STHY0425/LeRobot-Anything-U-Arm-main/src/simulation/mani_skill/agents/robots/humanoid/mujoco_humanoid.png

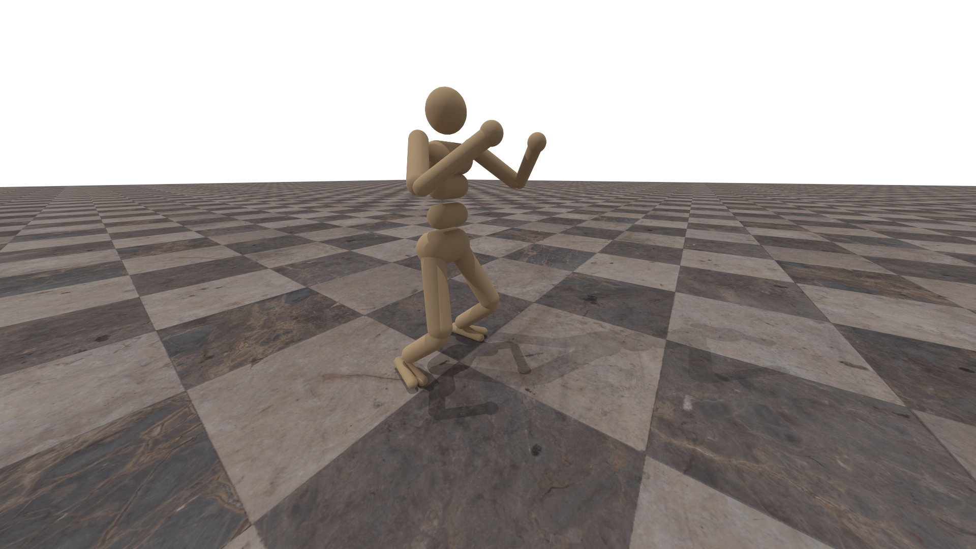
src/simulation/mani_skill/agents/robots/humanoid/mujoco_humanoid.png
