STHY0425/LeRobot-Anything-U-Arm-main/src/simulation/mani_skill/assets/robots/fetch/fetch_description/meshes/base_link_uv.png

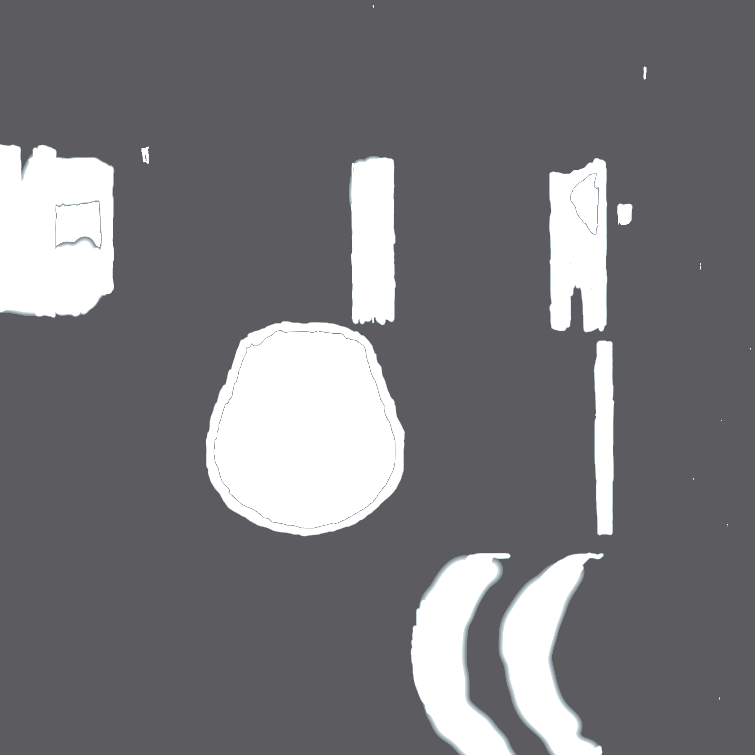
src/simulation/mani_skill/assets/robots/fetch/fetch_description/meshes/base_link_uv.png
