STHY0425/LeRobot-Anything-U-Arm-main/src/simulation/mani_skill/envs/tasks/humanoid/assets/cardboard_box/01.png

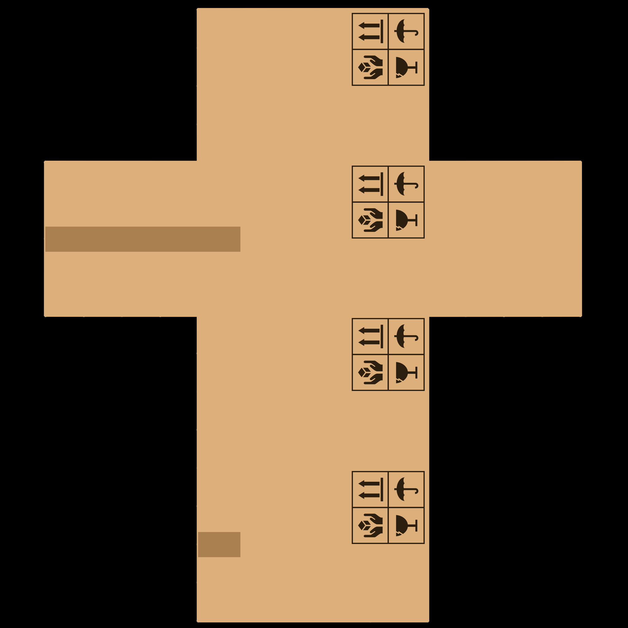
src/simulation/mani_skill/envs/tasks/humanoid/assets/cardboard_box/01.png
