STHY0425/LeRobot-Anything-U-Arm-main/src/simulation/mani_skill/assets/robots/trifinger/robot_properties_fingers/meshes/BL-M_Table_ASM_big.stl

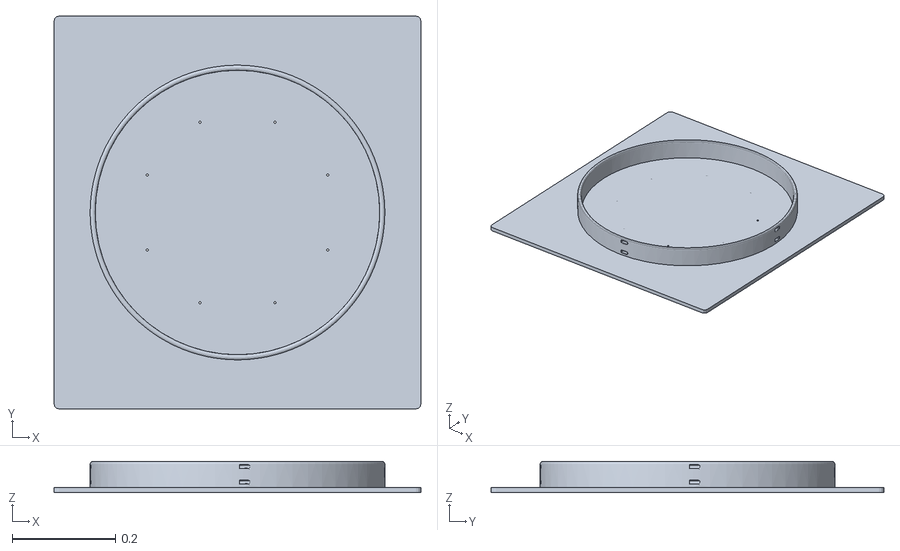
[picture p15: CAD file, 2026-03-09]
src/simulation/mani_skill/assets/robots/trifinger/robot_properties_fingers/meshes/BL-M_Table_ASM_big.stl
0.71 x 0.76 x 0.06
