STHY0425/LeRobot-Anything-U-Arm-main/src/simulation/mani_skill/assets/robots/trifinger/robot_properties_fingers/meshes/BL-M_Table_ASM_small.stl

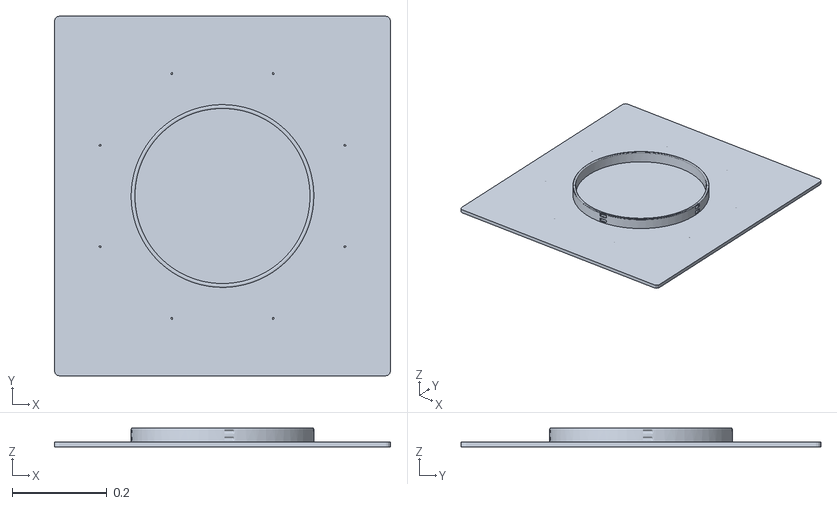
[picture p16: CAD file, 2026-03-09]
src/simulation/mani_skill/assets/robots/trifinger/robot_properties_fingers/meshes/BL-M_Table_ASM_small.stl
0.71 x 0.76 x 0.04
