STHY0425/LeRobot-Anything-U-Arm-main/mechanical/Feetech_servo/Config1_STL/config1 - sitter-1.STL

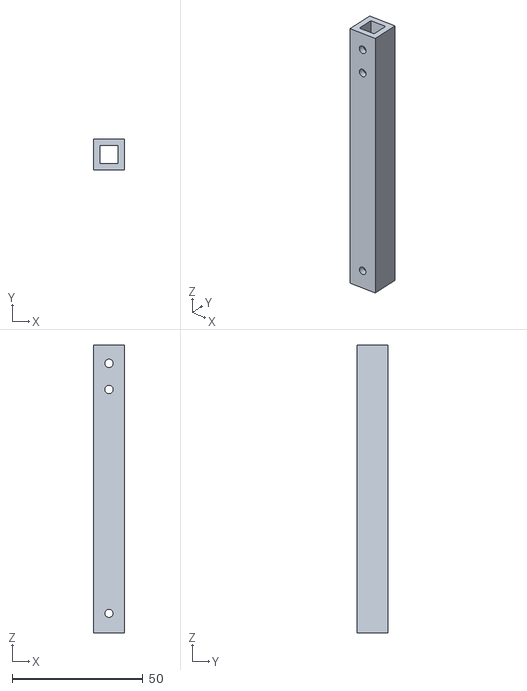
[picture p17: CAD file, 2026-03-09]
mechanical/Feetech_servo/Config1_STL/config1 - sitter-1.STL
12.0 x 12.0 x 110.0
