STHY0425/LeRobot-Anything-U-Arm-main/mechanical/Feetech_servo/Config2_STL/config2 - link1-1.STL

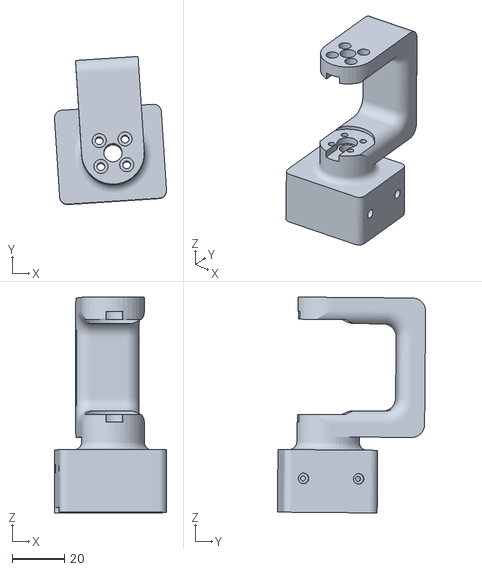
[picture p18: CAD file, 2026-03-09]
mechanical/Feetech_servo/Config2_STL/config2 - link1-1.STL
42.9 x 56.7 x 82.7
