STHY0425/LeRobot-Anything-U-Arm-main/mechanical/Feetech_servo/Config3_STL/config3 - trigger_short-1.STL

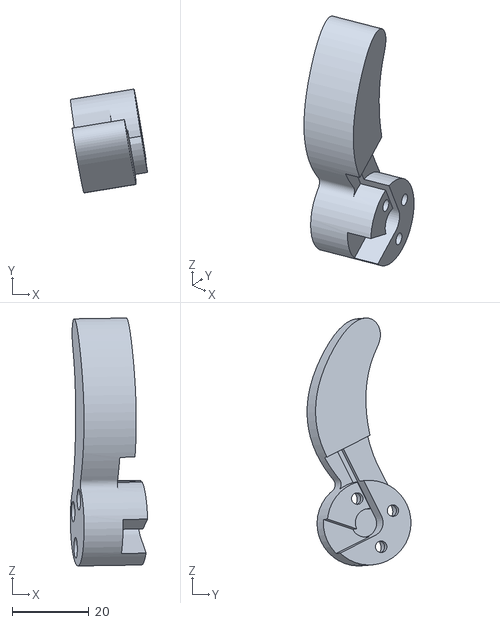
[picture p19: CAD file, 2026-03-09]
mechanical/Feetech_servo/Config3_STL/config3 - trigger_short-1.STL
20.1 x 27.0 x 64.4
