STHY0425/LeRobot-Anything-U-Arm-main/mechanical/Zhonglin_servo/Config1_STL/Config1 - trigger_handle-1.STL

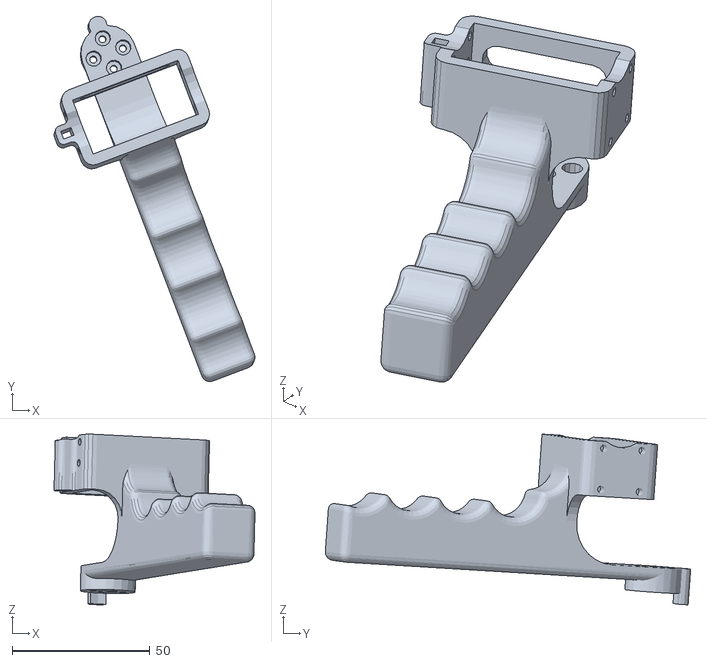
[picture p20: CAD file, 2026-03-09]
mechanical/Zhonglin_servo/Config1_STL/Config1 - trigger_handle-1.STL
73.0 x 132.8 x 62.0
