STHY0425/LeRobot-Anything-U-Arm-main/mechanical/Zhonglin_servo/Config2_STL/Config2 - link_1-2.STL

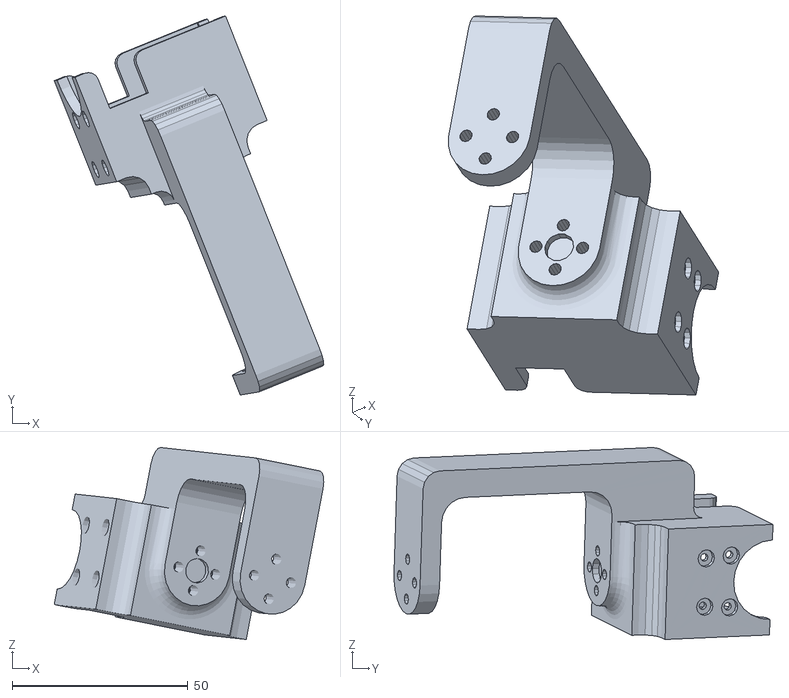
[picture p21: CAD file, 2026-03-09]
mechanical/Zhonglin_servo/Config2_STL/Config2 - link_1-2.STL
76.7 x 107.8 x 54.6
