STHY0425/LeRobot-Anything-U-Arm-main/mechanical/Zhonglin_servo/Config3_STL/Config3 - link_1-1.STL

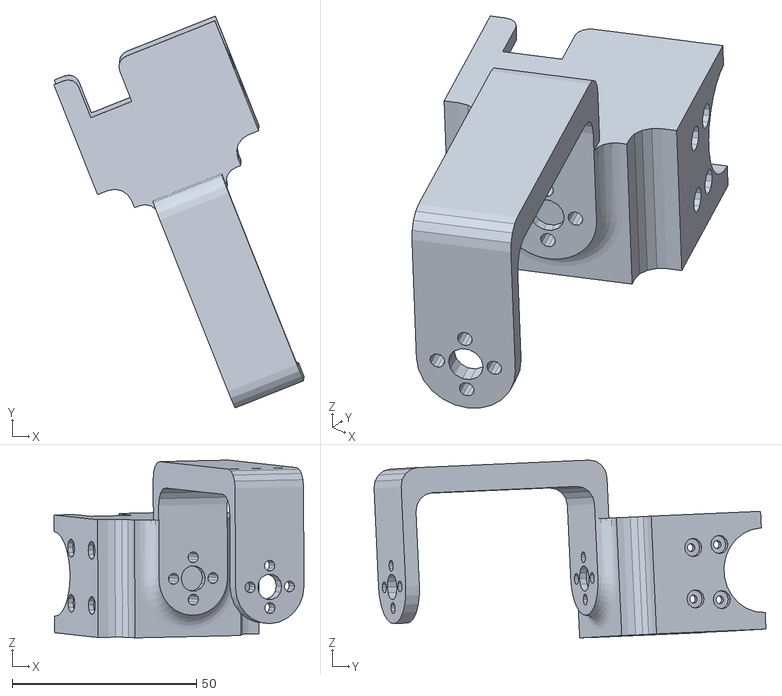
[picture p22: CAD file, 2026-03-09]
mechanical/Zhonglin_servo/Config3_STL/Config3 - link_1-1.STL
67.9 x 106.4 x 48.3
