STHY0425/LeRobot-Anything-U-Arm-main/src/simulation/mani_skill/assets/robots/ability_hand/meshes/collision/thumb-F2_C.obj

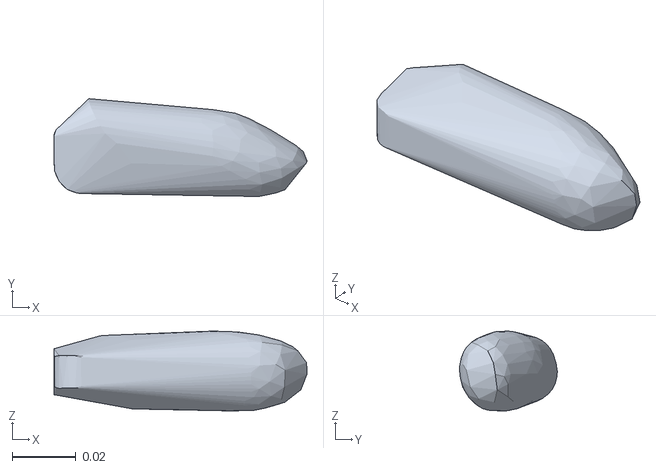
[picture p23: CAD file, 2026-03-09]
src/simulation/mani_skill/assets/robots/ability_hand/meshes/collision/thumb-F2_C.obj
0.0793 x 0.0306 x 0.025
