STHY0425/LeRobot-Anything-U-Arm-main/src/simulation/mani_skill/assets/robots/ability_hand/meshes/visual/FB_palm_ref_MIR.obj

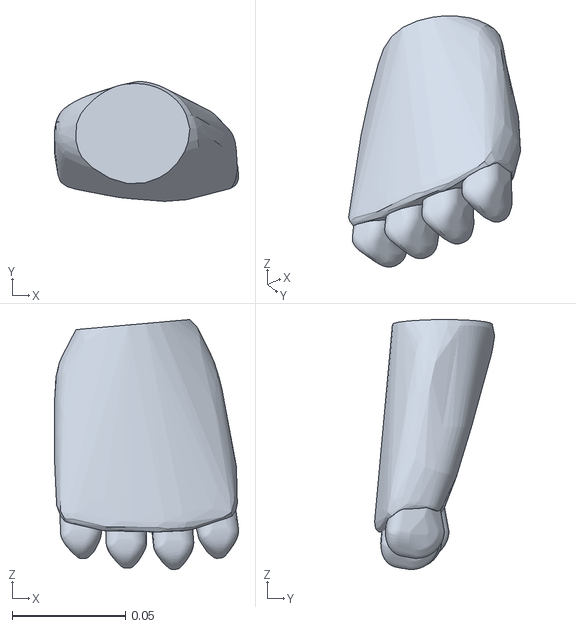
[picture p24: CAD file, 2026-03-09]
src/simulation/mani_skill/assets/robots/ability_hand/meshes/visual/FB_palm_ref_MIR.obj
0.0816 x 0.053 x 0.111
