STHY0425/LeRobot-Anything-U-Arm-main/src/simulation/mani_skill/assets/robots/allegro/meshes/collision/link_tip.obj

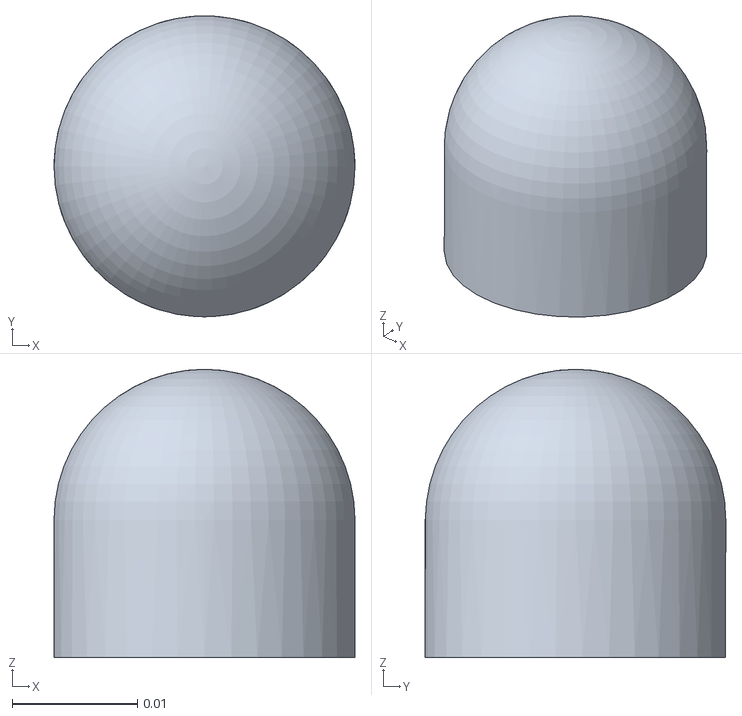
[picture p25: CAD file, 2026-03-09]
src/simulation/mani_skill/assets/robots/allegro/meshes/collision/link_tip.obj
0.024 x 0.024 x 0.023
