STHY0425/LeRobot-Anything-U-Arm-main/src/simulation/mani_skill/assets/robots/allegro/variation/meshes/visual/tactile.obj

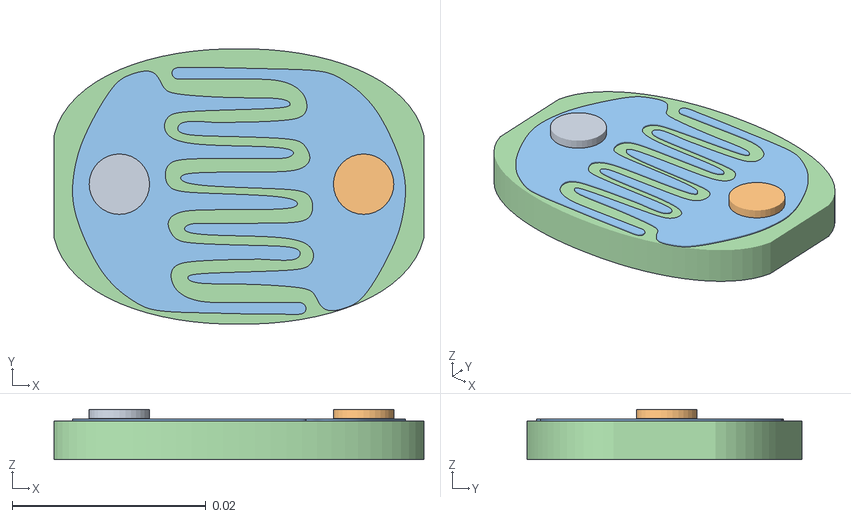
[picture p28: CAD file, 2026-03-09]
src/simulation/mani_skill/assets/robots/allegro/variation/meshes/visual/tactile.obj
0.0382 x 0.0284 x 0.00519
LIGHT_CATCHER_2
photocell
