STHY0425/LeRobot-Anything-U-Arm-main/src/simulation/mani_skill/assets/robots/ARX-X5/meshes/link3.STL

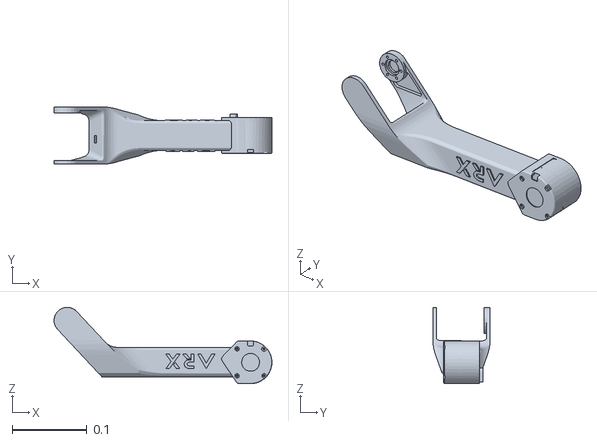
[picture p29: CAD file, 2026-03-09]
src/simulation/mani_skill/assets/robots/ARX-X5/meshes/link3.STL
0.291 x 0.0765 x 0.102
