STHY0425/LeRobot-Anything-U-Arm-main/src/simulation/mani_skill/assets/robots/dclaw/meshes/collision/finger_tip.obj

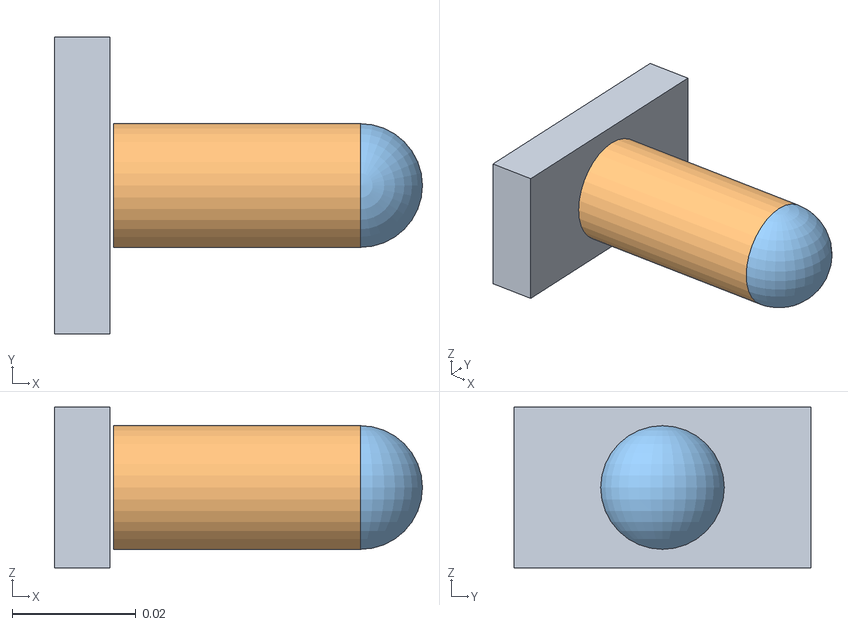
[picture p30: CAD file, 2026-03-09]
src/simulation/mani_skill/assets/robots/dclaw/meshes/collision/finger_tip.obj
0.0595 x 0.048 x 0.026
