STHY0425/LeRobot-Anything-U-Arm-main/src/simulation/mani_skill/assets/robots/dclaw/meshes/visual/link_1.obj

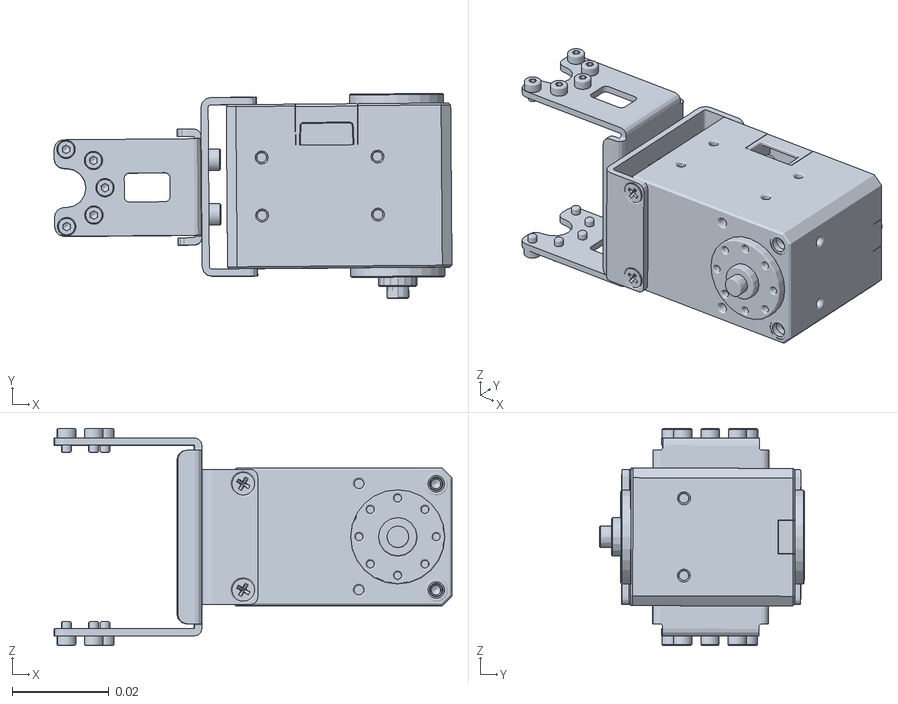
[picture p31: CAD file, 2026-03-09]
src/simulation/mani_skill/assets/robots/dclaw/meshes/visual/link_1.obj
0.0824 x 0.0425 x 0.045
