STHY0425/LeRobot-Anything-U-Arm-main/src/simulation/mani_skill/assets/robots/fetch/fetch_description/meshes/l_gripper_finger_link.STL

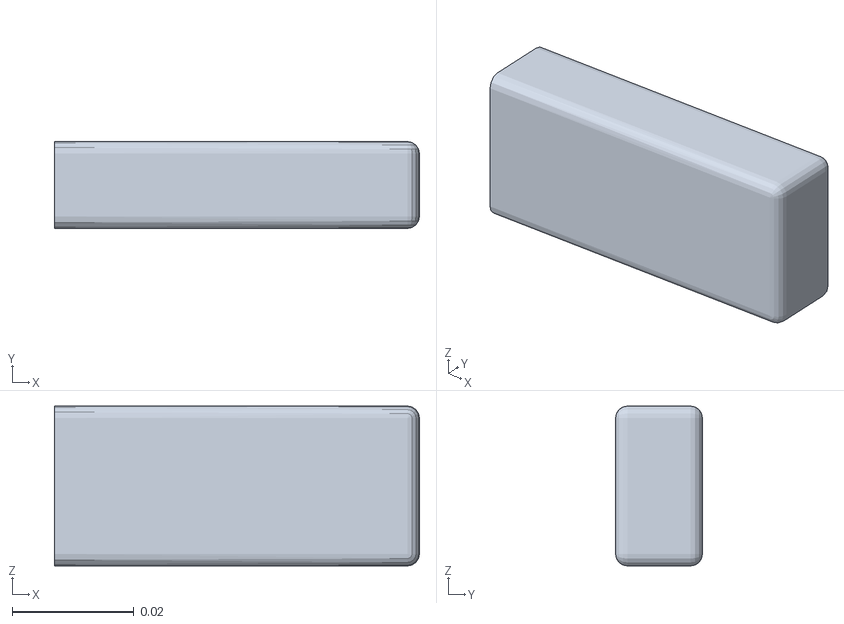
[picture p32: CAD file, 2026-03-09]
src/simulation/mani_skill/assets/robots/fetch/fetch_description/meshes/l_gripper_finger_link.STL
0.06 x 0.0143 x 0.0263
