STHY0425/LeRobot-Anything-U-Arm-main/src/simulation/mani_skill/assets/robots/fetch_xlerobot/meshes/Fixed_Jaw_part1.ply.convex.stl

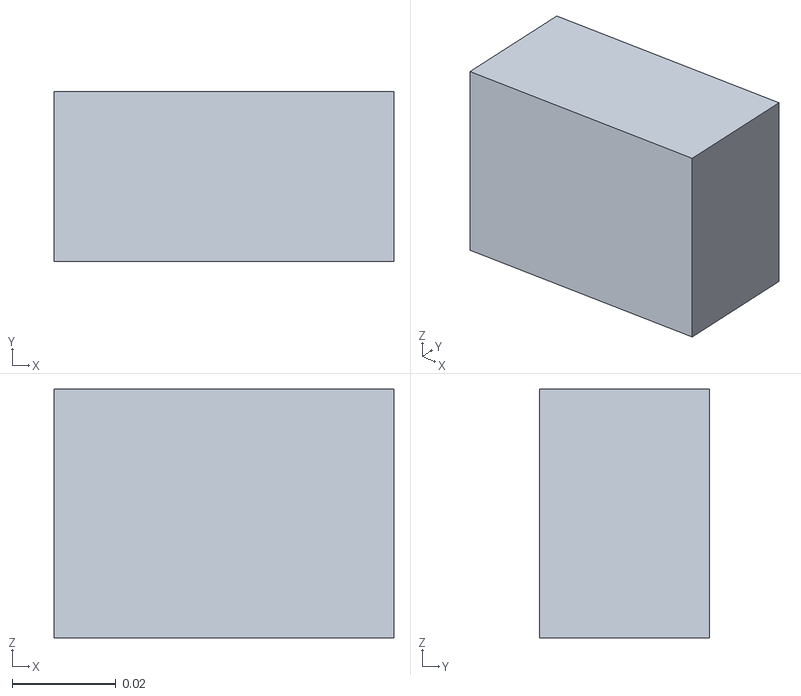
[picture p33: CAD file, 2026-03-09]
src/simulation/mani_skill/assets/robots/fetch_xlerobot/meshes/Fixed_Jaw_part1.ply.convex.stl
0.0656 x 0.0328 x 0.048
