STHY0425/LeRobot-Anything-U-Arm-main/src/simulation/mani_skill/assets/robots/g1_humanoid/meshes/right_two_link.STL

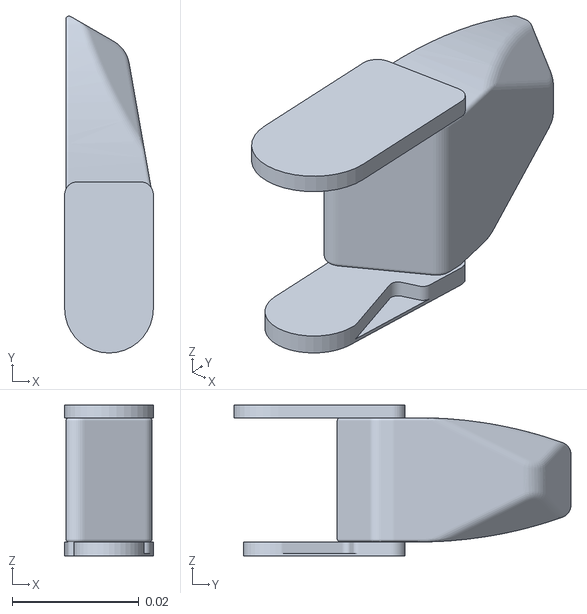
[picture p34: CAD file, 2026-03-09]
src/simulation/mani_skill/assets/robots/g1_humanoid/meshes/right_two_link.STL
0.014 x 0.0532 x 0.0238
