STHY0425/LeRobot-Anything-U-Arm-main/src/simulation/mani_skill/assets/robots/koch/meshes/link_2.stl

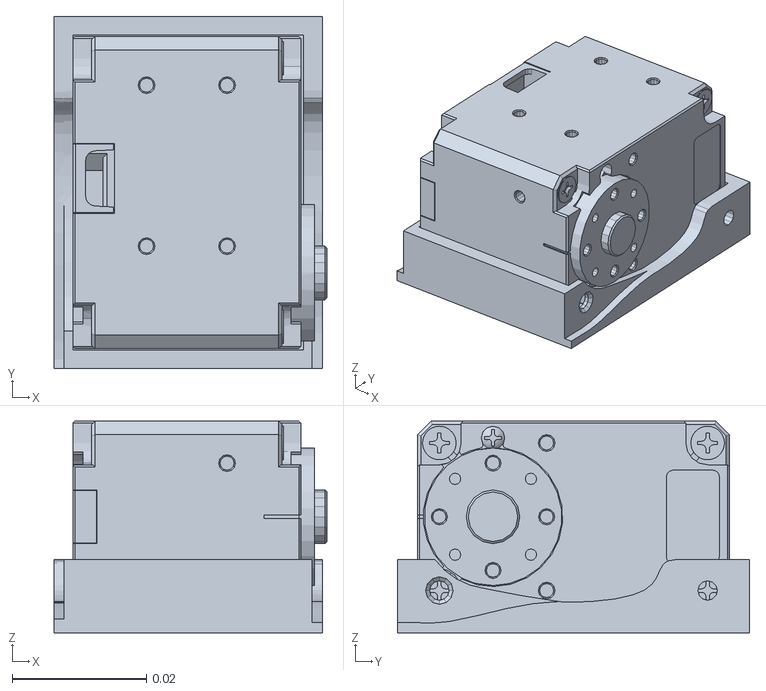
[picture p35: CAD file, 2026-03-09]
src/simulation/mani_skill/assets/robots/koch/meshes/link_2.stl
0.0407 x 0.0525 x 0.0316
