STHY0425/LeRobot-Anything-U-Arm-main/src/simulation/mani_skill/assets/robots/panda/franka_description/meshes/collision/link6.stl.convex.stl

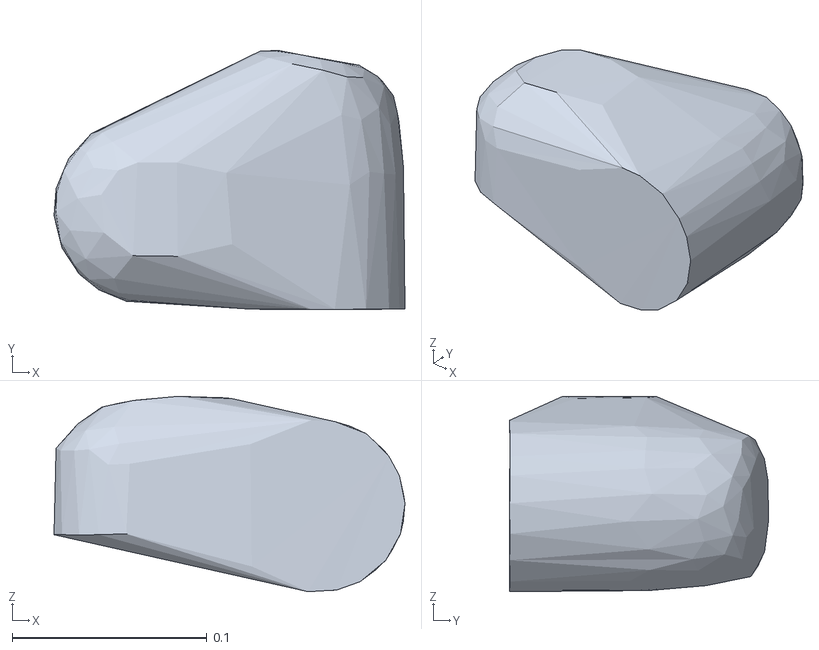
[picture p36: CAD file, 2026-03-09]
src/simulation/mani_skill/assets/robots/panda/franka_description/meshes/collision/link6.stl.convex.stl
0.18 x 0.133 x 0.1
