STHY0425/LeRobot-Anything-U-Arm-main/src/simulation/mani_skill/assets/robots/panda/sciurus17_description/meshes/collision/Body.stl

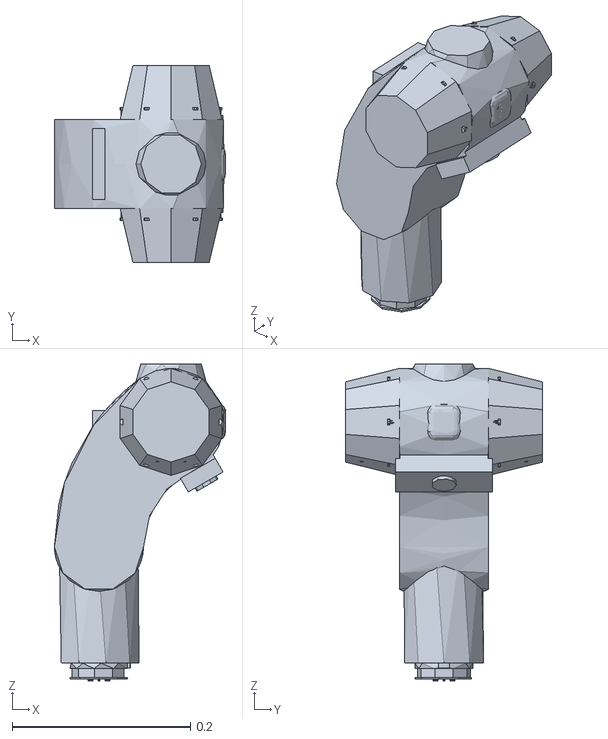
[picture p38: CAD file, 2026-03-09]
src/simulation/mani_skill/assets/robots/panda/sciurus17_description/meshes/collision/Body.stl
0.192 x 0.221 x 0.356
