STHY0425/LeRobot-Anything-U-Arm-main/src/simulation/mani_skill/assets/robots/piper/meshes/link1.STL

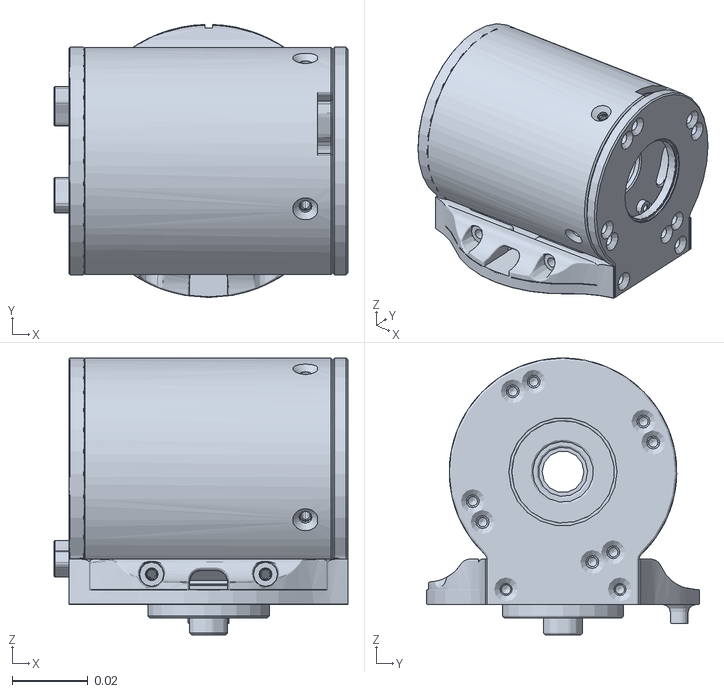
[picture p40: CAD file, 2026-03-09]
src/simulation/mani_skill/assets/robots/piper/meshes/link1.STL
0.0775 x 0.072 x 0.073
