STHY0425/LeRobot-Anything-U-Arm-main/src/simulation/mani_skill/assets/robots/rm65b/meshes/RM65/Link6_6fb.STL

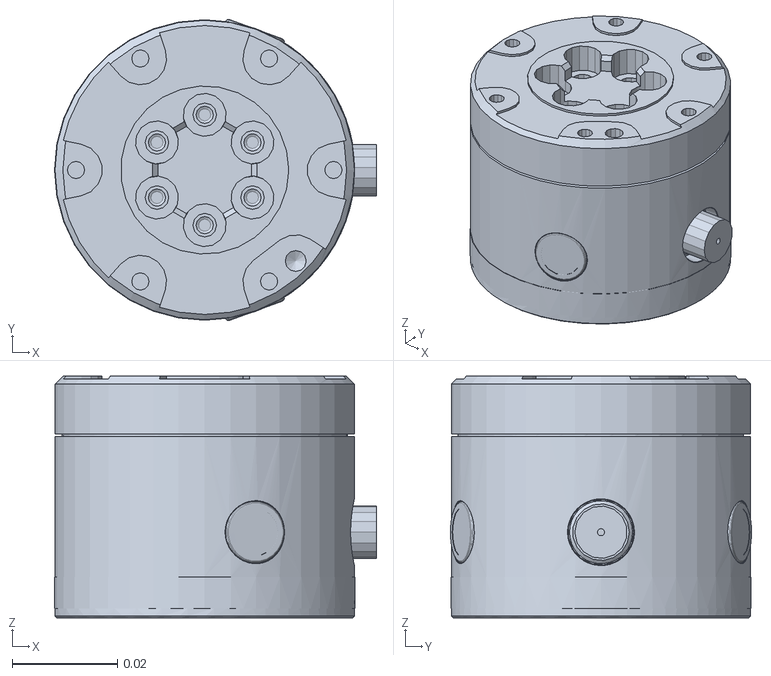
[picture p41: CAD file, 2026-03-09]
src/simulation/mani_skill/assets/robots/rm65b/meshes/RM65/Link6_6fb.STL
0.0613 x 0.0574 x 0.046
