STHY0425/LeRobot-Anything-U-Arm-main/src/simulation/mani_skill/assets/robots/so100/meshes/Base.stl

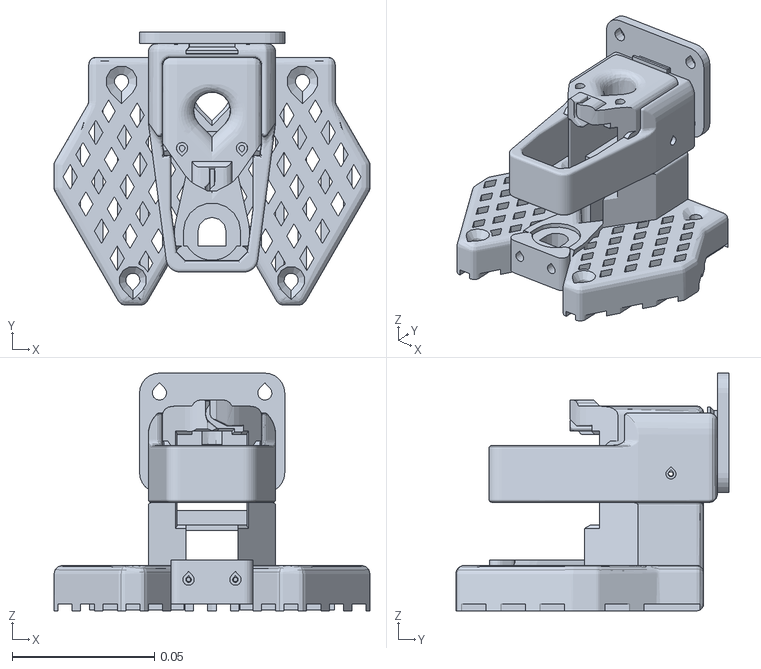
[picture p42: CAD file, 2026-03-09]
src/simulation/mani_skill/assets/robots/so100/meshes/Base.stl
0.111 x 0.0959 x 0.0835
