STHY0425/LeRobot-Anything-U-Arm-main/src/simulation/mani_skill/assets/robots/trifinger/objects/meshes/ball.obj

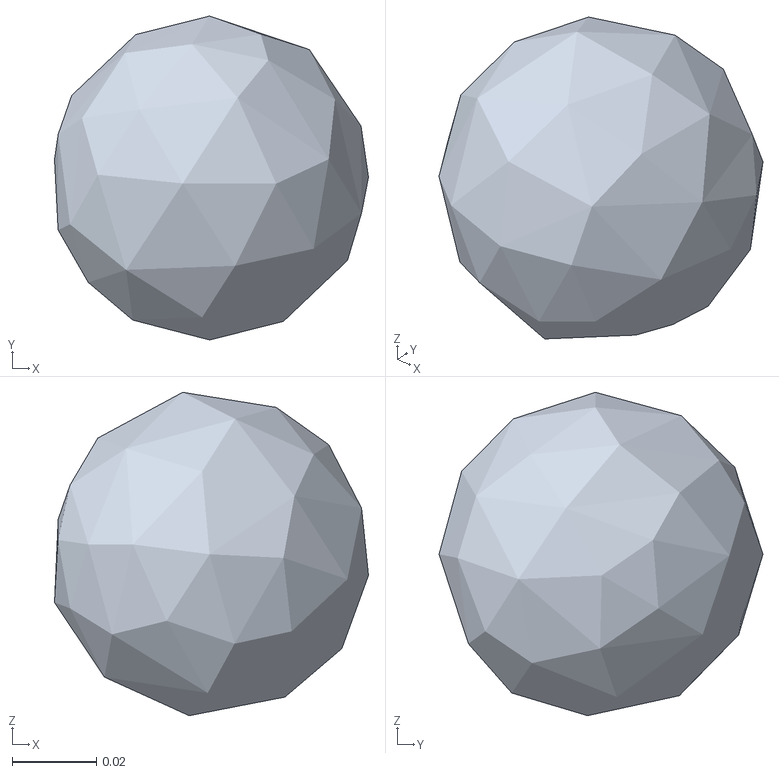
[picture p43: CAD file, 2026-03-09]
src/simulation/mani_skill/assets/robots/trifinger/objects/meshes/ball.obj
0.0745 x 0.0768 x 0.0767
