STHY0425/LeRobot-Anything-U-Arm-main/src/simulation/mani_skill/assets/robots/trifinger/robot_properties_fingers/meshes/edu/base_side_right.stl

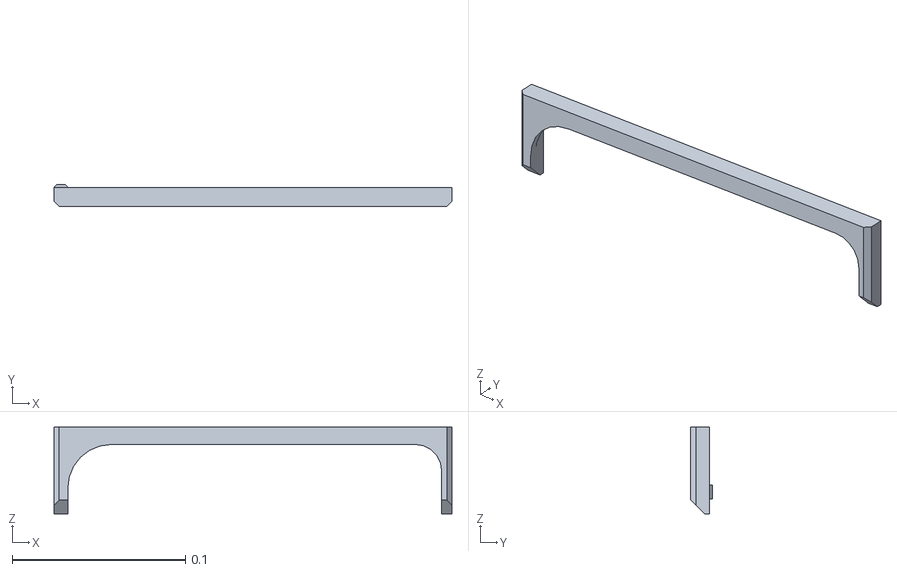
[picture p44: CAD file, 2026-03-09]
src/simulation/mani_skill/assets/robots/trifinger/robot_properties_fingers/meshes/edu/base_side_right.stl
0.229 x 0.0125 x 0.05
