STHY0425/LeRobot-Anything-U-Arm-main/src/simulation/mani_skill/assets/robots/trifinger/robot_properties_fingers/meshes/pro/motor_sim.stl

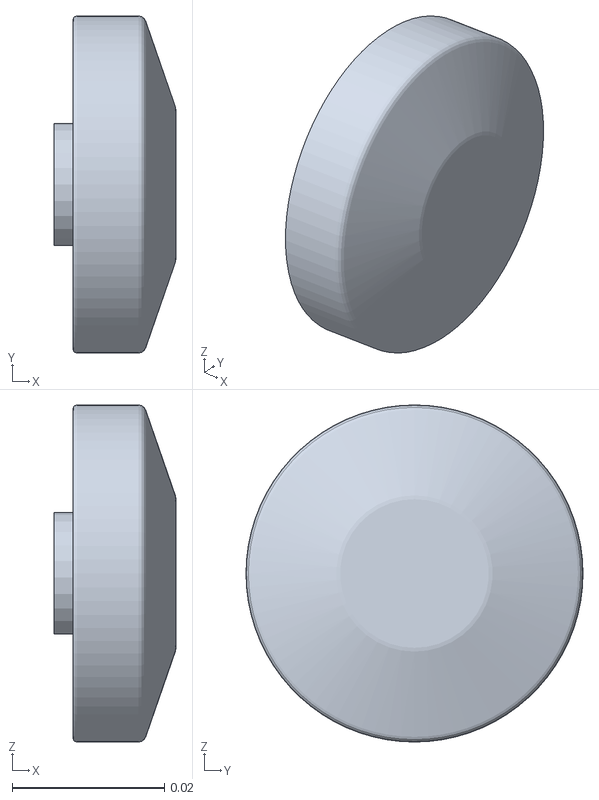
[picture p46: CAD file, 2026-03-09]
src/simulation/mani_skill/assets/robots/trifinger/robot_properties_fingers/meshes/pro/motor_sim.stl
0.016 x 0.0442 x 0.0442
