STHY0425/LeRobot-Anything-U-Arm-main/src/simulation/mani_skill/assets/robots/trifinger/robot_properties_fingers/meshes/Tip_link_Modular_SIM.stl

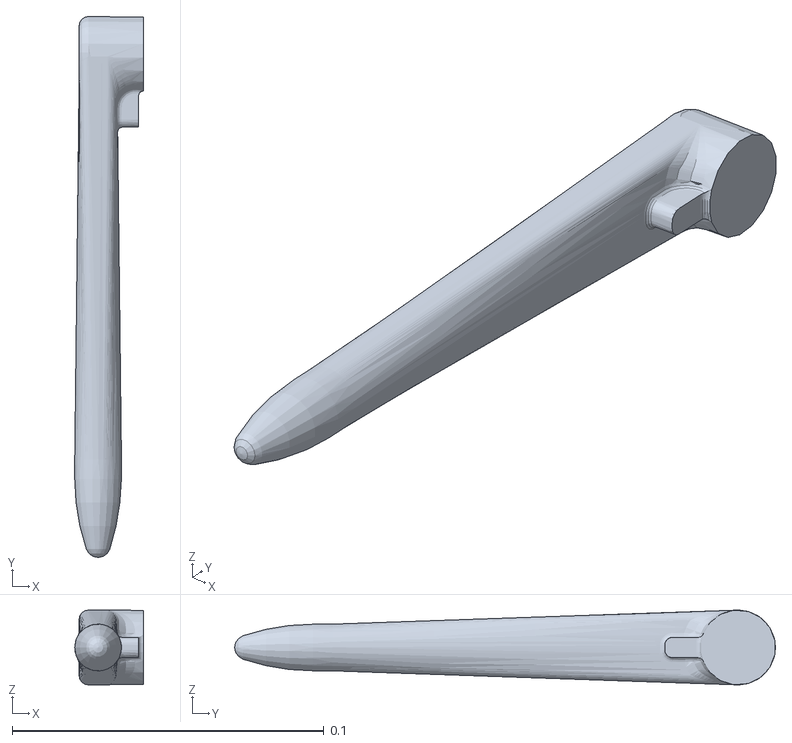
[picture p47: CAD file, 2026-03-09]
src/simulation/mani_skill/assets/robots/trifinger/robot_properties_fingers/meshes/Tip_link_Modular_SIM.stl
0.022 x 0.174 x 0.024
