STHY0425/LeRobot-Anything-U-Arm-main/src/simulation/mani_skill/assets/robots/xarm7/meshes/collision/link2.obj

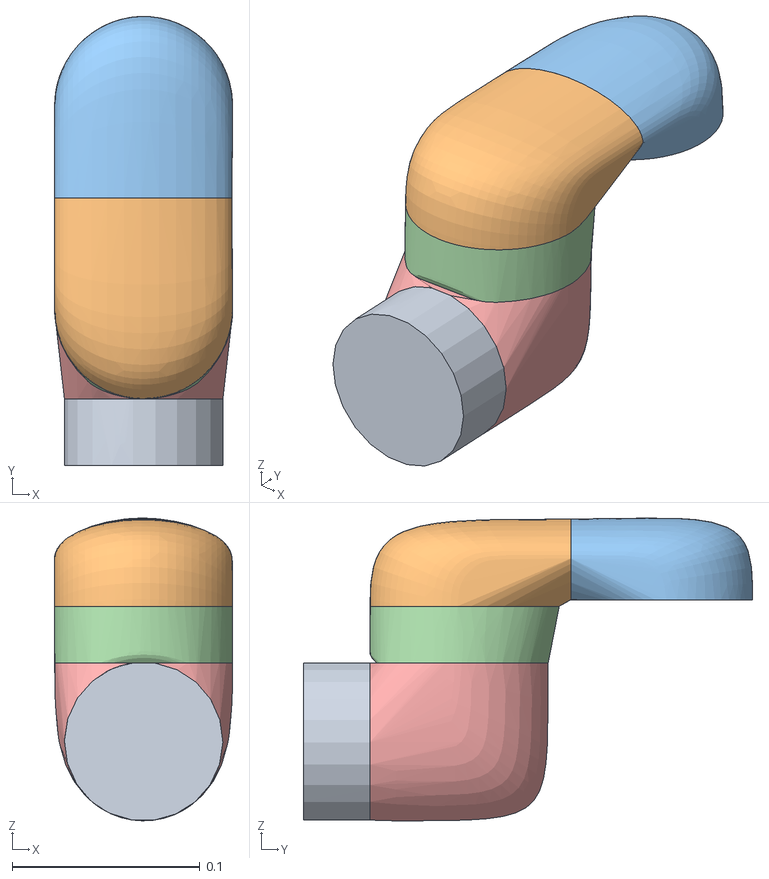
[picture p48: CAD file, 2026-03-09]
src/simulation/mani_skill/assets/robots/xarm7/meshes/collision/link2.obj
0.095 x 0.239 x 0.161
geometry_0
geometry_1
geometry_2
geometry_3
geometry_4
