STHY0425/LeRobot-Anything-U-Arm-main/src/simulation/mani_skill/envs/tasks/fmb/assets/purple_u.ply

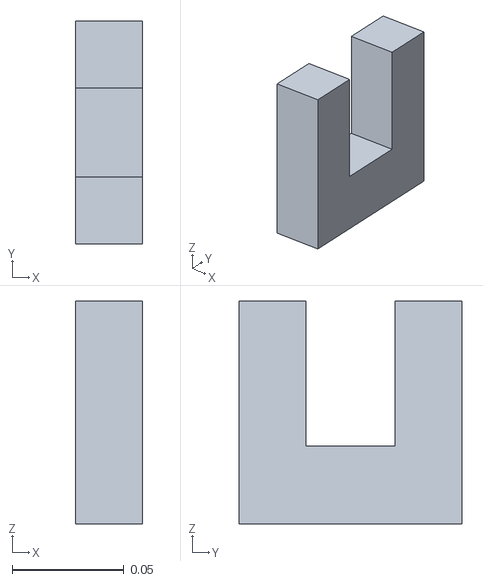
[picture p49: CAD file, 2026-03-09]
src/simulation/mani_skill/envs/tasks/fmb/assets/purple_u.ply
0.03 x 0.1 x 0.1
