STHY0425/LeRobot-Anything-U-Arm-main/src/simulation/mani_skill/envs/tasks/humanoid/assets/apple_1.ply

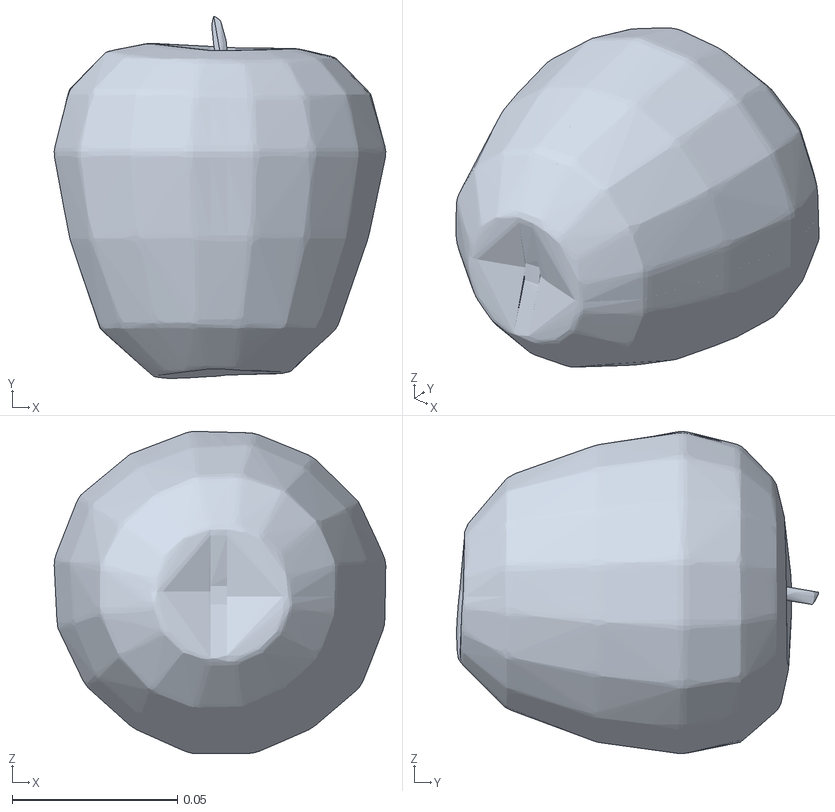
[picture p50: CAD file, 2026-03-09]
src/simulation/mani_skill/envs/tasks/humanoid/assets/apple_1.ply
0.1 x 0.11 x 0.0975
