STHY0425/LeRobot-Anything-U-Arm-main/src/simulation/mani_skill/envs/tasks/humanoid/assets/cardboard_box/textured.obj

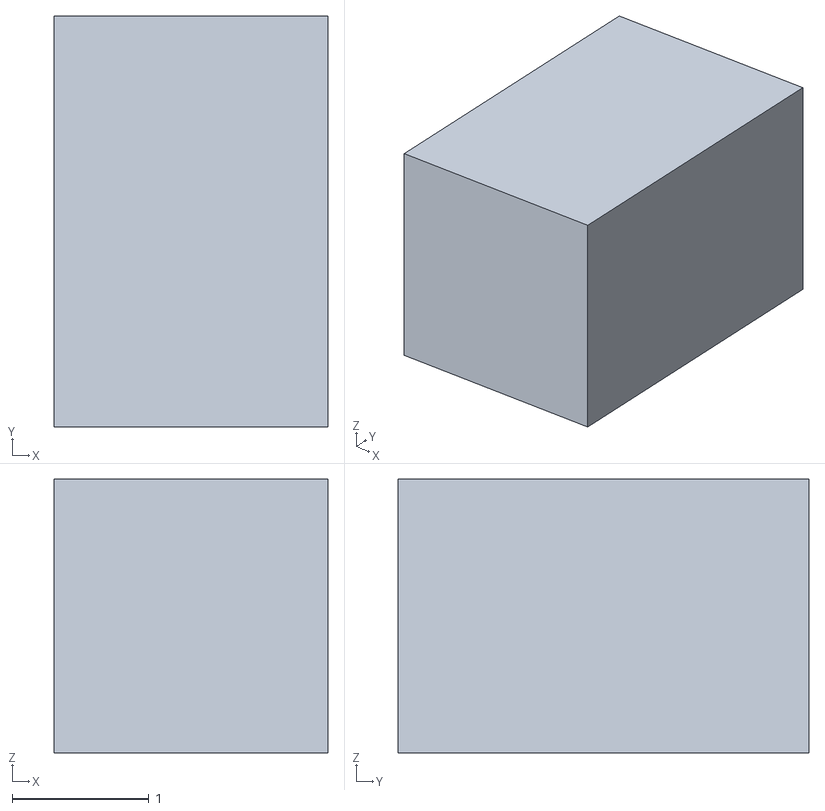
[picture p51: CAD file, 2026-03-09]
src/simulation/mani_skill/envs/tasks/humanoid/assets/cardboard_box/textured.obj
2.00 x 3.00 x 2.00
