STHY0425/LeRobot-Anything-U-Arm-main/mechanical/Feetech_servo/Config1_STL/config1 - link2-1.STL

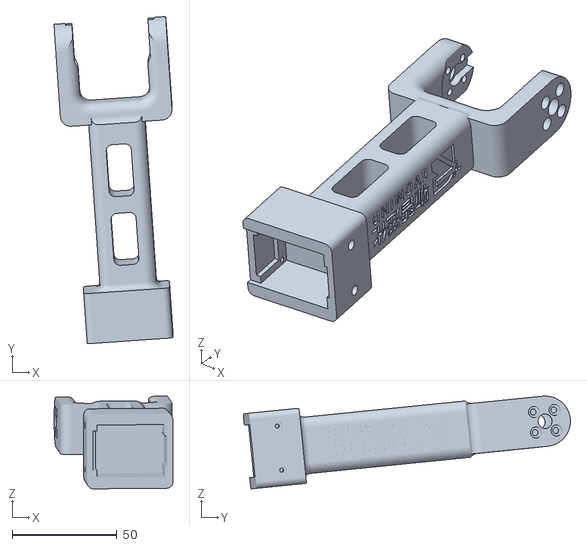
[picture p52: CAD file, 2026-03-09]
mechanical/Feetech_servo/Config1_STL/config1 - link2-1.STL
56.7 x 156.1 x 44.3
