STHY0425/LeRobot-Anything-U-Arm-main/mechanical/Feetech_servo/Config2_STL/config2 - link2-1.STL

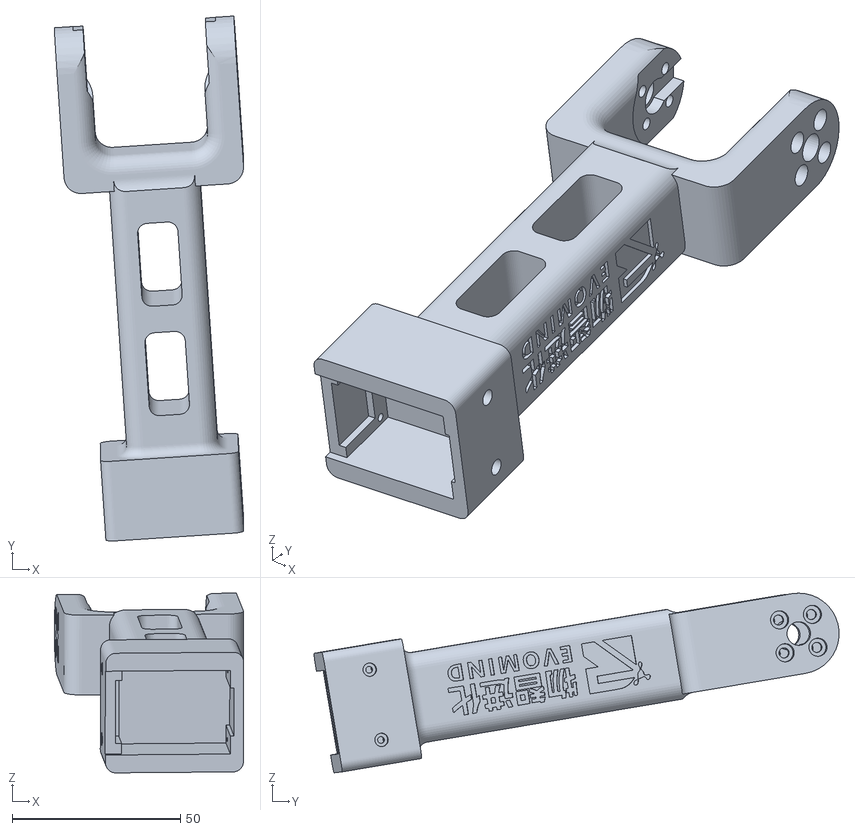
[picture p53: CAD file, 2026-03-09]
mechanical/Feetech_servo/Config2_STL/config2 - link2-1.STL
56.2 x 155.8 x 53.4
