STHY0425/LeRobot-Anything-U-Arm-main/mechanical/Feetech_servo/Config3_STL/config3 - link6-1.STL

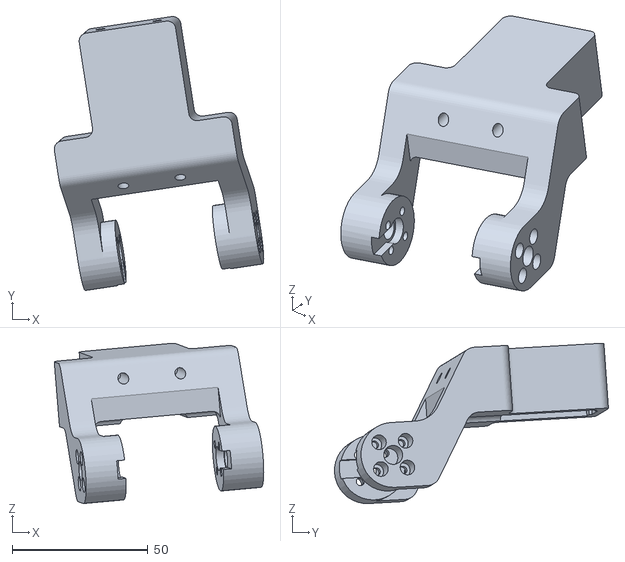
[picture p54: CAD file, 2026-03-09]
mechanical/Feetech_servo/Config3_STL/config3 - link6-1.STL
77.1 x 100.9 x 59.0
