STHY0425/LeRobot-Anything-U-Arm-main/mechanical/Zhonglin_servo/Config1_STL/Config1 - link_1-2.STL

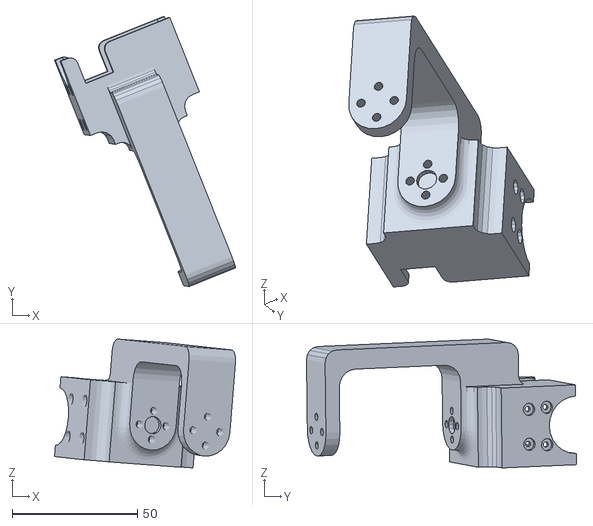
[picture p55: CAD file, 2026-03-09]
mechanical/Zhonglin_servo/Config1_STL/Config1 - link_1-2.STL
72.3 x 107.9 x 51.5
