STHY0425/LeRobot-Anything-U-Arm-main/mechanical/Zhonglin_servo/Config2_STL/Config2 - Base_gen-1.STL

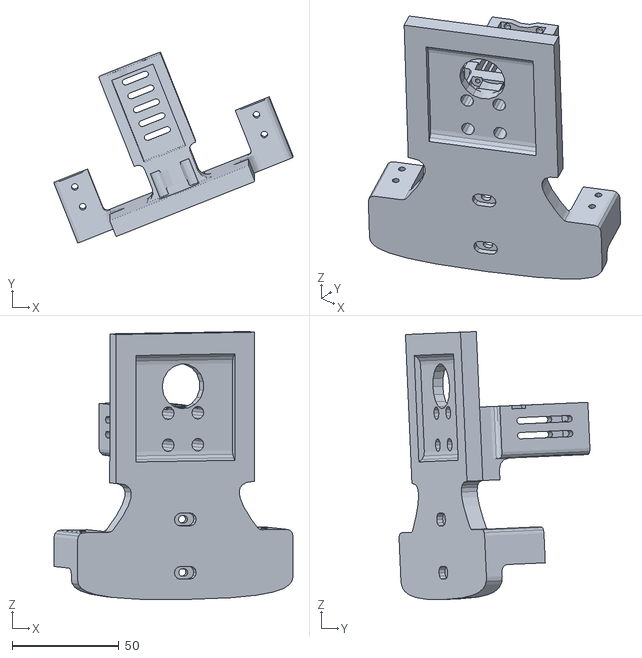
[picture p56: CAD file, 2026-03-09]
mechanical/Zhonglin_servo/Config2_STL/Config2 - Base_gen-1.STL
112.1 x 89.5 x 125.8
