STHY0425/LeRobot-Anything-U-Arm-main/mechanical/Zhonglin_servo/Config3_STL/Config3 - trigger_handle-1.STL

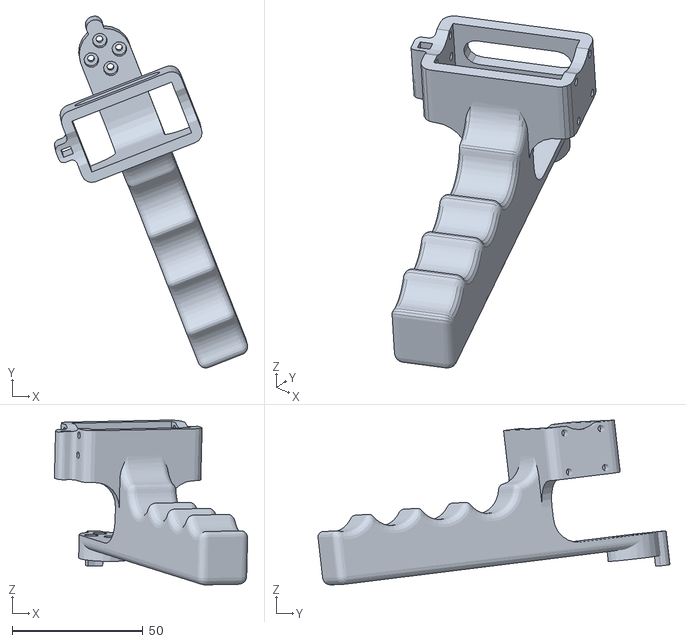
[picture p57: CAD file, 2026-03-09]
mechanical/Zhonglin_servo/Config3_STL/Config3 - trigger_handle-1.STL
73.8 x 134.5 x 63.0
