STHY0425/LeRobot-Anything-U-Arm-main/src/simulation/mani_skill/assets/robots/ability_hand/meshes/collision/FB_palm_ref_MIR.obj

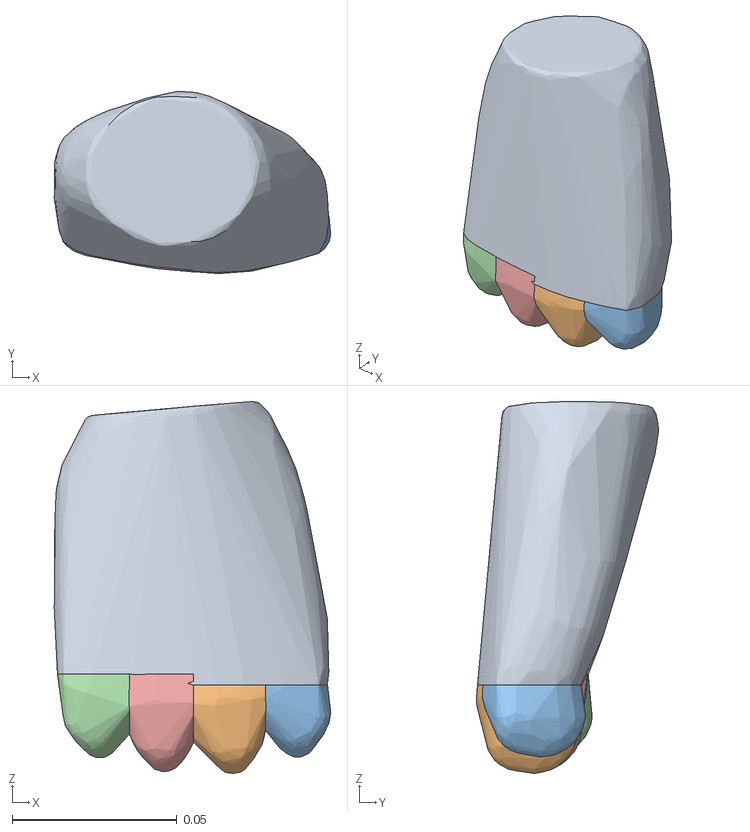
[picture p58: CAD file, 2026-03-09]
src/simulation/mani_skill/assets/robots/ability_hand/meshes/collision/FB_palm_ref_MIR.obj
0.0838 x 0.0552 x 0.113
geometry_0
geometry_1
geometry_2_geometry_2
geometry_3
geometry_4
