STHY0425/LeRobot-Anything-U-Arm-main/src/simulation/mani_skill/assets/robots/ability_hand/meshes/visual/thumb-F1.obj

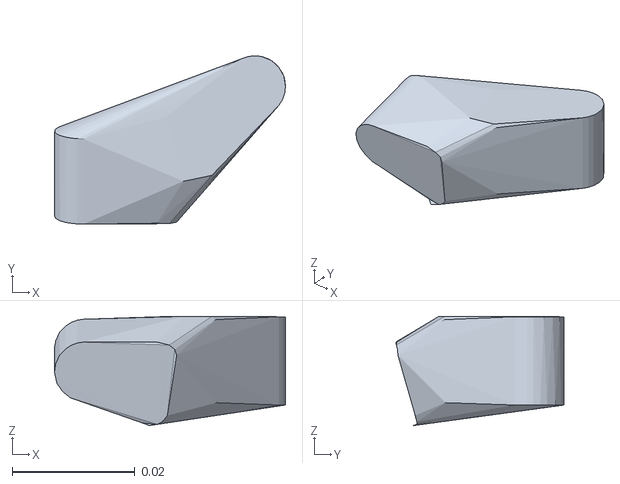
[picture p59: CAD file, 2026-03-09]
src/simulation/mani_skill/assets/robots/ability_hand/meshes/visual/thumb-F1.obj
0.0377 x 0.0275 x 0.0178
