STHY0425/LeRobot-Anything-U-Arm-main/src/simulation/mani_skill/assets/robots/allegro/variation/meshes/visual/longer_finger_tip.obj

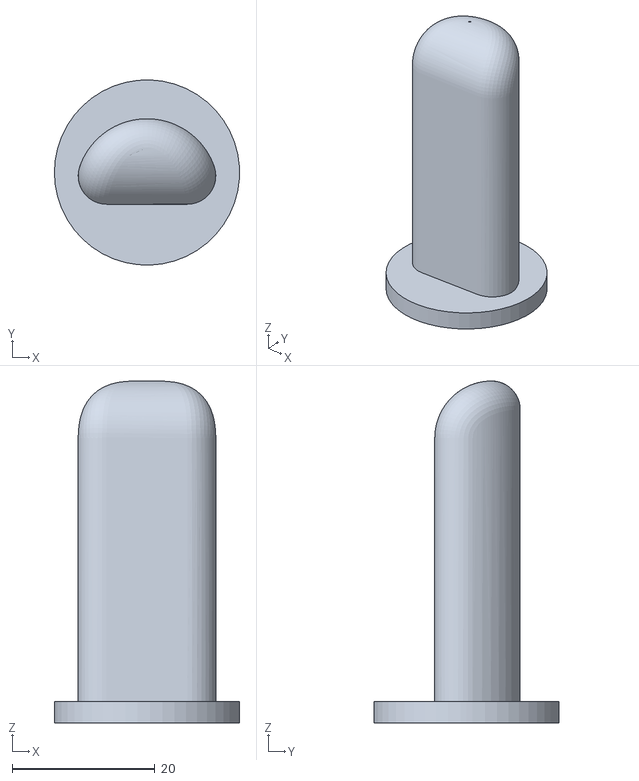
[picture p60: CAD file, 2026-03-09]
src/simulation/mani_skill/assets/robots/allegro/variation/meshes/visual/longer_finger_tip.obj
26.0 x 26.0 x 48.0
