STHY0425/LeRobot-Anything-U-Arm-main/src/simulation/mani_skill/assets/robots/ARX-X5/meshes/link4.STL

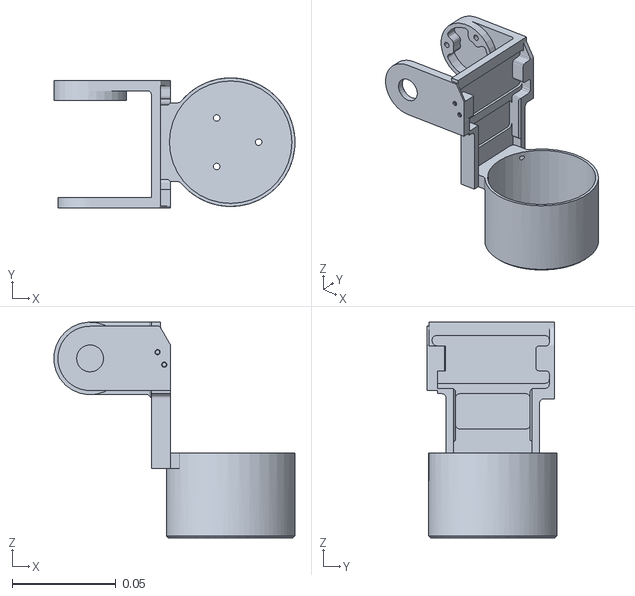
[picture p61: CAD file, 2026-03-09]
src/simulation/mani_skill/assets/robots/ARX-X5/meshes/link4.STL
0.116 x 0.0627 x 0.104
