STHY0425/LeRobot-Anything-U-Arm-main/src/simulation/mani_skill/assets/robots/dclaw/meshes/collision/base_link_cylinder.obj

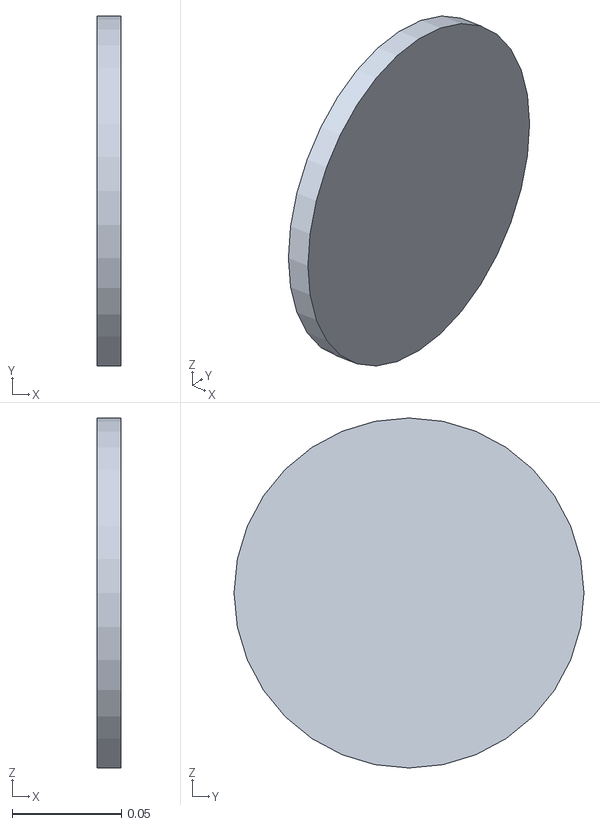
[picture p62: CAD file, 2026-03-09]
src/simulation/mani_skill/assets/robots/dclaw/meshes/collision/base_link_cylinder.obj
0.011 x 0.16 x 0.16
