STHY0425/LeRobot-Anything-U-Arm-main/src/simulation/mani_skill/assets/robots/dclaw/meshes/visual/link_3.obj

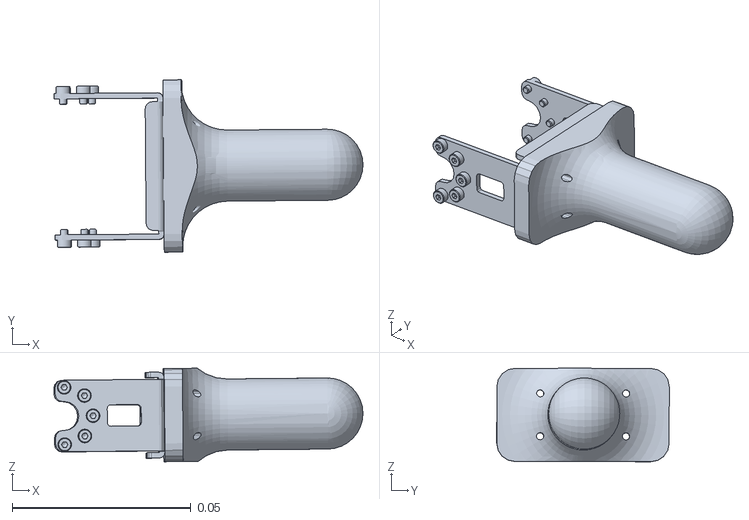
[picture p63: CAD file, 2026-03-09]
src/simulation/mani_skill/assets/robots/dclaw/meshes/visual/link_3.obj
0.0864 x 0.0482 x 0.0262
