STHY0425/LeRobot-Anything-U-Arm-main/src/simulation/mani_skill/assets/robots/fetch/fetch_description/meshes/shoulder_pan_link_collision.STL

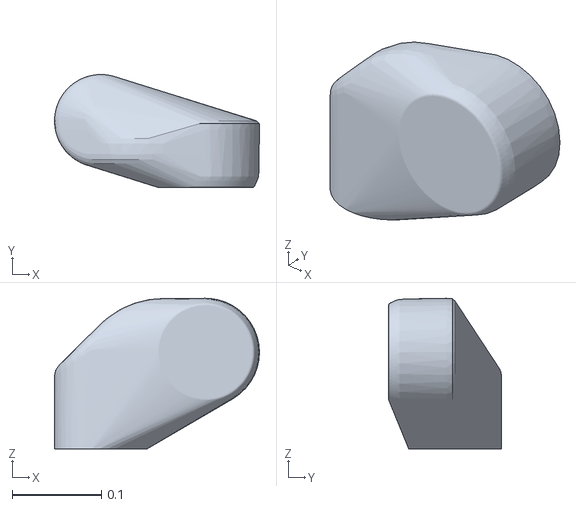
[picture p64: CAD file, 2026-03-09]
src/simulation/mani_skill/assets/robots/fetch/fetch_description/meshes/shoulder_pan_link_collision.STL
0.229 x 0.127 x 0.168
