STHY0425/LeRobot-Anything-U-Arm-main/src/simulation/mani_skill/assets/robots/fetch_xlerobot/meshes/Lower_Arm.stl.convex.stl

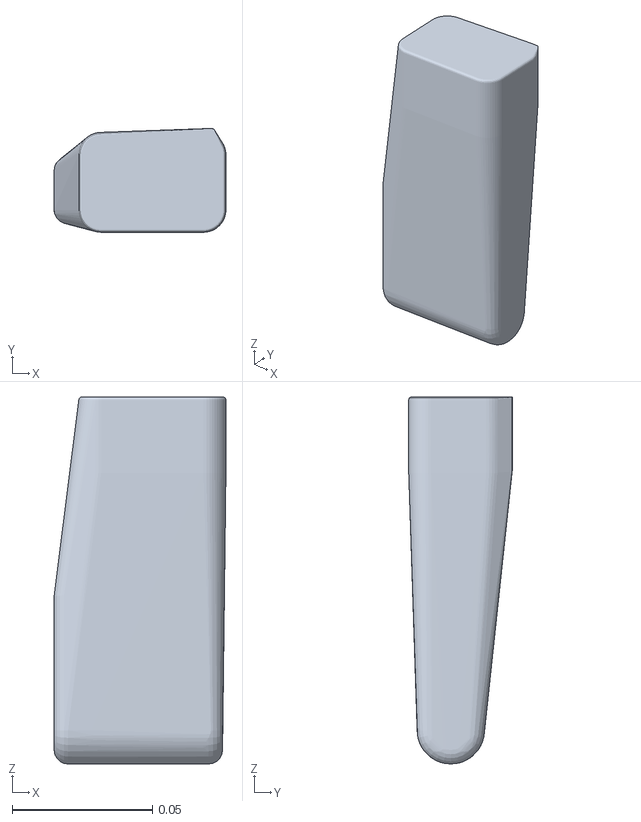
[picture p65: CAD file, 2026-03-09]
src/simulation/mani_skill/assets/robots/fetch_xlerobot/meshes/Lower_Arm.stl.convex.stl
0.0612 x 0.0369 x 0.131
