STHY0425/LeRobot-Anything-U-Arm-main/src/simulation/mani_skill/assets/robots/koch/meshes/link_6.stl

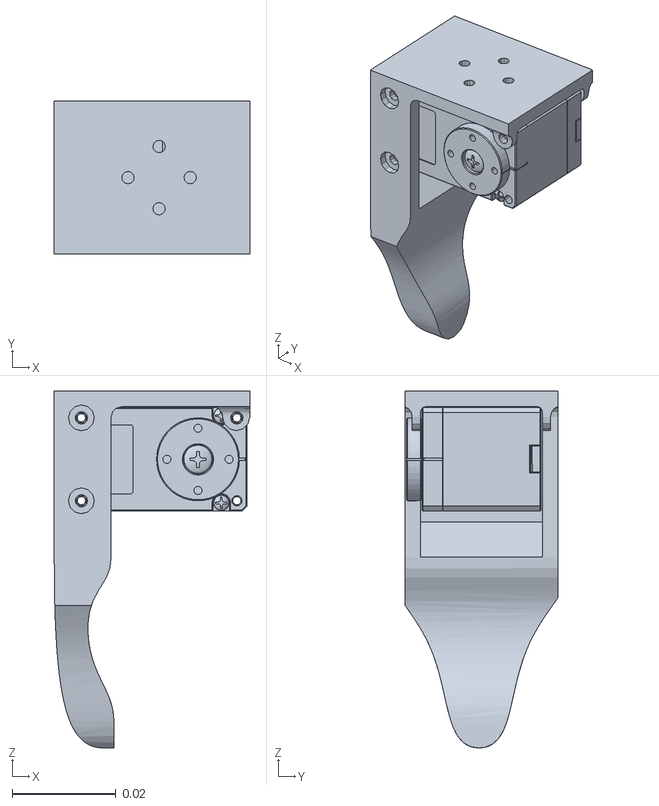
[picture p66: CAD file, 2026-03-09]
src/simulation/mani_skill/assets/robots/koch/meshes/link_6.stl
0.0378 x 0.0295 x 0.0689
