STHY0425/LeRobot-Anything-U-Arm-main/src/simulation/mani_skill/assets/robots/panda/franka_description/meshes/collision/link0.stl.convex.stl

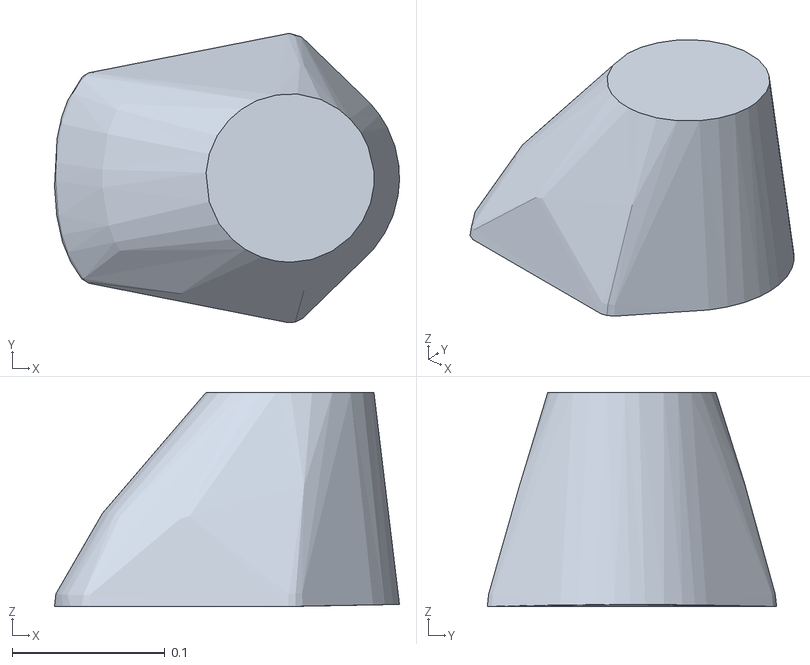
[picture p67: CAD file, 2026-03-09]
src/simulation/mani_skill/assets/robots/panda/franka_description/meshes/collision/link0.stl.convex.stl
0.226 x 0.189 x 0.14
