STHY0425/LeRobot-Anything-U-Arm-main/src/simulation/mani_skill/assets/robots/panda/realsense2_description/meshes/plug.stl

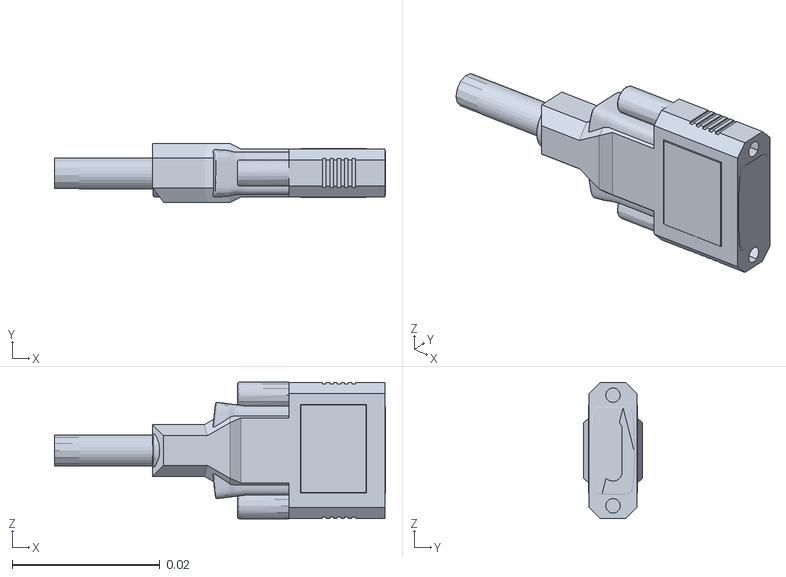
[picture p68: CAD file, 2026-03-09]
src/simulation/mani_skill/assets/robots/panda/realsense2_description/meshes/plug.stl
0.0448 x 0.008 x 0.0185
