STHY0425/LeRobot-Anything-U-Arm-main/src/simulation/mani_skill/assets/robots/panda/sciurus17_description/meshes/collision/Base.stl

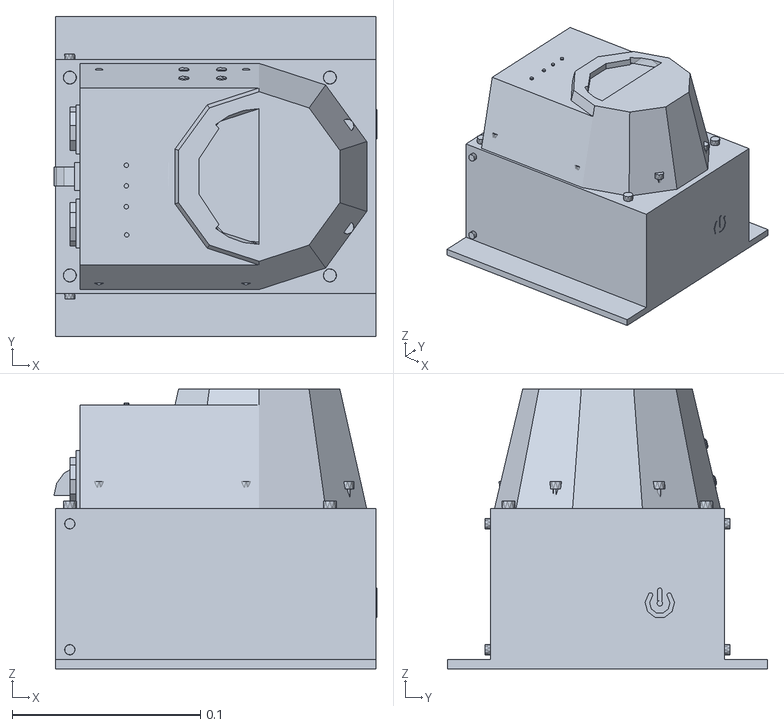
[picture p69: CAD file, 2026-03-09]
src/simulation/mani_skill/assets/robots/panda/sciurus17_description/meshes/collision/Base.stl
0.171 x 0.17 x 0.148
