STHY0425/LeRobot-Anything-U-Arm-main/src/simulation/mani_skill/assets/robots/piper/meshes/link6_1.STL

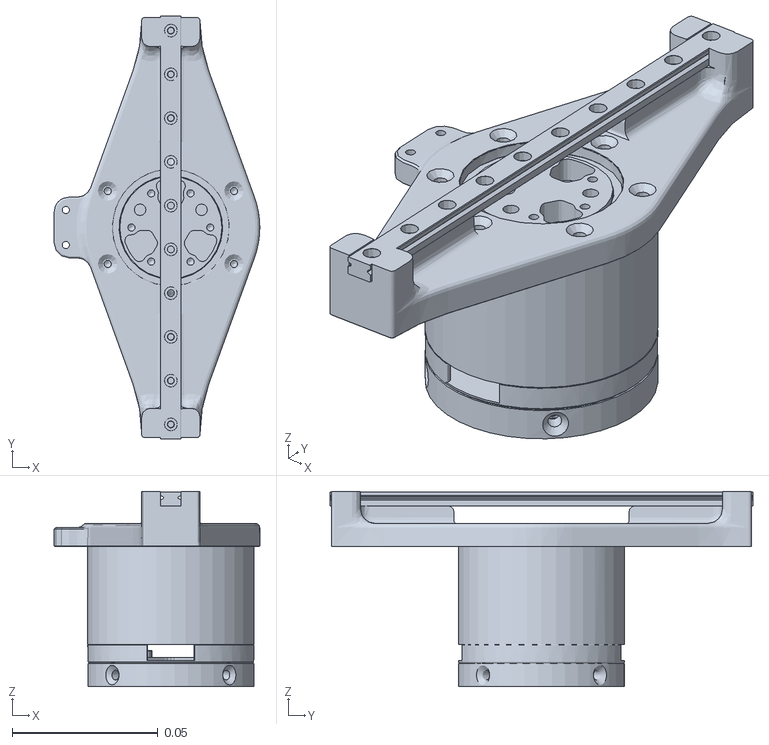
[picture p70: CAD file, 2026-03-09]
src/simulation/mani_skill/assets/robots/piper/meshes/link6_1.STL
0.0705 x 0.145 x 0.067
