STHY0425/LeRobot-Anything-U-Arm-main/src/simulation/mani_skill/assets/robots/rm65b/meshes/RM65/link4.STL

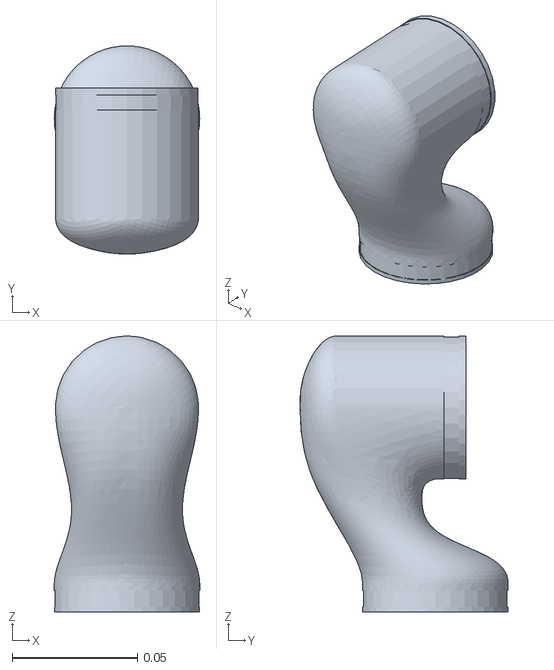
[picture p71: CAD file, 2026-03-09]
src/simulation/mani_skill/assets/robots/rm65b/meshes/RM65/link4.STL
0.058 x 0.083 x 0.11
