STHY0425/LeRobot-Anything-U-Arm-main/src/simulation/mani_skill/assets/robots/so100/meshes/Fixed_Jaw_Motor.stl

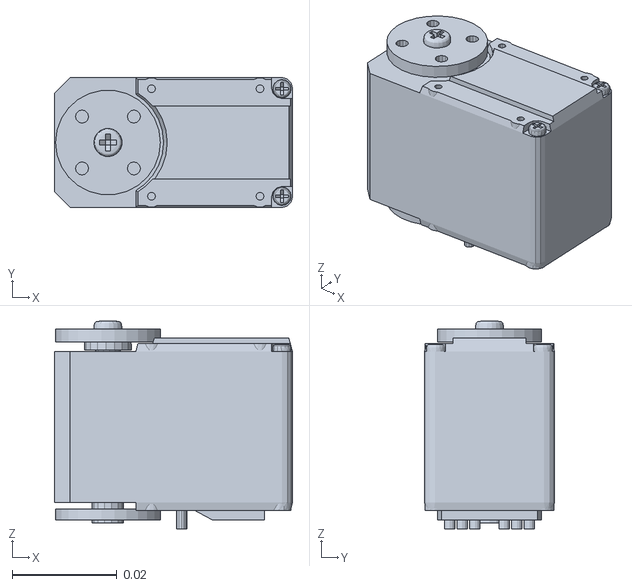
[picture p72: CAD file, 2026-03-09]
src/simulation/mani_skill/assets/robots/so100/meshes/Fixed_Jaw_Motor.stl
0.0454 x 0.0248 x 0.0396
