STHY0425/LeRobot-Anything-U-Arm-main/src/simulation/mani_skill/assets/robots/trifinger/objects/meshes/cube_multicolor.obj

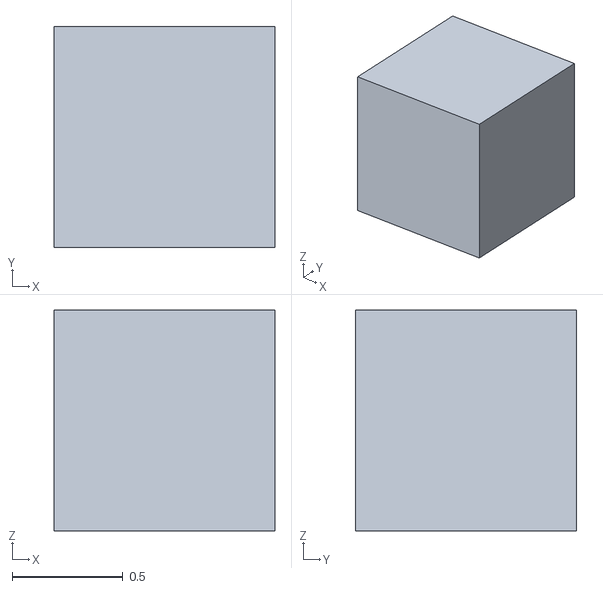
[picture p73: CAD file, 2026-03-09]
src/simulation/mani_skill/assets/robots/trifinger/objects/meshes/cube_multicolor.obj
1.00 x 1.00 x 1.00
