STHY0425/LeRobot-Anything-U-Arm-main/src/simulation/mani_skill/assets/robots/trifinger/robot_properties_fingers/meshes/pro/detailed/SIM__BL-Finger_Tip.stl

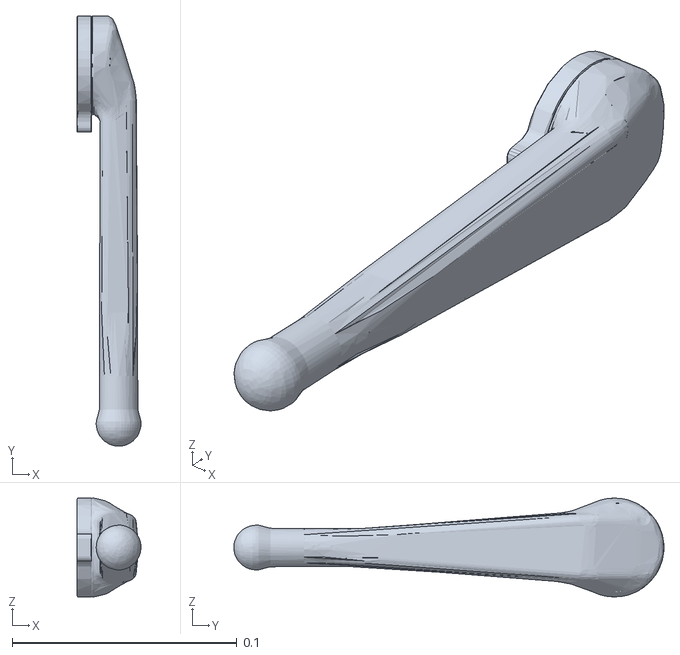
[picture p75: CAD file, 2026-03-09]
src/simulation/mani_skill/assets/robots/trifinger/robot_properties_fingers/meshes/pro/detailed/SIM__BL-Finger_Tip.stl
0.0284 x 0.191 x 0.044
