STHY0425/LeRobot-Anything-U-Arm-main/src/simulation/mani_skill/assets/robots/xarm7/meshes/collision/link7.obj

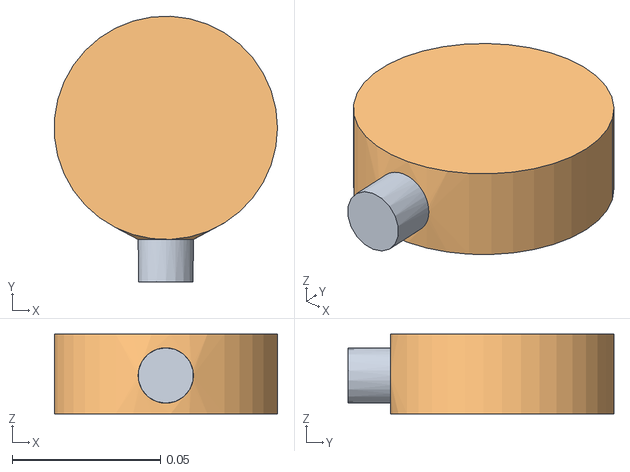
[picture p78: CAD file, 2026-03-09]
src/simulation/mani_skill/assets/robots/xarm7/meshes/collision/link7.obj
0.0753 x 0.0897 x 0.027
geometry_0
geometry_1
