STHY0425/LeRobot-Anything-U-Arm-main/src/simulation/mani_skill/envs/tasks/fmb/assets/green_bridge.ply

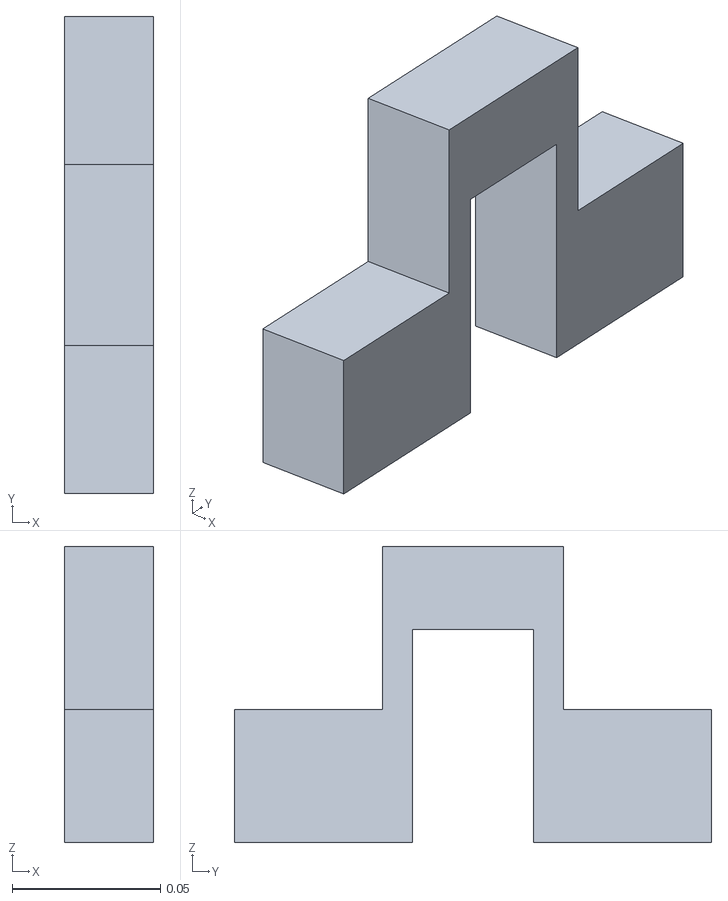
[picture p79: CAD file, 2026-03-09]
src/simulation/mani_skill/envs/tasks/fmb/assets/green_bridge.ply
0.03 x 0.161 x 0.1
