STHY0425/LeRobot-Anything-U-Arm-main/src/simulation/mani_skill/envs/tasks/humanoid/assets/frl_apartment_bowl_07.ply

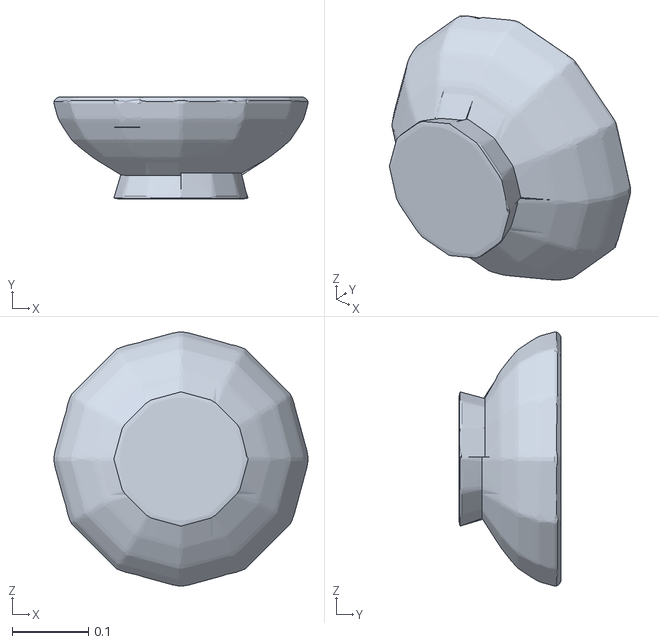
[picture p80: CAD file, 2026-03-09]
src/simulation/mani_skill/envs/tasks/humanoid/assets/frl_apartment_bowl_07.ply
0.332 x 0.134 x 0.332
