STHY0425/LeRobot-Anything-U-Arm-main/mechanical/Feetech_servo/Config1_STL/config1 - link6-1.STL

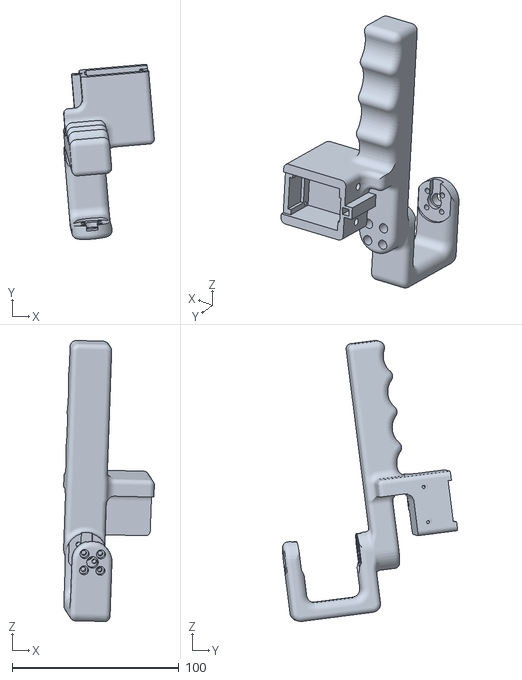
[picture p81: CAD file, 2026-03-09]
mechanical/Feetech_servo/Config1_STL/config1 - link6-1.STL
54.5 x 105.1 x 168.7
