STHY0425/LeRobot-Anything-U-Arm-main/mechanical/Feetech_servo/Config3_STL/config3 - link5-1.STL

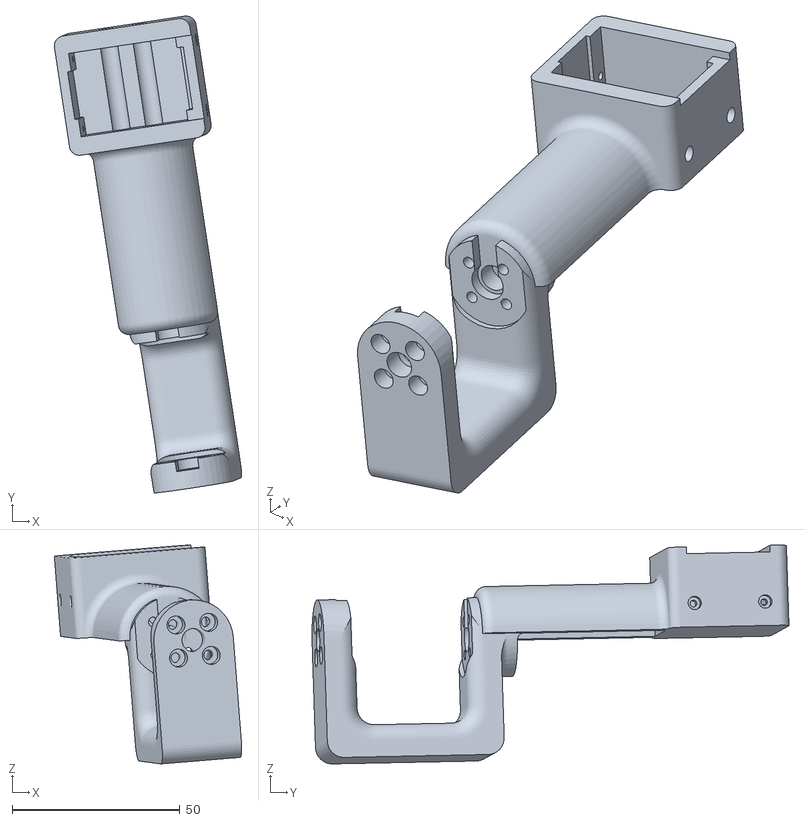
[picture p82: CAD file, 2026-03-09]
mechanical/Feetech_servo/Config3_STL/config3 - link5-1.STL
55.9 x 142.4 x 65.3
