STHY0425/LeRobot-Anything-U-Arm-main/mechanical/Zhonglin_servo/Config1_STL/Config1 - Joint5-1.STL

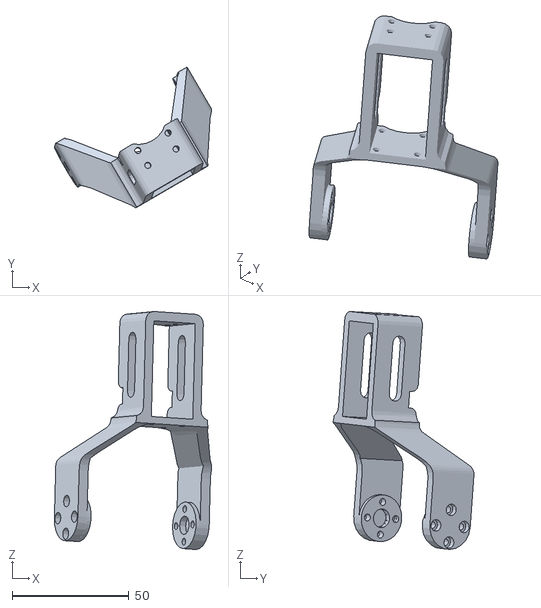
[picture p83: CAD file, 2026-03-09]
mechanical/Zhonglin_servo/Config1_STL/Config1 - Joint5-1.STL
67.2 x 60.3 x 101.7
