STHY0425/LeRobot-Anything-U-Arm-main/mechanical/Zhonglin_servo/Config2_STL/Config2 - Link3_part1-1.STL

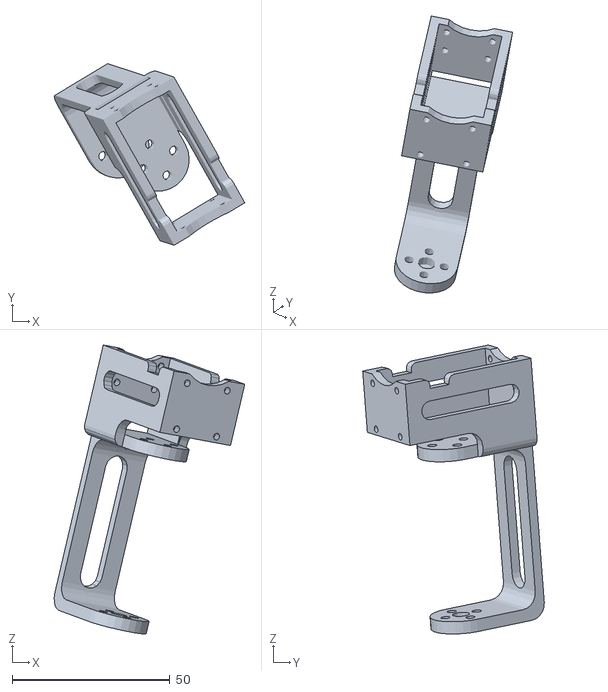
[picture p84: CAD file, 2026-03-09]
mechanical/Zhonglin_servo/Config2_STL/Config2 - Link3_part1-1.STL
60.4 x 57.6 x 91.6
