STHY0425/LeRobot-Anything-U-Arm-main/mechanical/Zhonglin_servo/Config3_STL/Config3 - Arm3-2.STL

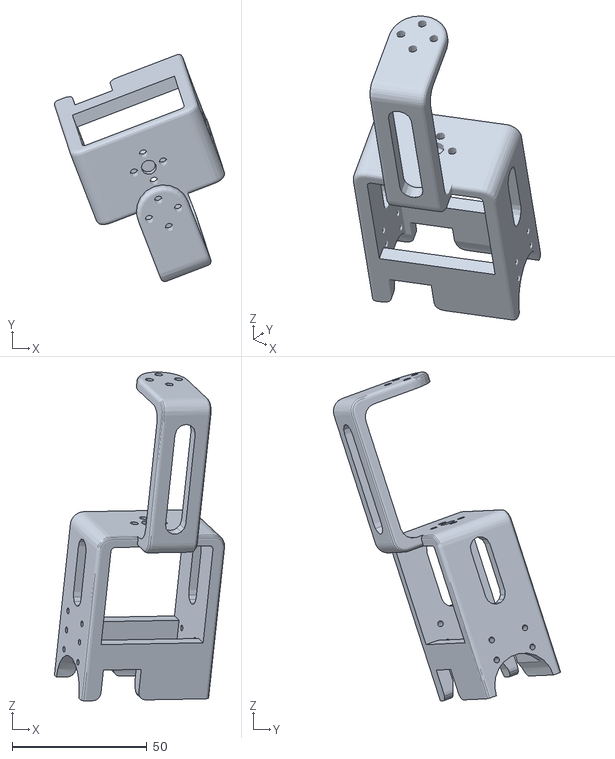
[picture p85: CAD file, 2026-03-09]
mechanical/Zhonglin_servo/Config3_STL/Config3 - Arm3-2.STL
63.1 x 84.3 x 122.0
