STHY0425/LeRobot-Anything-U-Arm-main/src/simulation/mani_skill/assets/robots/ability_hand/meshes/collision/idx-F2_C.obj

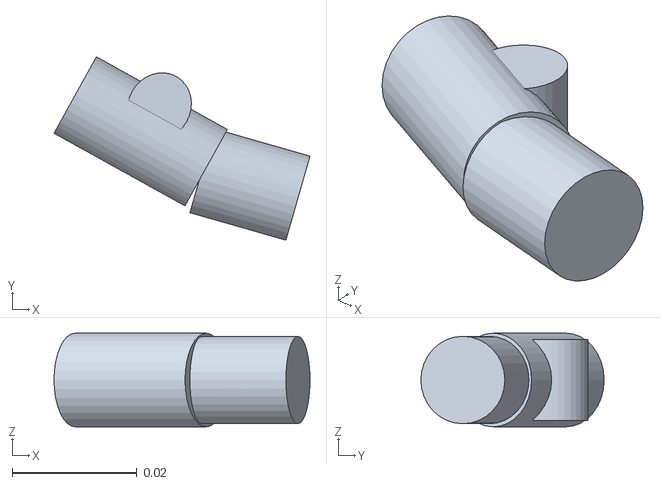
[picture p86: CAD file, 2026-03-09]
src/simulation/mani_skill/assets/robots/ability_hand/meshes/collision/idx-F2_C.obj
0.041 x 0.0294 x 0.015
