STHY0425/LeRobot-Anything-U-Arm-main/src/simulation/mani_skill/assets/robots/allegro/meshes/visual/link_15.0.obj

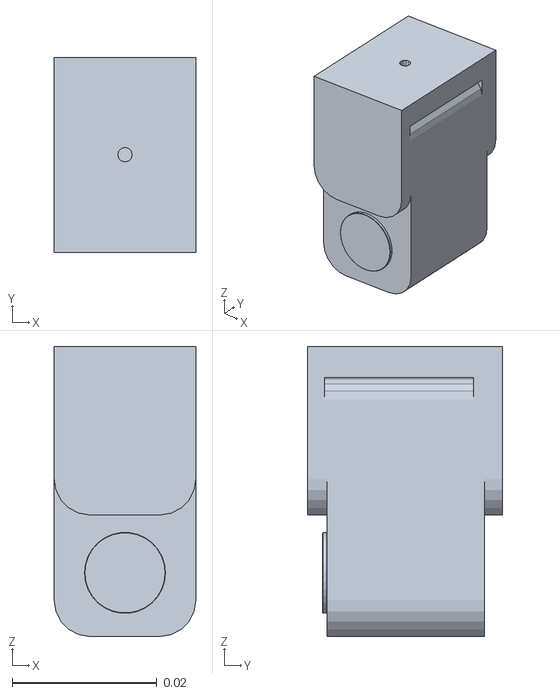
[picture p87: CAD file, 2026-03-09]
src/simulation/mani_skill/assets/robots/allegro/meshes/visual/link_15.0.obj
0.0196 x 0.027 x 0.0401
