STHY0425/LeRobot-Anything-U-Arm-main/src/simulation/mani_skill/assets/robots/ARX-X5/meshes/base_link.STL

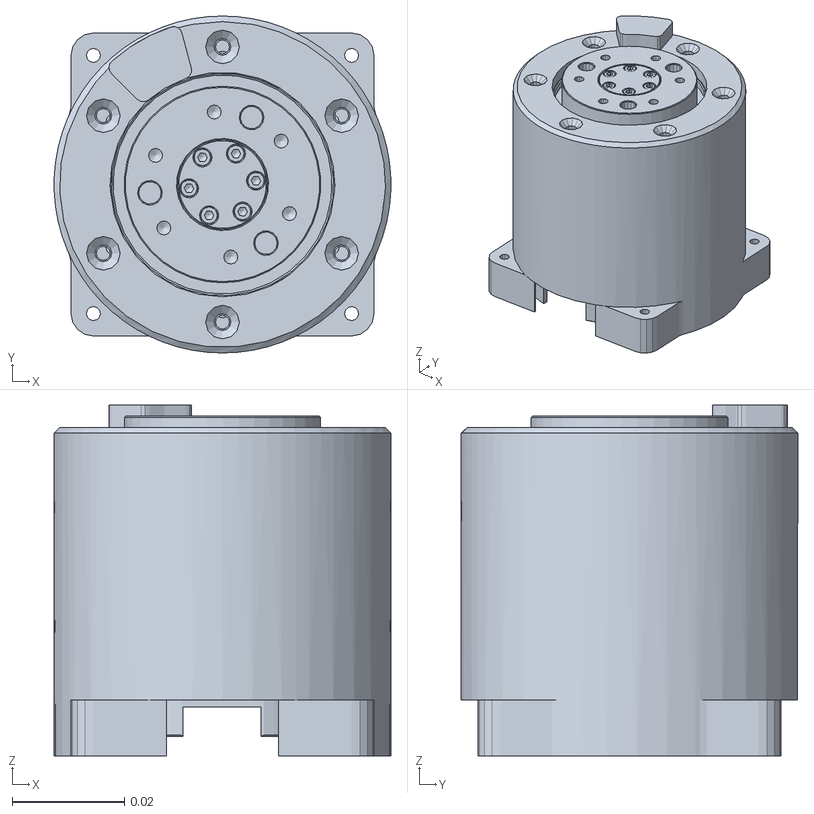
[picture p88: CAD file, 2026-03-09]
src/simulation/mani_skill/assets/robots/ARX-X5/meshes/base_link.STL
0.0599 x 0.06 x 0.0625
