STHY0425/LeRobot-Anything-U-Arm-main/src/simulation/mani_skill/assets/robots/dclaw/meshes/visual/link_2.obj

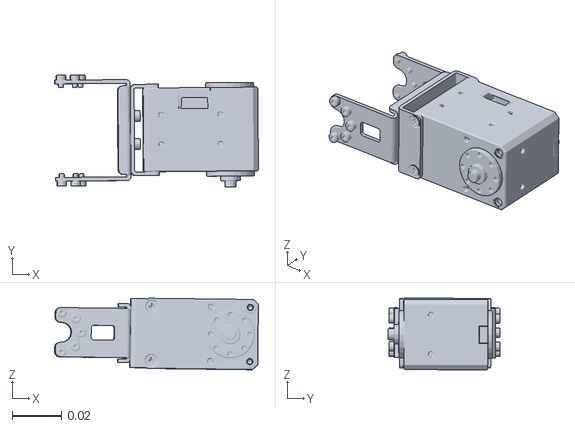
[picture p89: CAD file, 2026-03-09]
src/simulation/mani_skill/assets/robots/dclaw/meshes/visual/link_2.obj
0.0828 x 0.0454 x 0.0291
