STHY0425/LeRobot-Anything-U-Arm-main/src/simulation/mani_skill/assets/robots/fetch/fetch_description/meshes/wrist_flex_link_collision.STL

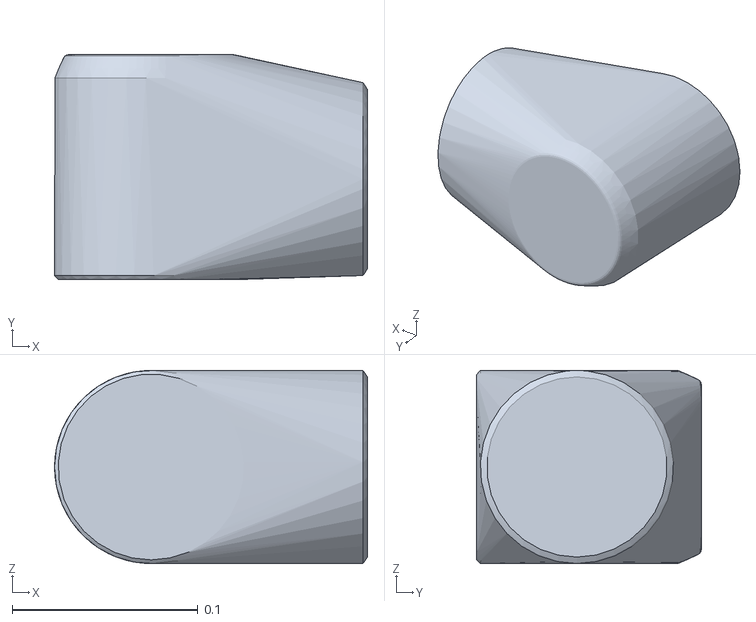
[picture p90: CAD file, 2026-03-09]
src/simulation/mani_skill/assets/robots/fetch/fetch_description/meshes/wrist_flex_link_collision.STL
0.168 x 0.121 x 0.104
