STHY0425/LeRobot-Anything-U-Arm-main/src/simulation/mani_skill/assets/robots/fetch_xlerobot/meshes/Wrist_Pitch_Roll_Motor.stl

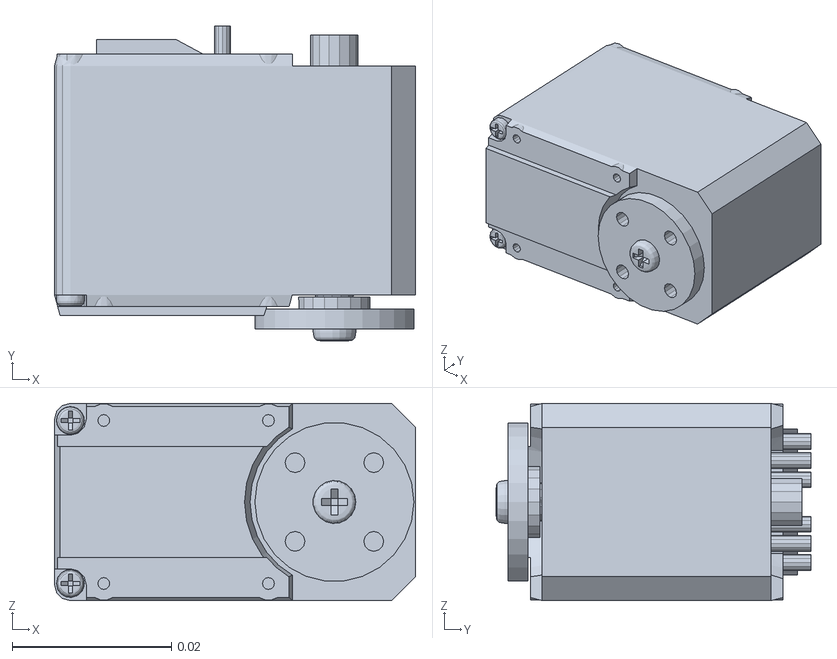
[picture p91: CAD file, 2026-03-09]
src/simulation/mani_skill/assets/robots/fetch_xlerobot/meshes/Wrist_Pitch_Roll_Motor.stl
0.0454 x 0.0396 x 0.0248
