STHY0425/LeRobot-Anything-U-Arm-main/src/simulation/mani_skill/assets/robots/g1_humanoid/meshes/right_ankle_roll_link.STL

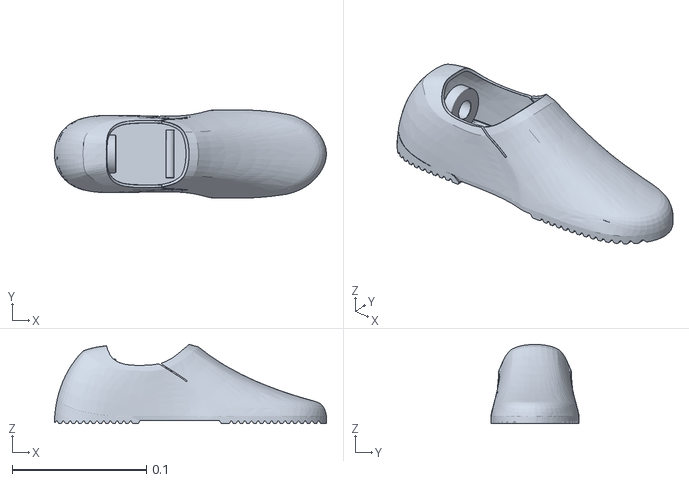
[picture p92: CAD file, 2026-03-09]
src/simulation/mani_skill/assets/robots/g1_humanoid/meshes/right_ankle_roll_link.STL
0.202 x 0.0659 x 0.0589
