STHY0425/LeRobot-Anything-U-Arm-main/src/simulation/mani_skill/assets/robots/koch/meshes/link_1.stl

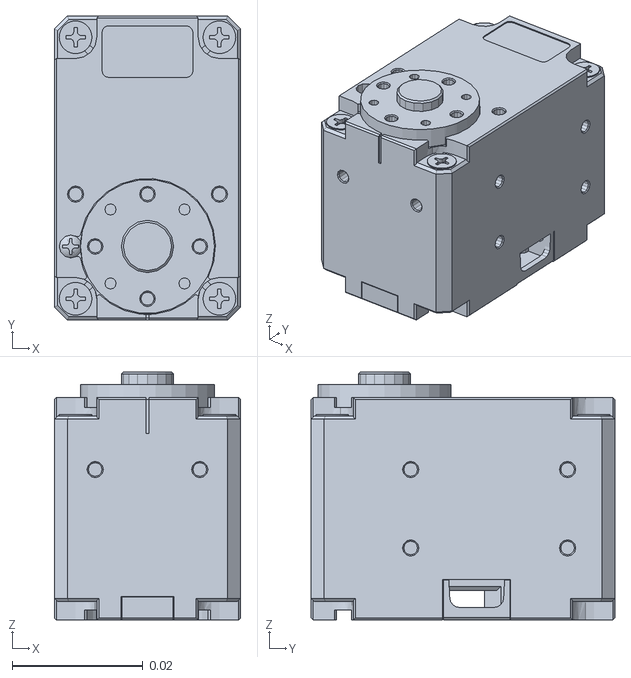
[picture p93: CAD file, 2026-03-09]
src/simulation/mani_skill/assets/robots/koch/meshes/link_1.stl
0.0285 x 0.0465 x 0.0379
