STHY0425/LeRobot-Anything-U-Arm-main/src/simulation/mani_skill/assets/robots/panda/franka_description/meshes/collision/link4.stl

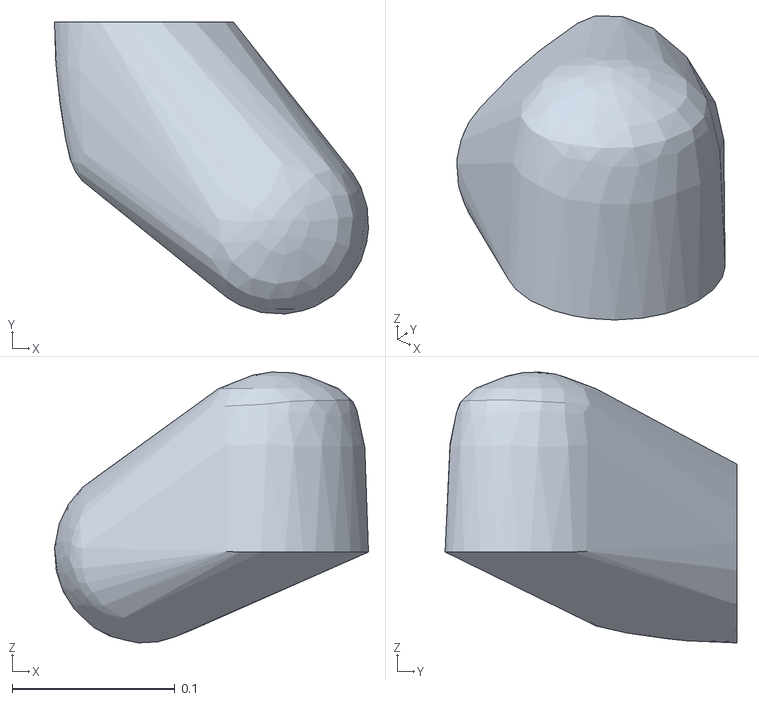
[picture p94: CAD file, 2026-03-09]
src/simulation/mani_skill/assets/robots/panda/franka_description/meshes/collision/link4.stl
0.193 x 0.179 x 0.166
