STHY0425/LeRobot-Anything-U-Arm-main/src/simulation/mani_skill/assets/robots/piper/meshes/link7.STL

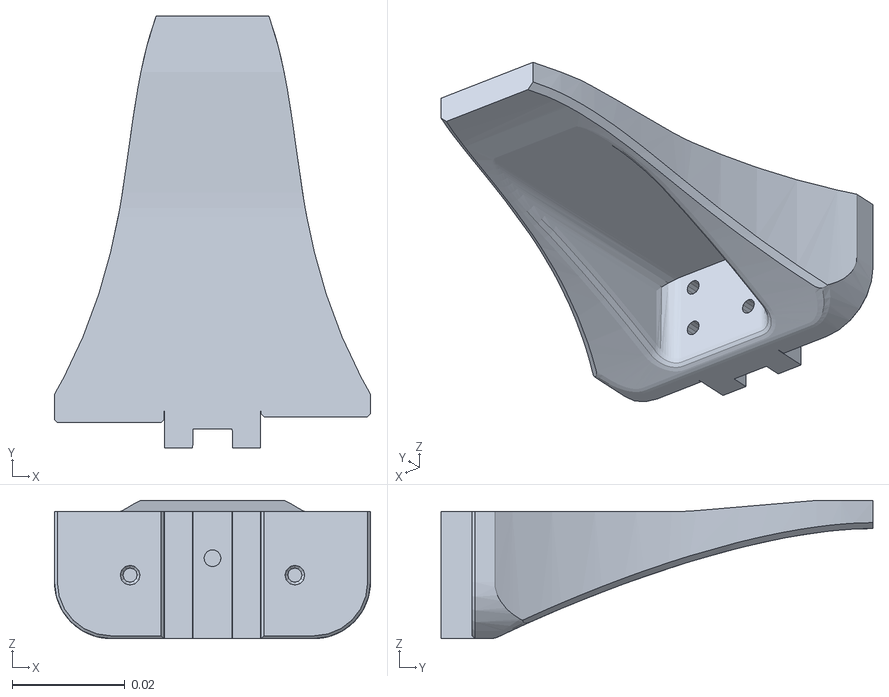
[picture p95: CAD file, 2026-03-09]
src/simulation/mani_skill/assets/robots/piper/meshes/link7.STL
0.056 x 0.0765 x 0.0245
