STHY0425/LeRobot-Anything-U-Arm-main/src/simulation/mani_skill/assets/robots/rm65b/meshes/RM65/link1.STL

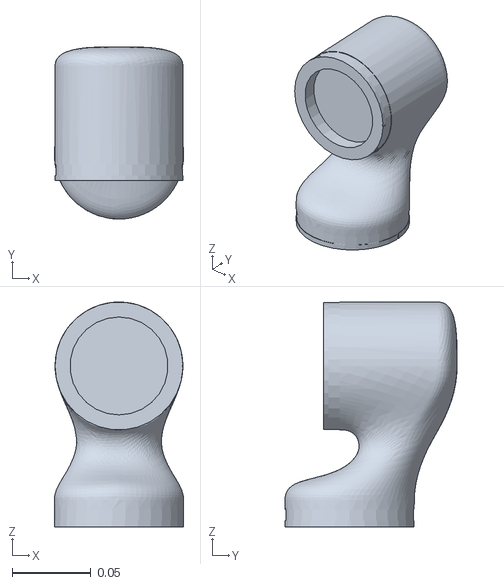
[picture p96: CAD file, 2026-03-09]
src/simulation/mani_skill/assets/robots/rm65b/meshes/RM65/link1.STL
0.082 x 0.109 x 0.143
