STHY0425/LeRobot-Anything-U-Arm-main/src/simulation/mani_skill/assets/robots/so100/meshes/Moving_Jaw.stl.convex.stl

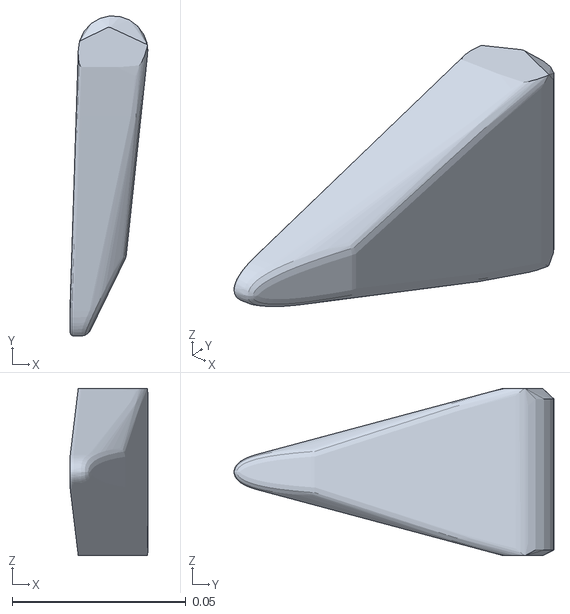
[picture p97: CAD file, 2026-03-09]
src/simulation/mani_skill/assets/robots/so100/meshes/Moving_Jaw.stl.convex.stl
0.0223 x 0.092 x 0.048
