STHY0425/LeRobot-Anything-U-Arm-main/src/simulation/mani_skill/assets/robots/trifinger/robot_properties_fingers/meshes/pro/detailed/SIM__BL-Finger_Motor.stl

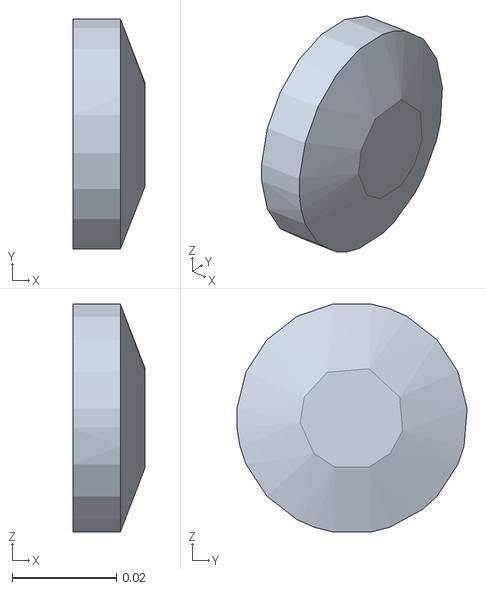
[picture p99: CAD file, 2026-03-09]
src/simulation/mani_skill/assets/robots/trifinger/robot_properties_fingers/meshes/pro/detailed/SIM__BL-Finger_Motor.stl
0.0139 x 0.0442 x 0.0438
