STHY0425/LeRobot-Anything-U-Arm-main/src/simulation/mani_skill/assets/robots/xarm7/meshes/collision/link3.obj

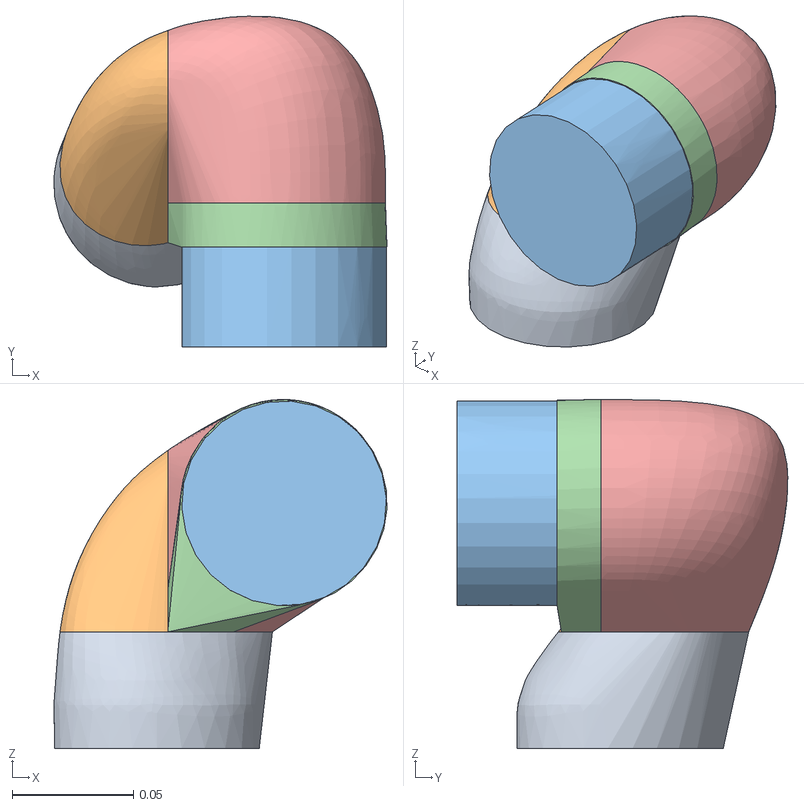
[picture p101: CAD file, 2026-03-09]
src/simulation/mani_skill/assets/robots/xarm7/meshes/collision/link3.obj
0.137 x 0.136 x 0.144
geometry_0
geometry_1
geometry_2
geometry_3
geometry_4
