STHY0425/LeRobot-Anything-U-Arm-main/mechanical/Feetech_servo/Config1_STL/config1 - trigger_short-1.STL

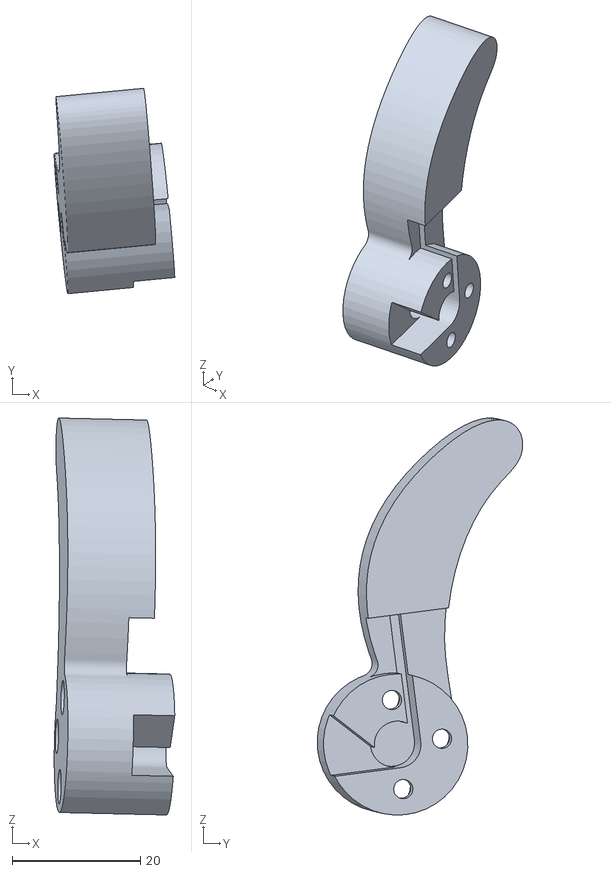
[picture p102: CAD file, 2026-03-09]
mechanical/Feetech_servo/Config1_STL/config1 - trigger_short-1.STL
18.8 x 32.0 x 61.9
