STHY0425/LeRobot-Anything-U-Arm-main/mechanical/Feetech_servo/Config2_STL/config2 - link3-1.STL

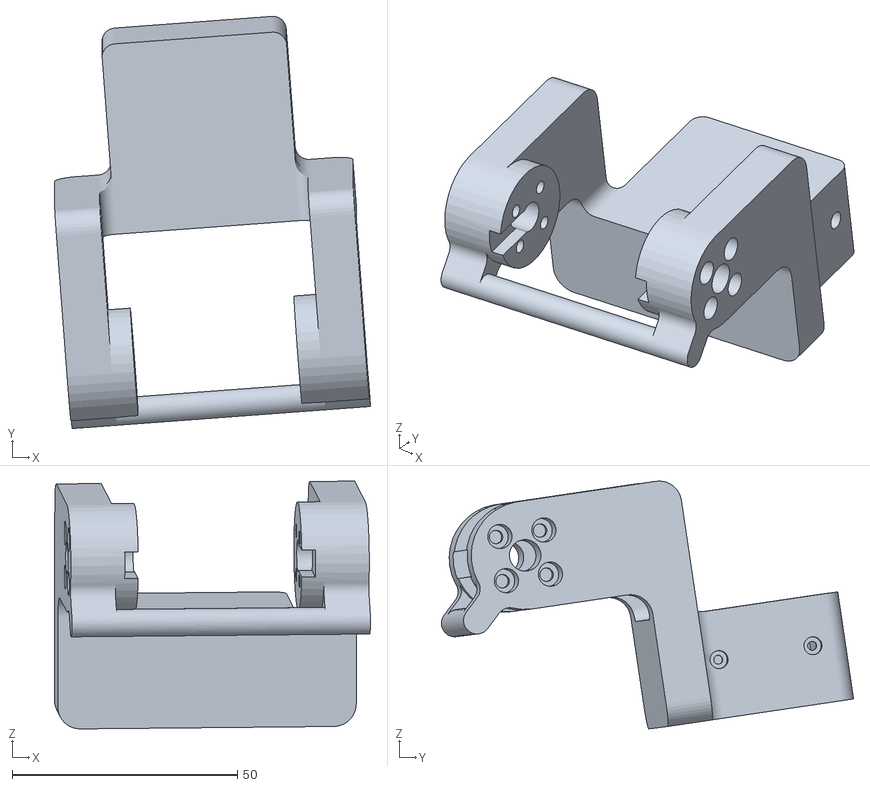
[picture p103: CAD file, 2026-03-09]
mechanical/Feetech_servo/Config2_STL/config2 - link3-1.STL
70.1 x 91.5 x 55.0
