STHY0425/LeRobot-Anything-U-Arm-main/mechanical/Zhonglin_servo/Config1_STL/Config1 - Link3-1.STL

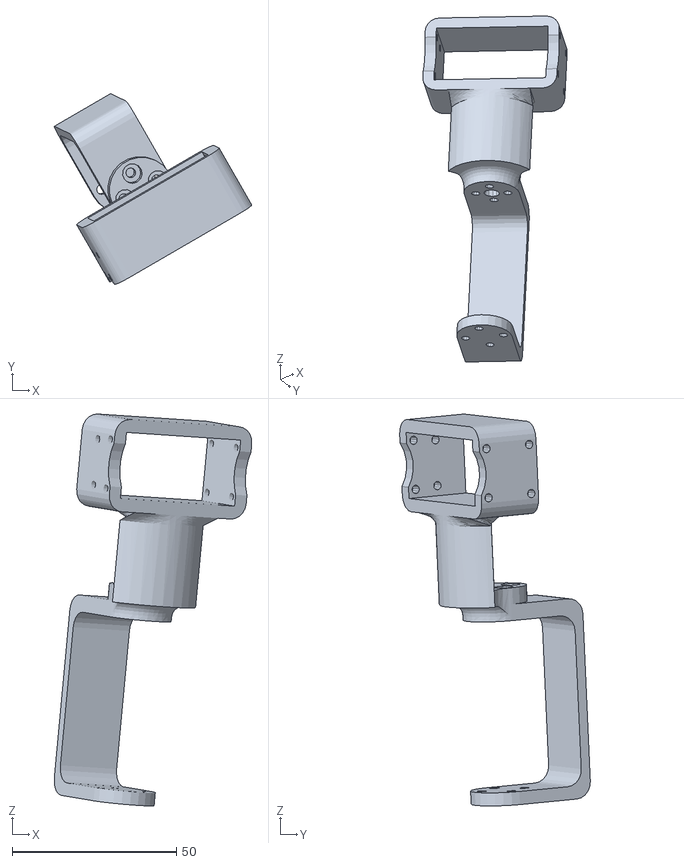
[picture p104: CAD file, 2026-03-09]
mechanical/Zhonglin_servo/Config1_STL/Config1 - Link3-1.STL
60.0 x 58.0 x 119.2
