STHY0425/LeRobot-Anything-U-Arm-main/mechanical/Zhonglin_servo/Config2_STL/Config2 - sitter-2.STL

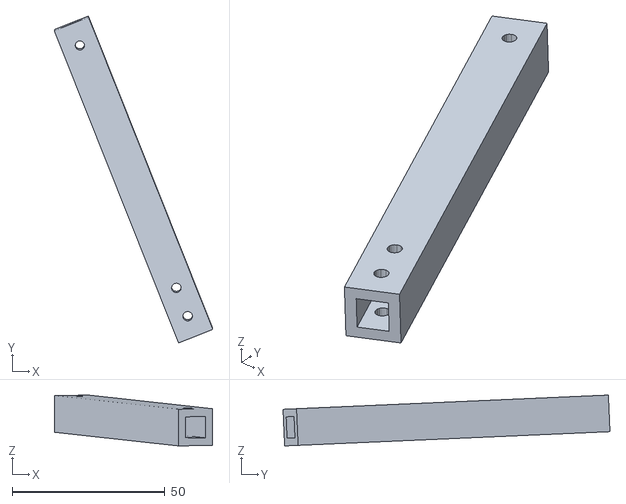
[picture p105: CAD file, 2026-03-09]
mechanical/Zhonglin_servo/Config2_STL/Config2 - sitter-2.STL
51.8 x 107.1 x 16.7
