STHY0425/LeRobot-Anything-U-Arm-main/mechanical/Zhonglin_servo/Config3_STL/Config3 - Joint3_fanuc-1.STL

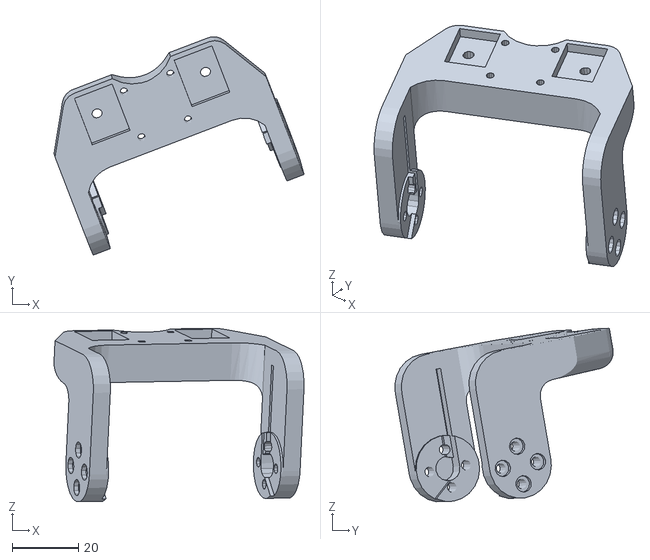
[picture p106: CAD file, 2026-03-09]
mechanical/Zhonglin_servo/Config3_STL/Config3 - Joint3_fanuc-1.STL
75.3 x 65.8 x 52.3
