STHY0425/LeRobot-Anything-U-Arm-main/src/simulation/mani_skill/assets/robots/ARX-X5/meshes/link8.STL

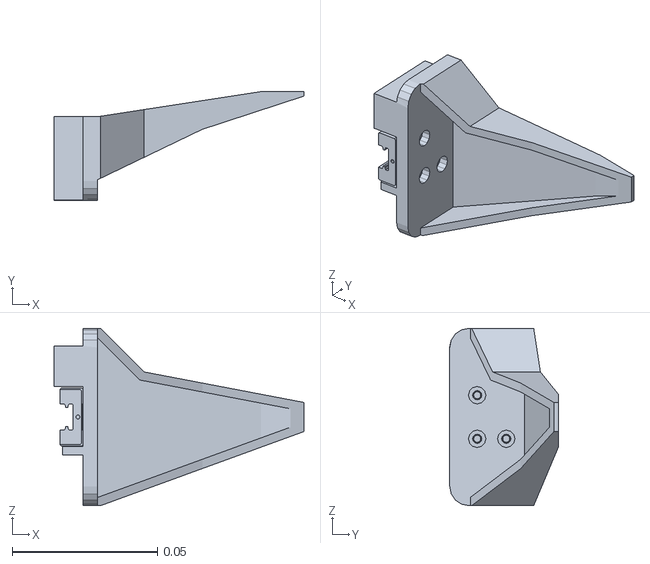
[picture p107: CAD file, 2026-03-09]
src/simulation/mani_skill/assets/robots/ARX-X5/meshes/link8.STL
0.086 x 0.0373 x 0.061
