STHY0425/LeRobot-Anything-U-Arm-main/src/simulation/mani_skill/assets/robots/dclaw/meshes/visual/base_link.obj

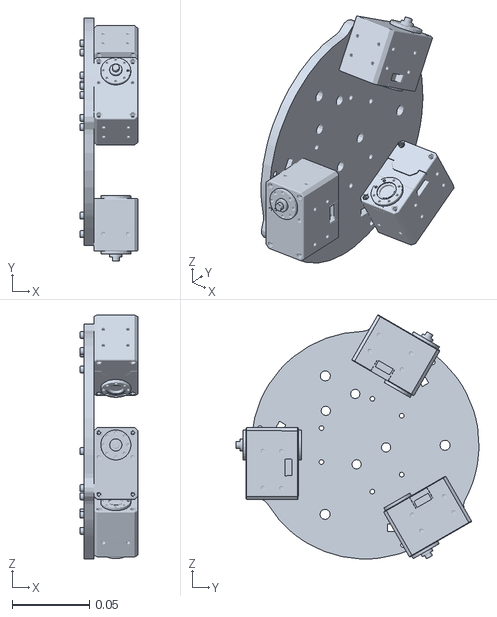
[picture p108: CAD file, 2026-03-09]
src/simulation/mani_skill/assets/robots/dclaw/meshes/visual/base_link.obj
0.0374 x 0.158 x 0.158
