STHY0425/LeRobot-Anything-U-Arm-main/src/simulation/mani_skill/assets/robots/fetch/fetch_description/meshes/forearm_roll_link_collision.STL

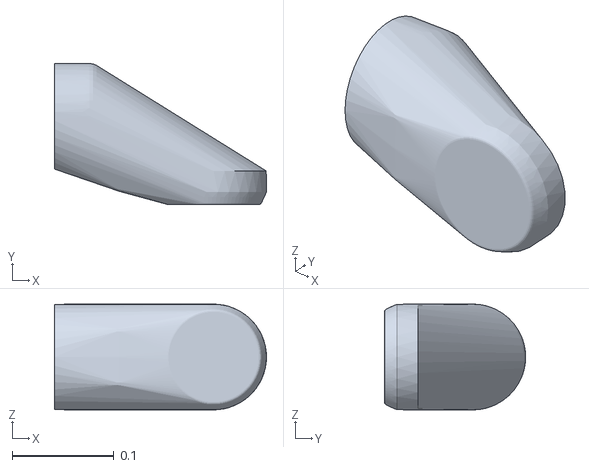
[picture p109: CAD file, 2026-03-09]
src/simulation/mani_skill/assets/robots/fetch/fetch_description/meshes/forearm_roll_link_collision.STL
0.208 x 0.139 x 0.104
