STHY0425/LeRobot-Anything-U-Arm-main/src/simulation/mani_skill/assets/robots/fetch_xlerobot/meshes/Upper_Arm.stl

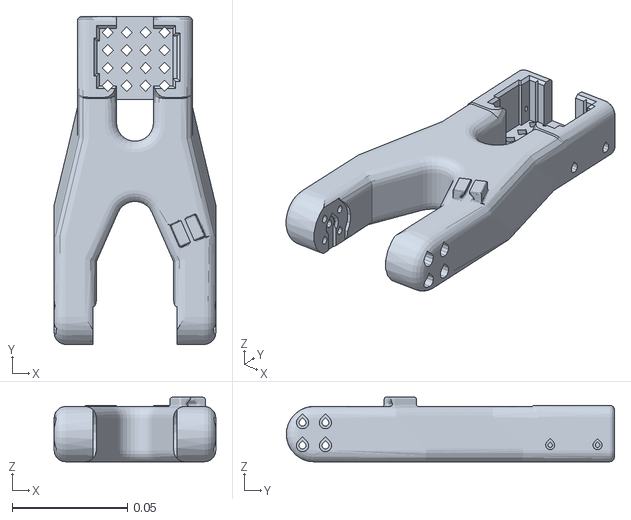
[picture p110: CAD file, 2026-03-09]
src/simulation/mani_skill/assets/robots/fetch_xlerobot/meshes/Upper_Arm.stl
0.07 x 0.142 x 0.028
