STHY0425/LeRobot-Anything-U-Arm-main/src/simulation/mani_skill/assets/robots/g1_humanoid/meshes/left_shoulder_roll_link.STL

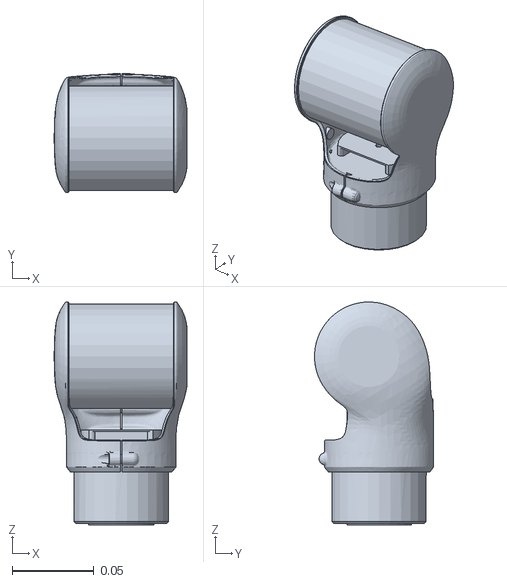
[picture p111: CAD file, 2026-03-09]
src/simulation/mani_skill/assets/robots/g1_humanoid/meshes/left_shoulder_roll_link.STL
0.0812 x 0.0729 x 0.137
