STHY0425/LeRobot-Anything-U-Arm-main/src/simulation/mani_skill/assets/robots/koch/meshes/base_link.stl

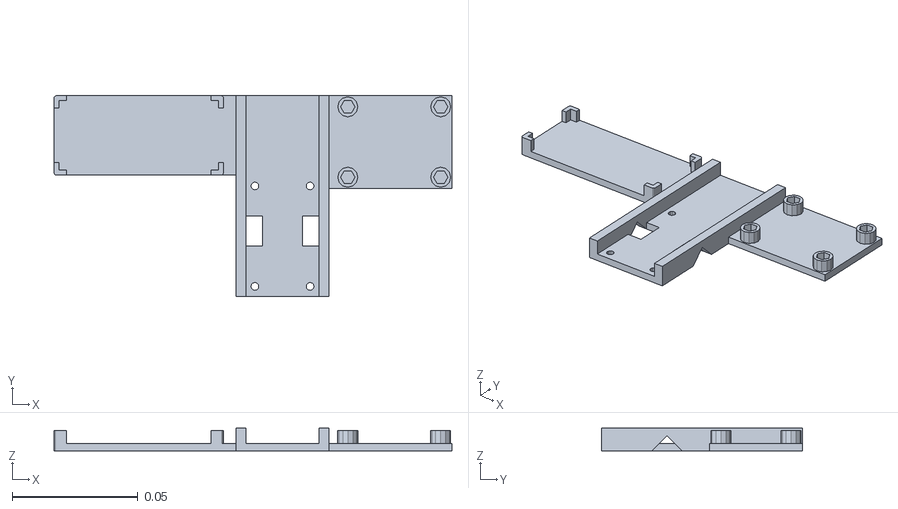
[picture p112: CAD file, 2026-03-09]
src/simulation/mani_skill/assets/robots/koch/meshes/base_link.stl
0.159 x 0.08 x 0.009
