STHY0425/LeRobot-Anything-U-Arm-main/src/simulation/mani_skill/assets/robots/panda/franka_description/meshes/collision/link3.stl

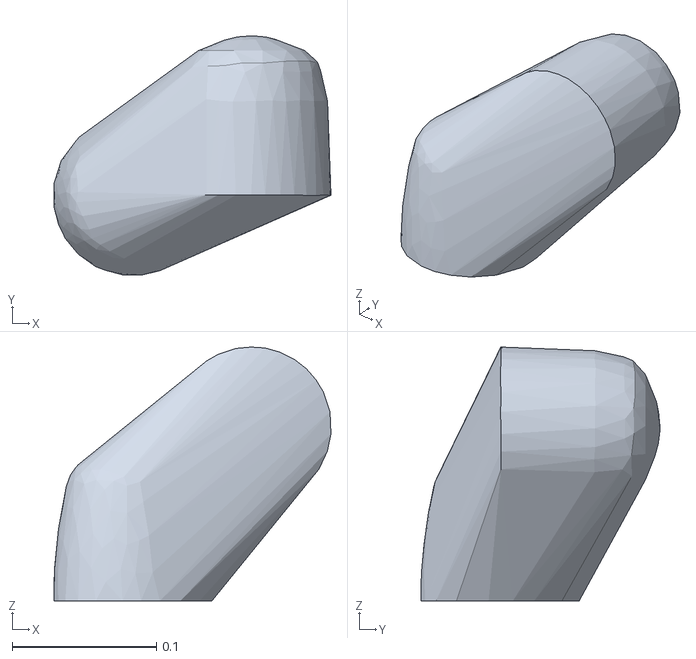
[picture p113: CAD file, 2026-03-09]
src/simulation/mani_skill/assets/robots/panda/franka_description/meshes/collision/link3.stl
0.192 x 0.166 x 0.176
