STHY0425/LeRobot-Anything-U-Arm-main/src/simulation/mani_skill/assets/robots/piper/meshes/link3.STL

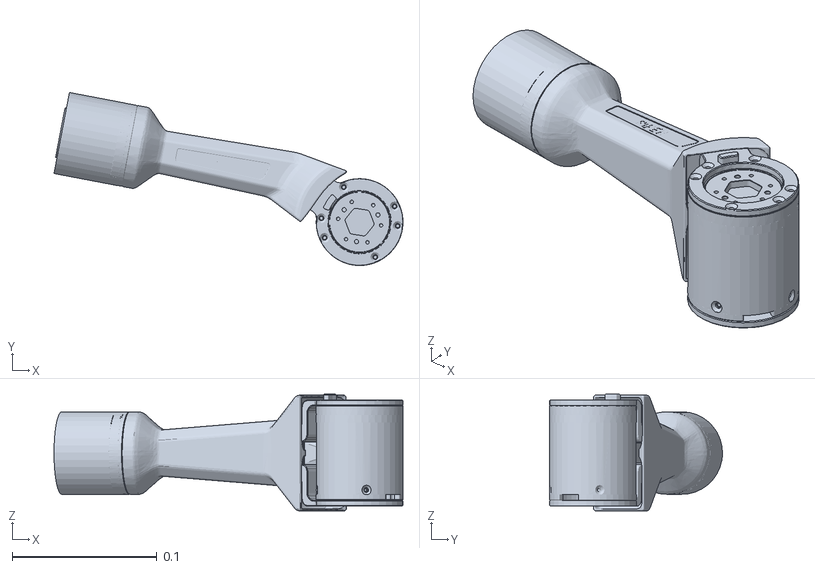
[picture p114: CAD file, 2026-03-09]
src/simulation/mani_skill/assets/robots/piper/meshes/link3.STL
0.241 x 0.12 x 0.0807
