STHY0425/LeRobot-Anything-U-Arm-main/src/simulation/mani_skill/assets/robots/rm65b/meshes/RM65/link5.STL

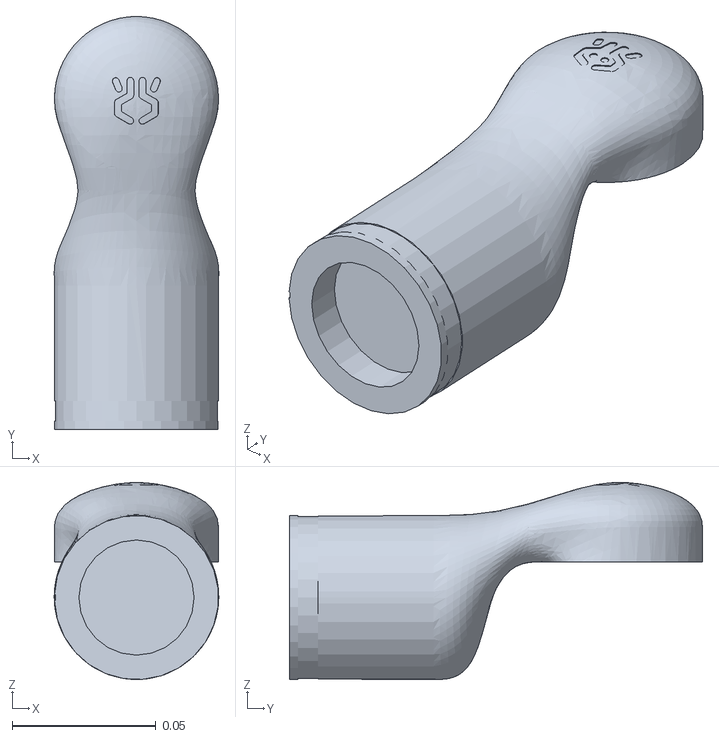
[picture p115: CAD file, 2026-03-09]
src/simulation/mani_skill/assets/robots/rm65b/meshes/RM65/link5.STL
0.0572 x 0.143 x 0.0685
