STHY0425/LeRobot-Anything-U-Arm-main/src/simulation/mani_skill/assets/robots/trifinger/robot_properties_fingers/meshes/pro/detailed/SIM__BL-Finger_Proximal.stl

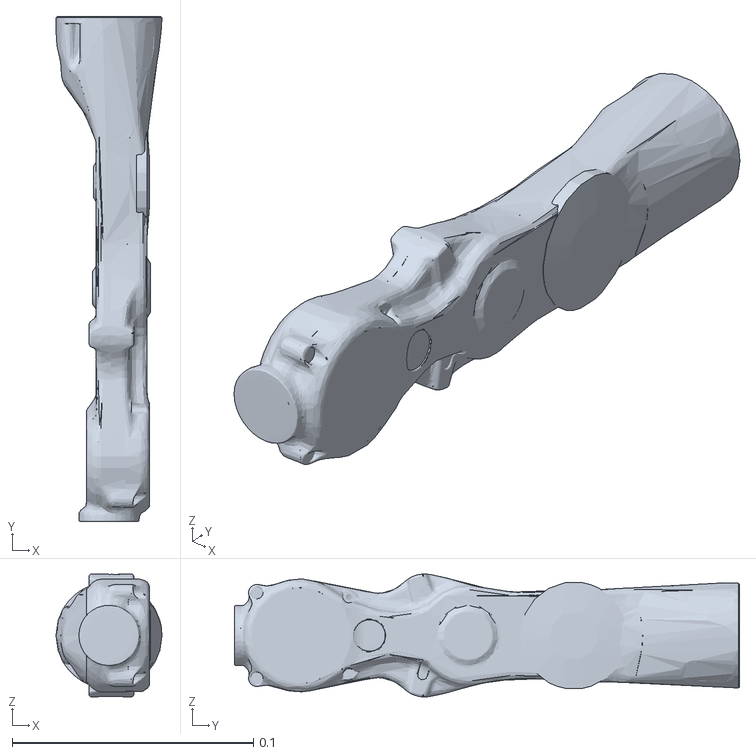
[picture p118: CAD file, 2026-03-09]
src/simulation/mani_skill/assets/robots/trifinger/robot_properties_fingers/meshes/pro/detailed/SIM__BL-Finger_Proximal.stl
0.044 x 0.209 x 0.051
