STHY0425/LeRobot-Anything-U-Arm-main/src/simulation/mani_skill/assets/robots/trifinger/robot_properties_fingers/meshes/SIM__BL-Finger_Base.stl

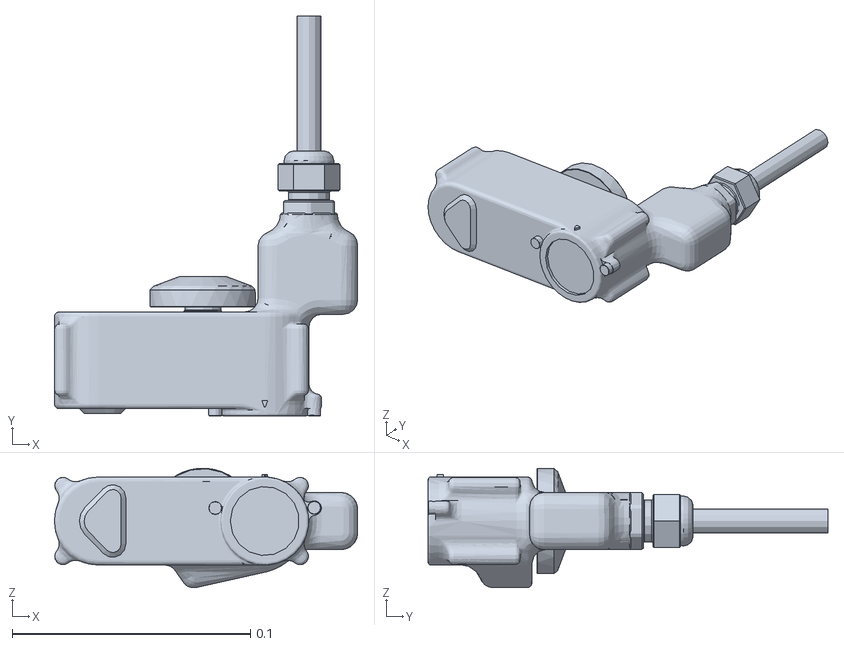
[picture p119: CAD file, 2026-03-09]
src/simulation/mani_skill/assets/robots/trifinger/robot_properties_fingers/meshes/SIM__BL-Finger_Base.stl
0.127 x 0.168 x 0.0501
