STHY0425/LeRobot-Anything-U-Arm-main/src/simulation/mani_skill/assets/robots/xarm7/meshes/collision/link1.obj

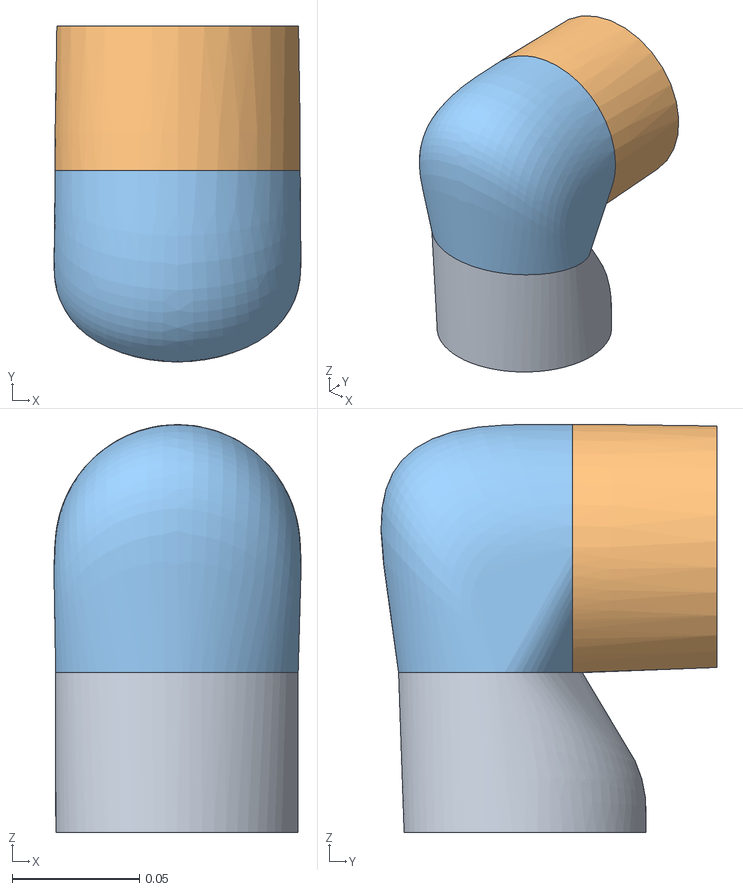
[picture p120: CAD file, 2026-03-09]
src/simulation/mani_skill/assets/robots/xarm7/meshes/collision/link1.obj
0.0968 x 0.132 x 0.16
geometry_0
geometry_1
geometry_2
