STHY0425/LeRobot-Anything-U-Arm-main/mechanical/Feetech_servo/Config3_STL/config3 - link2-1.STL

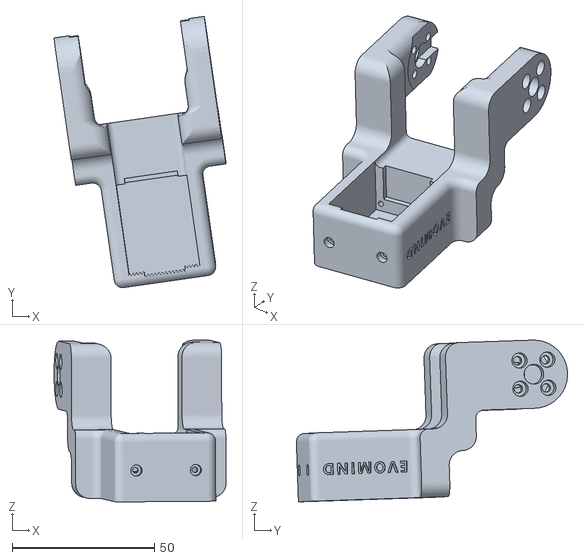
[picture p121: CAD file, 2026-03-09]
mechanical/Feetech_servo/Config3_STL/config3 - link2-1.STL
60.5 x 95.4 x 56.9
