STHY0425/LeRobot-Anything-U-Arm-main/mechanical/Zhonglin_servo/Config1_STL/Config1 - L2J2-1.STL

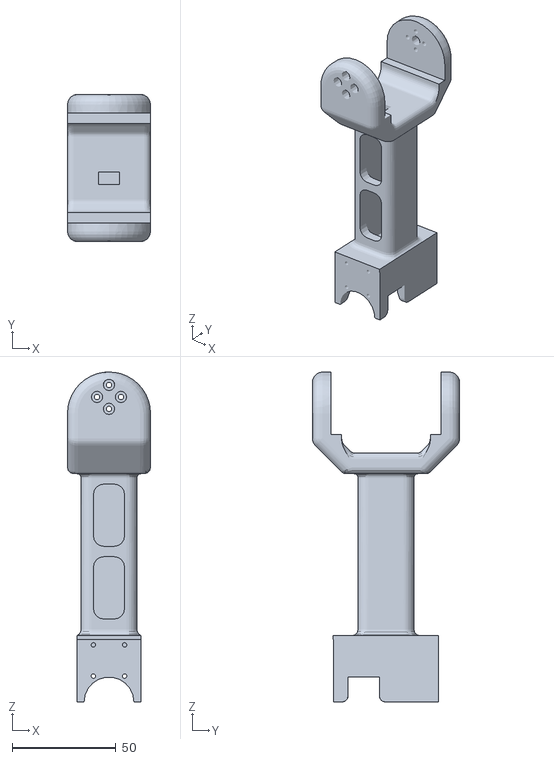
[picture p122: CAD file, 2026-03-09]
mechanical/Zhonglin_servo/Config1_STL/Config1 - L2J2-1.STL
40.0 x 71.0 x 159.0
