STHY0425/LeRobot-Anything-U-Arm-main/mechanical/Zhonglin_servo/Config2_STL/Config2 - sitter_mid-1.STL

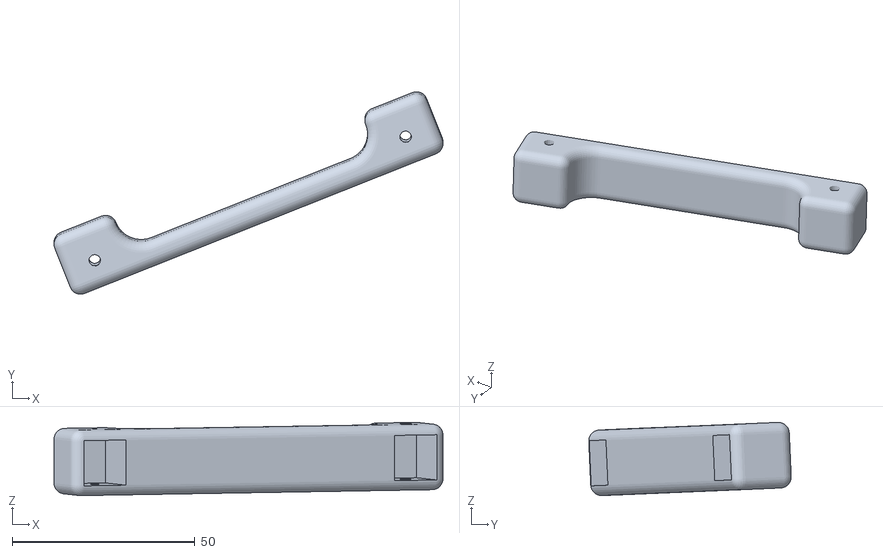
[picture p123: CAD file, 2026-03-09]
mechanical/Zhonglin_servo/Config2_STL/Config2 - sitter_mid-1.STL
106.6 x 55.5 x 20.1
