STHY0425/LeRobot-Anything-U-Arm-main/src/simulation/mani_skill/assets/robots/ability_hand/meshes/visual/idx-F2.obj

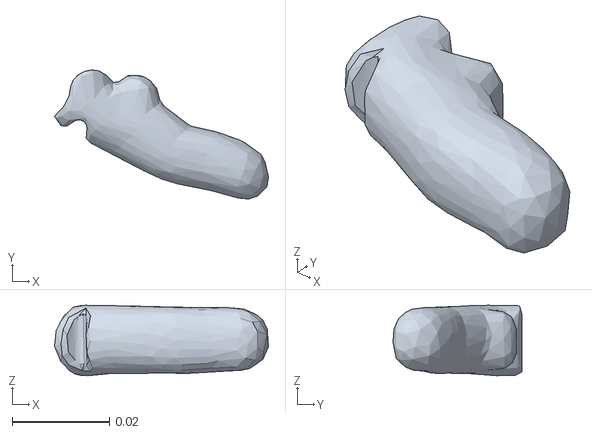
[picture p124: CAD file, 2026-03-09]
src/simulation/mani_skill/assets/robots/ability_hand/meshes/visual/idx-F2.obj
0.0439 x 0.0265 x 0.0145
