STHY0425/LeRobot-Anything-U-Arm-main/src/simulation/mani_skill/assets/robots/ARX-X5/meshes/camera_base.STL

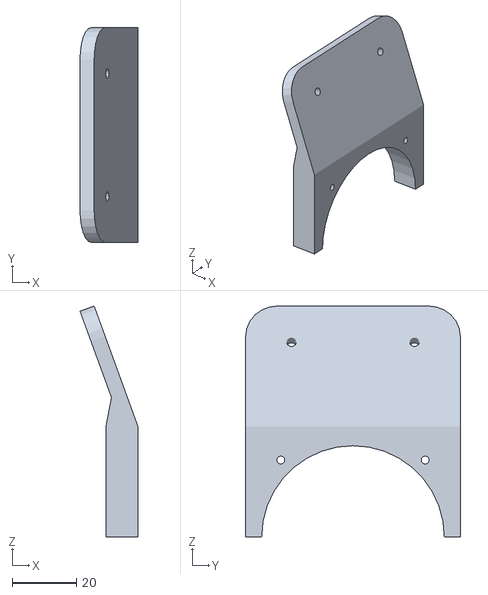
[picture p125: CAD file, 2026-03-09]
src/simulation/mani_skill/assets/robots/ARX-X5/meshes/camera_base.STL
18.1 x 67.0 x 72.1
