STHY0425/LeRobot-Anything-U-Arm-main/src/simulation/mani_skill/assets/robots/fetch_xlerobot/meshes/Moving_Jaw_part1.ply

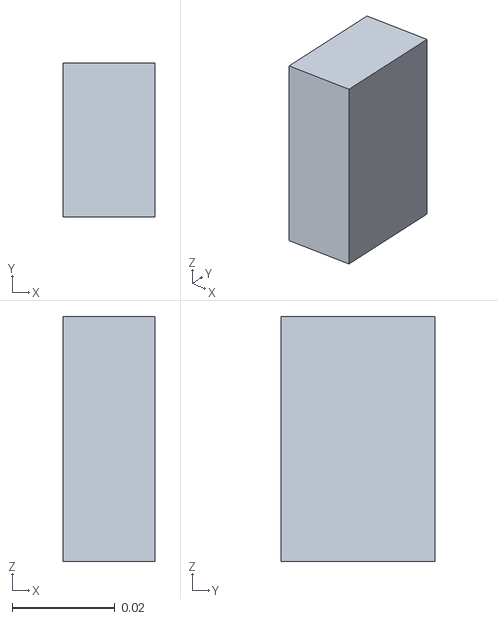
[picture p126: CAD file, 2026-03-09]
src/simulation/mani_skill/assets/robots/fetch_xlerobot/meshes/Moving_Jaw_part1.ply
0.018 x 0.03 x 0.0478
