STHY0425/LeRobot-Anything-U-Arm-main/src/simulation/mani_skill/assets/robots/g1_humanoid/meshes/left_hip_yaw_link.STL

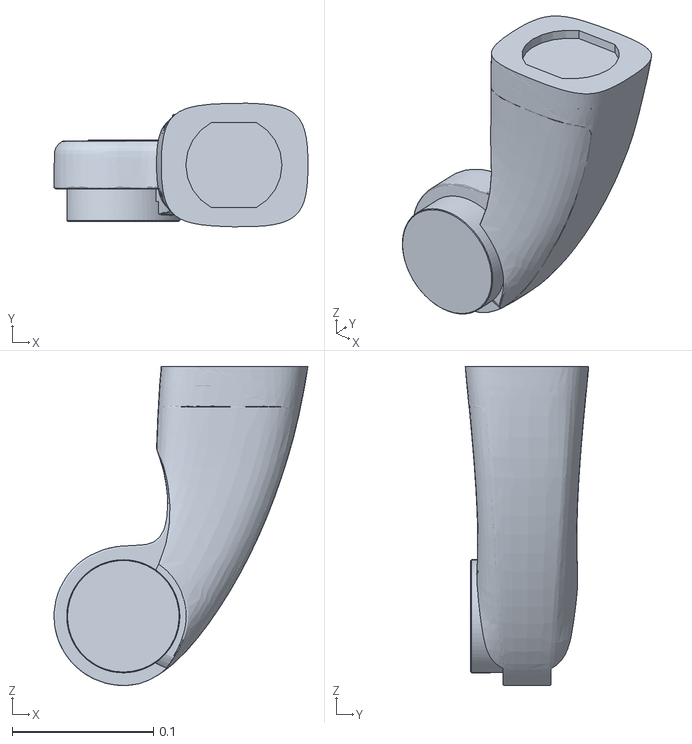
[picture p127: CAD file, 2026-03-09]
src/simulation/mani_skill/assets/robots/g1_humanoid/meshes/left_hip_yaw_link.STL
0.18 x 0.0874 x 0.226
