STHY0425/LeRobot-Anything-U-Arm-main/src/simulation/mani_skill/assets/robots/koch/meshes/link_3_motor.stl

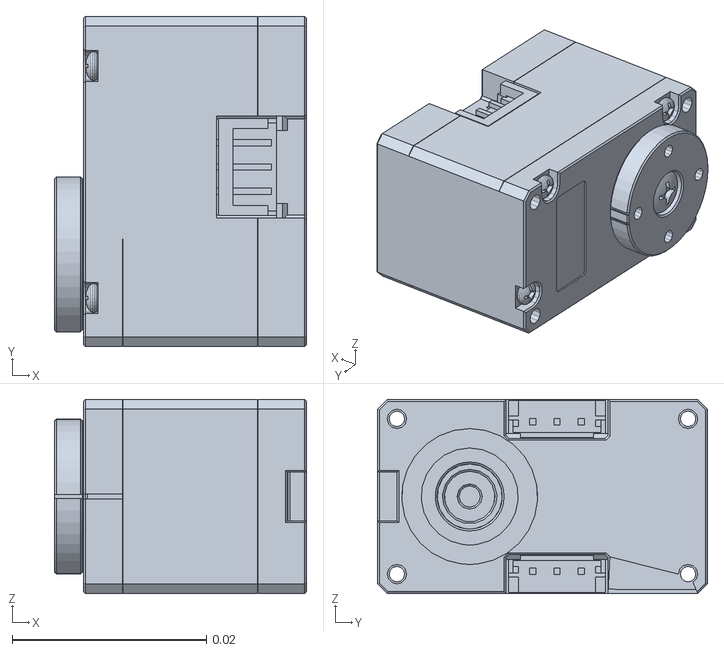
[picture p128: CAD file, 2026-03-09]
src/simulation/mani_skill/assets/robots/koch/meshes/link_3_motor.stl
0.026 x 0.034 x 0.02
