STHY0425/LeRobot-Anything-U-Arm-main/src/simulation/mani_skill/assets/robots/panda/franka_description/meshes/collision/hand.stl.convex.stl

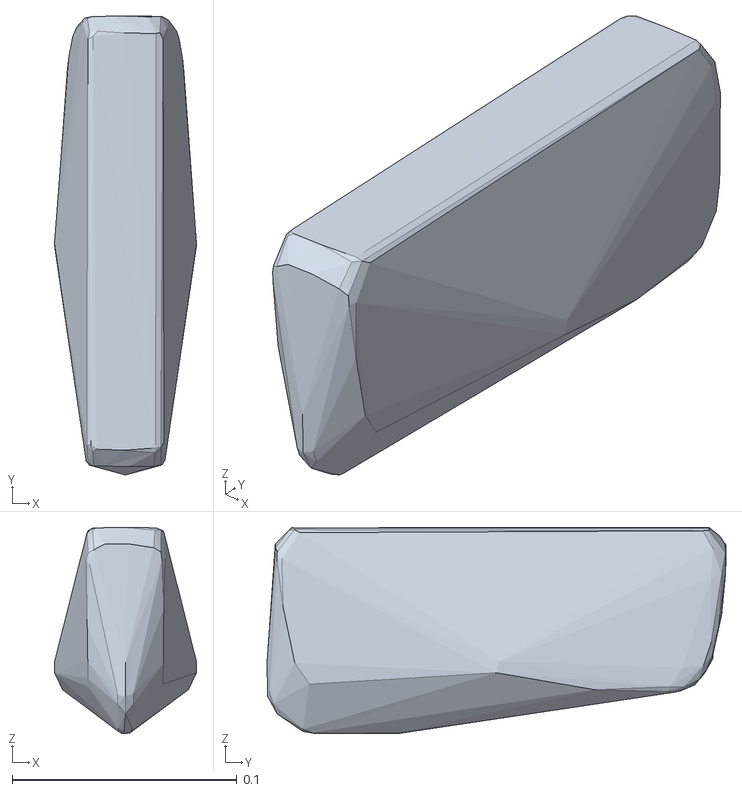
[picture p129: CAD file, 2026-03-09]
src/simulation/mani_skill/assets/robots/panda/franka_description/meshes/collision/hand.stl.convex.stl
0.0633 x 0.204 x 0.0919
