STHY0425/LeRobot-Anything-U-Arm-main/src/simulation/mani_skill/assets/robots/piper/meshes/link5.STL

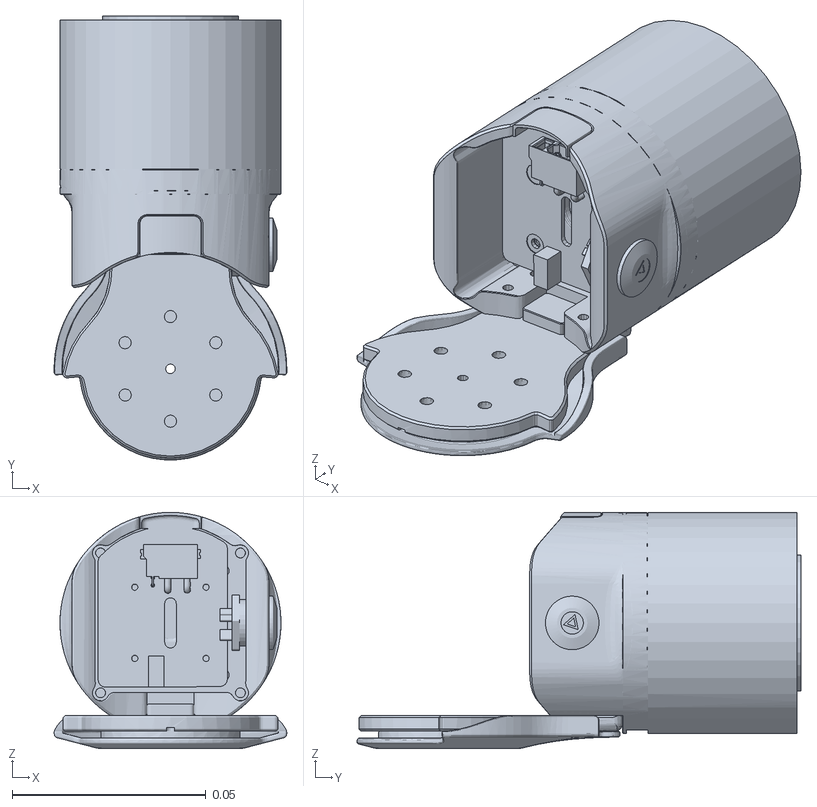
[picture p130: CAD file, 2026-03-09]
src/simulation/mani_skill/assets/robots/piper/meshes/link5.STL
0.06 x 0.115 x 0.0609
