STHY0425/LeRobot-Anything-U-Arm-main/src/simulation/mani_skill/assets/robots/rm65b/meshes/RM65/base_link.STL

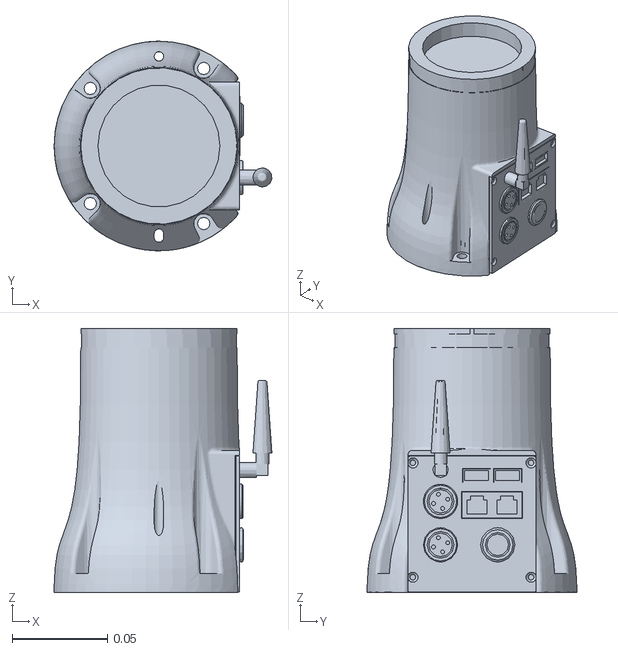
[picture p131: CAD file, 2026-03-09]
src/simulation/mani_skill/assets/robots/rm65b/meshes/RM65/base_link.STL
0.114 x 0.11 x 0.139
