STHY0425/LeRobot-Anything-U-Arm-main/src/simulation/mani_skill/assets/robots/trifinger/robot_properties_fingers/meshes/pro/detailed/SIM__BL-Finger_Center.stl

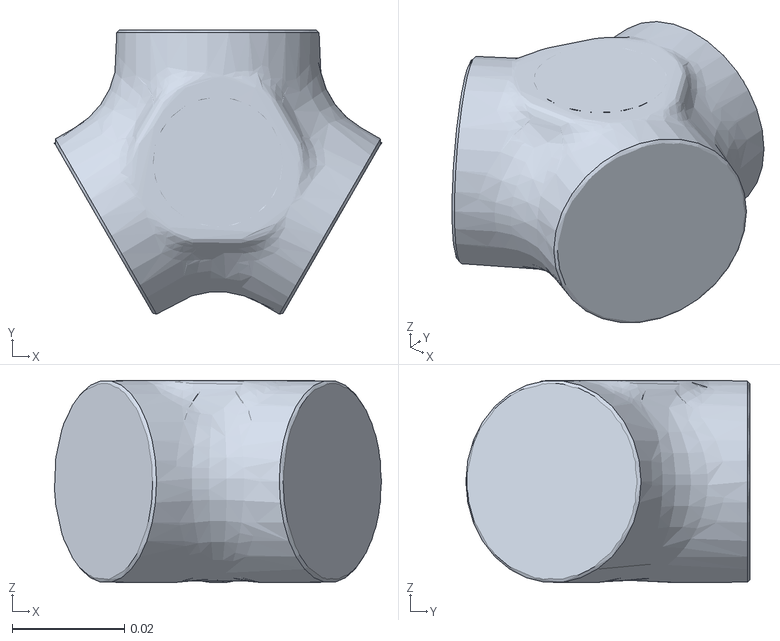
[picture p134: CAD file, 2026-03-09]
src/simulation/mani_skill/assets/robots/trifinger/robot_properties_fingers/meshes/pro/detailed/SIM__BL-Finger_Center.stl
0.0582 x 0.0506 x 0.036
