STHY0425/LeRobot-Anything-U-Arm-main/src/simulation/mani_skill/assets/robots/xarm7/meshes/collision/link4.obj

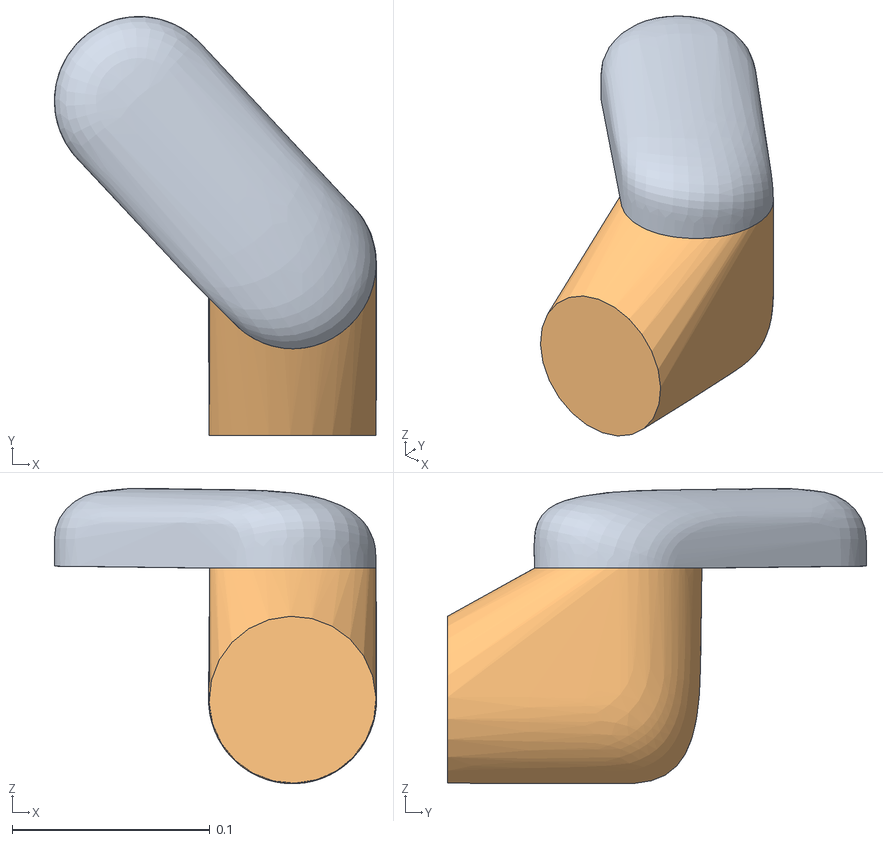
[picture p136: CAD file, 2026-03-09]
src/simulation/mani_skill/assets/robots/xarm7/meshes/collision/link4.obj
0.163 x 0.212 x 0.149
geometry_0
geometry_1
