STHY0425/LeRobot-Anything-U-Arm-main/mechanical/Feetech_servo/Config1_STL/config1 - link3-1.STL

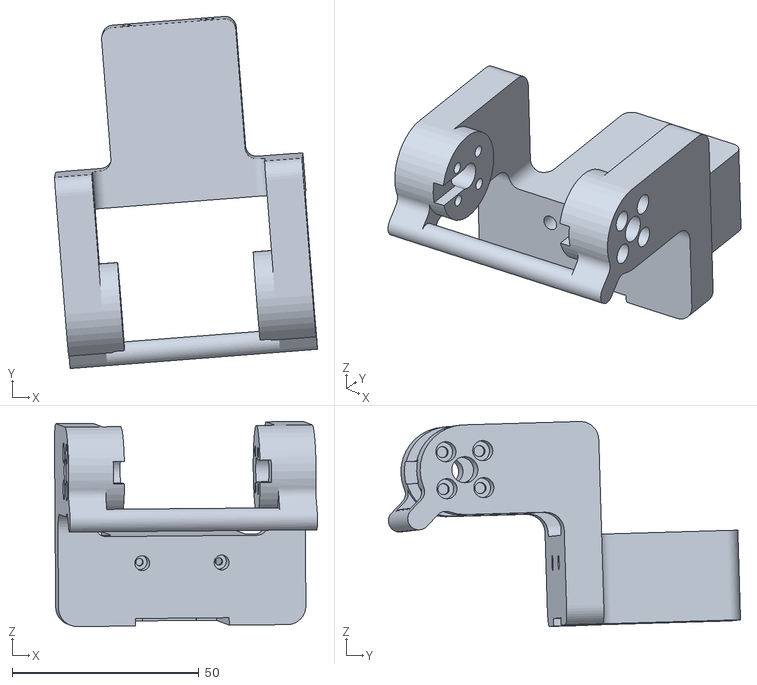
[picture p137: CAD file, 2026-03-09]
mechanical/Feetech_servo/Config1_STL/config1 - link3-1.STL
70.4 x 94.2 x 54.9
