STHY0425/LeRobot-Anything-U-Arm-main/mechanical/Feetech_servo/Config2_STL/config2 - link6-1.STL

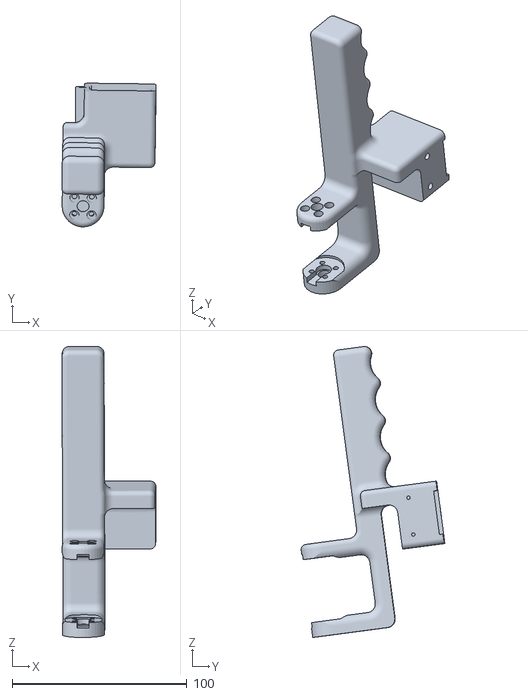
[picture p138: CAD file, 2026-03-09]
mechanical/Feetech_servo/Config2_STL/config2 - link6-1.STL
54.0 x 82.3 x 166.7
