STHY0425/LeRobot-Anything-U-Arm-main/mechanical/Feetech_servo/Config3_STL/config3 - link7-1.STL

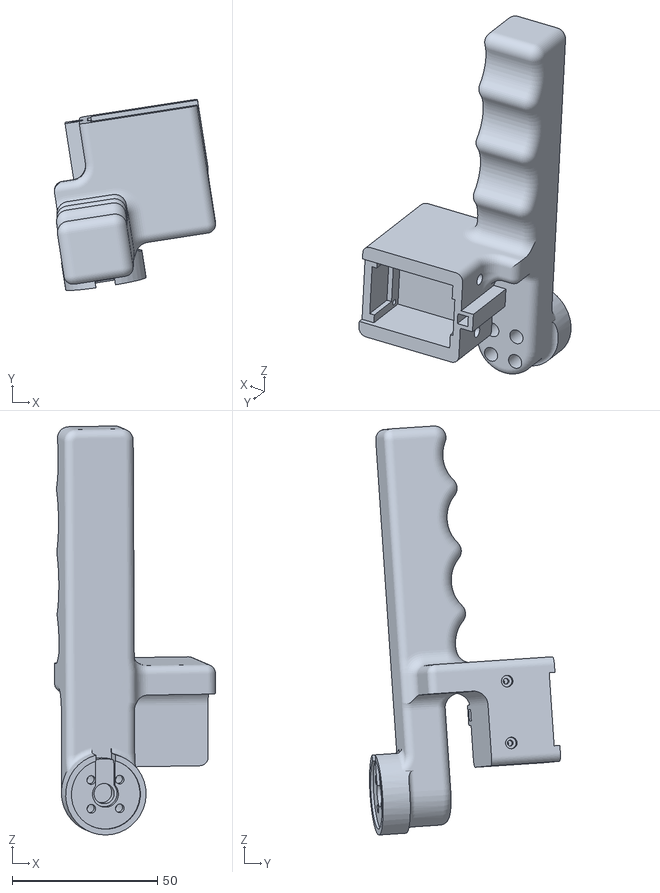
[picture p139: CAD file, 2026-03-09]
mechanical/Feetech_servo/Config3_STL/config3 - link7-1.STL
55.4 x 65.6 x 140.6
