STHY0425/LeRobot-Anything-U-Arm-main/mechanical/Zhonglin_servo/Config2_STL/Config2 - trigger_handle_part1-1.STL

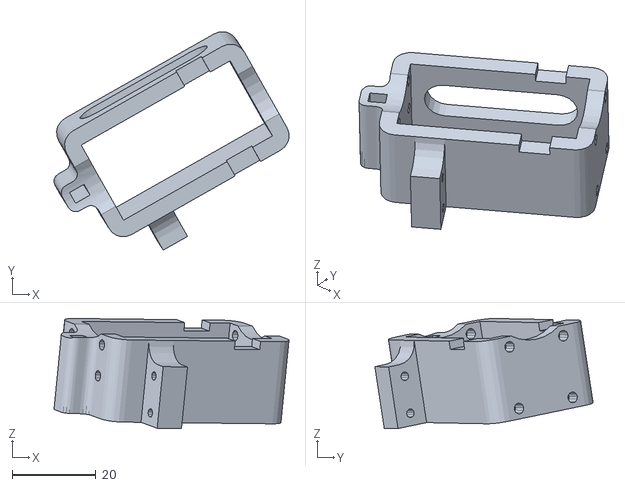
[picture p140: CAD file, 2026-03-09]
mechanical/Zhonglin_servo/Config2_STL/Config2 - trigger_handle_part1-1.STL
56.3 x 52.3 x 26.4
