STHY0425/LeRobot-Anything-U-Arm-main/src/simulation/mani_skill/assets/robots/ability_hand/meshes/visual/wristmesh.obj

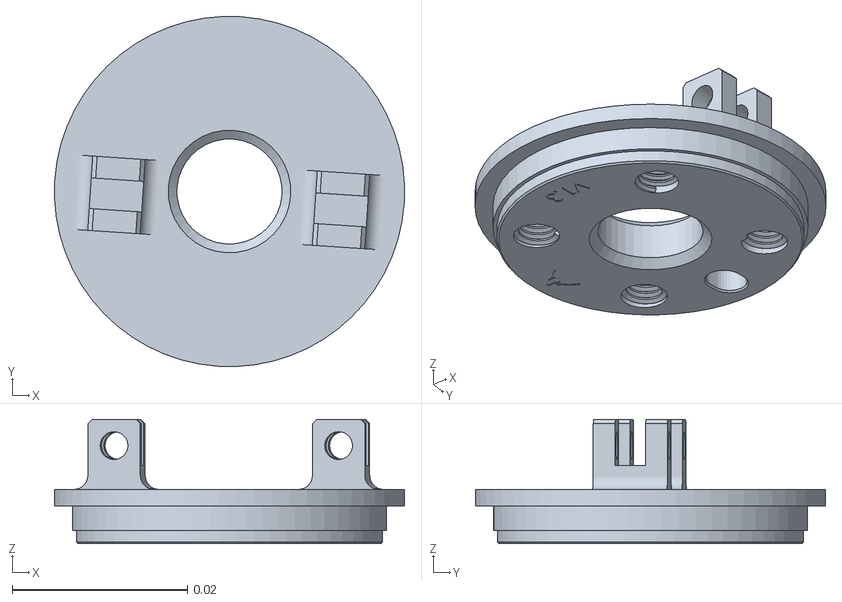
[picture p141: CAD file, 2026-03-09]
src/simulation/mani_skill/assets/robots/ability_hand/meshes/visual/wristmesh.obj
0.04 x 0.04 x 0.0142
