STHY0425/LeRobot-Anything-U-Arm-main/src/simulation/mani_skill/assets/robots/ARX-X5/meshes/link5.STL

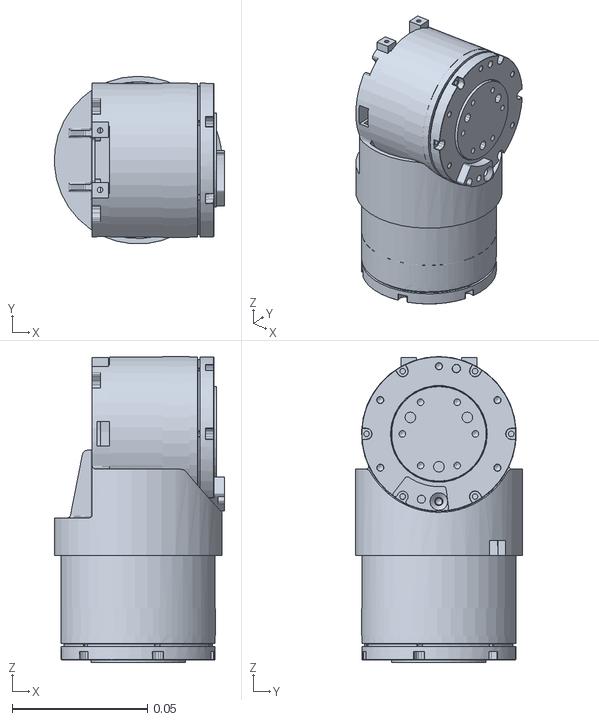
[picture p143: CAD file, 2026-03-09]
src/simulation/mani_skill/assets/robots/ARX-X5/meshes/link5.STL
0.0629 x 0.0619 x 0.113
