STHY0425/LeRobot-Anything-U-Arm-main/(list of files, cad)

Other CAD files:
src/simulation/mani_skill/assets/robots/allegro/meshes/visual/link_tip.obj
src/simulation/mani_skill/assets/robots/g1_humanoid/meshes/right_four_link.STL
mechanical/Feetech_servo/Config2_STL/config2 - sitter-2.STL
src/simulation/mani_skill/assets/robots/ability_hand/meshes/visual/FB_palm_ref.obj
src/simulation/mani_skill/envs/tasks/humanoid/assets/test.obj
mechanical/Feetech_servo/Config3_STL/config3 - sitter-2.STL
src/simulation/mani_skill/assets/robots/ability_hand/meshes/collision/FB_palm_ref.obj
src/simulation/mani_skill/assets/robots/ability_hand/meshes/visual/thumb-F1-MIR.obj
src/simulation/mani_skill/assets/robots/allegro/meshes/visual/link_4.0.obj
mechanical/Feetech_servo/Config1_STL/config1 - link1-1.STL
mechanical/Feetech_servo/Config2_STL/config2 - sitter-1.STL
mechanical/Zhonglin_servo/Config3_STL/Config3 - sitter-2.STL
src/simulation/mani_skill/assets/robots/ability_hand/meshes/collision/thumb-F1-MIR_C.obj
src/simulation/mani_skill/assets/robots/allegro/meshes/visual/link_0.0.obj
src/simulation/mani_skill/assets/robots/fetch/fetch_description/meshes/r_gripper_finger_link.STL
src/simulation/mani_skill/assets/robots/so100/meshes/Rotation_Pitch_Motor.stl
mechanical/Zhonglin_servo/Config1_STL/Config1 - sitter-2.STL
mechanical/Zhonglin_servo/Config3_STL/Config3 - sitter_mid-1.STL
src/simulation/mani_skill/assets/robots/ability_hand/meshes/collision/thumb-F1_C.obj
mechanical/Feetech_servo/Config1_STL/config1 - base-1.STL
mechanical/Feetech_servo/Config1_STL/config1 - link4-1.STL
mechanical/Feetech_servo/Config1_STL/config1 - link5-1.STL
mechanical/Feetech_servo/Config1_STL/config1 - sitter-2.STL
mechanical/Feetech_servo/Config1_STL/config1 - sitter_mid-1.STL
mechanical/Feetech_servo/Config2_STL/config2 - base-1.STL
mechanical/Feetech_servo/Config2_STL/config2 - link4-1.STL
mechanical/Feetech_servo/Config2_STL/config2 - link5-1.STL
mechanical/Feetech_servo/Config2_STL/config2 - sitter_mid-1.STL
mechanical/Feetech_servo/Config2_STL/config2 - trigger_short-1.STL
mechanical/Feetech_servo/Config3_STL/config3 - base-1.STL
mechanical/Feetech_servo/Config3_STL/config3 - link1-1.STL
mechanical/Feetech_servo/Config3_STL/config3 - link3-1.STL
mechanical/Feetech_servo/Config3_STL/config3 - link4-1.STL
mechanical/Feetech_servo/Config3_STL/config3 - sitter-1.STL
mechanical/Feetech_servo/Config3_STL/config3 - sitter_mid-1.STL
mechanical/Zhonglin_servo/Config1_STL/Config1 - Base_gen-1.STL
mechanical/Zhonglin_servo/Config1_STL/Config1 - Joint3_fanuc-1.STL
mechanical/Zhonglin_servo/Config1_STL/Config1 - joint4_support-1.STL
mechanical/Zhonglin_servo/Config1_STL/Config1 - sitter-1.STL
mechanical/Zhonglin_servo/Config1_STL/Config1 - sitter_mid-1.STL
mechanical/Zhonglin_servo/Config1_STL/Config1 - trigger-1.STL
mechanical/Zhonglin_servo/Config2_STL/Config2 - Joint3_fanuc-1.STL
mechanical/Zhonglin_servo/Config2_STL/Config2 - Joint4_UR5-1.STL
mechanical/Zhonglin_servo/Config2_STL/Config2 - L2J2_fanuc-1.STL
mechanical/Zhonglin_servo/Config2_STL/Config2 - joint3_support_UR5-1.STL
mechanical/Zhonglin_servo/Config2_STL/Config2 - joint4_support-2.STL
mechanical/Zhonglin_servo/Config2_STL/Config2 - sitter-1.STL
mechanical/Zhonglin_servo/Config2_STL/Config2 - trigger-1.STL
mechanical/Zhonglin_servo/Config2_STL/Config2 - trigger_handle_part_mix-1.STL
mechanical/Zhonglin_servo/Config3_STL/Config3 - Arm1-1.STL
mechanical/Zhonglin_servo/Config3_STL/Config3 - Base_gen-1.STL
mechanical/Zhonglin_servo/Config3_STL/Config3 - Joint5-1.STL
mechanical/Zhonglin_servo/Config3_STL/Config3 - Link3-1.STL
mechanical/Zhonglin_servo/Config3_STL/Config3 - joint4_support-1.STL
mechanical/Zhonglin_servo/Config3_STL/Config3 - joint4_support-2.STL
mechanical/Zhonglin_servo/Config3_STL/Config3 - sitter-1.STL
mechanical/Zhonglin_servo/Config3_STL/Config3 - trigger-1.STL
src/simulation/mani_skill/assets/robots/ARX-X5/meshes/link1.STL
src/simulation/mani_skill/assets/robots/ARX-X5/meshes/link6.STL
src/simulation/mani_skill/assets/robots/ARX-X5/meshes/link7-old.STL
src/simulation/mani_skill/assets/robots/ARX-X5/meshes/link7.STL
src/simulation/mani_skill/assets/robots/ARX-X5/meshes/link8-old.STL
src/simulation/mani_skill/assets/robots/ability_hand/meshes/collision/wristmesh_C.obj
src/simulation/mani_skill/assets/robots/ability_hand/meshes/visual/idx-F1.obj
src/simulation/mani_skill/assets/robots/ability_hand/meshes/visual/thumb-F2.obj
src/simulation/mani_skill/assets/robots/allegro/meshes/visual/base_link.obj
src/simulation/mani_skill/assets/robots/allegro/meshes/visual/base_link_left.obj
src/simulation/mani_skill/assets/robots/allegro/meshes/visual/link_1.0.obj
src/simulation/mani_skill/assets/robots/allegro/meshes/visual/link_12.0_left.obj
src/simulation/mani_skill/assets/robots/allegro/meshes/visual/link_12.0_right.obj
src/simulation/mani_skill/assets/robots/allegro/meshes/visual/link_2.0.obj
src/simulation/mani_skill/assets/robots/allegro/meshes/visual/link_3.0.obj
src/simulation/mani_skill/assets/robots/fetch/fetch_description/meshes/base_link_collision.STL
src/simulation/mani_skill/assets/robots/fetch/fetch_description/meshes/bellows_link.STL
src/simulation/mani_skill/assets/robots/fetch/fetch_description/meshes/bellows_link_collision.STL
src/simulation/mani_skill/assets/robots/fetch/fetch_description/meshes/elbow_flex_link_collision.STL
src/simulation/mani_skill/assets/robots/fetch/fetch_description/meshes/estop_link.STL
src/simulation/mani_skill/assets/robots/fetch/fetch_description/meshes/gripper_link.STL
src/simulation/mani_skill/assets/robots/fetch/fetch_description/meshes/head_pan_link_collision.STL
src/simulation/mani_skill/assets/robots/fetch/fetch_description/meshes/head_tilt_link_collision.STL
src/simulation/mani_skill/assets/robots/fetch/fetch_description/meshes/l_wheel_link.STL
src/simulation/mani_skill/assets/robots/fetch/fetch_description/meshes/l_wheel_link_collision.STL
src/simulation/mani_skill/assets/robots/fetch/fetch_description/meshes/laser_link.STL
src/simulation/mani_skill/assets/robots/fetch/fetch_description/meshes/r_wheel_link.STL
src/simulation/mani_skill/assets/robots/fetch/fetch_description/meshes/r_wheel_link_collision.STL
src/simulation/mani_skill/assets/robots/fetch/fetch_description/meshes/shoulder_lift_link_collision.STL
src/simulation/mani_skill/assets/robots/fetch/fetch_description/meshes/torso_fixed_link.STL
src/simulation/mani_skill/assets/robots/fetch/fetch_description/meshes/torso_lift_link_collision.STL
src/simulation/mani_skill/assets/robots/fetch/fetch_description/meshes/upperarm_roll_link_collision.STL
src/simulation/mani_skill/assets/robots/fetch/fetch_description/meshes/wrist_roll_link_collision.STL
src/simulation/mani_skill/assets/robots/fetch_xlerobot/meshes/Base.stl.convex.stl
src/simulation/mani_skill/assets/robots/fetch_xlerobot/meshes/Base_Motor.stl
src/simulation/mani_skill/assets/robots/fetch_xlerobot/meshes/Base_Motor.stl.convex.stl
src/simulation/mani_skill/assets/robots/fetch_xlerobot/meshes/Fixed_Jaw.stl
src/simulation/mani_skill/assets/robots/fetch_xlerobot/meshes/Fixed_Jaw.stl.convex.stl
src/simulation/mani_skill/assets/robots/fetch_xlerobot/meshes/Fixed_Jaw_Motor.stl.convex.stl
src/simulation/mani_skill/assets/robots/fetch_xlerobot/meshes/Fixed_Jaw_part1.ply
src/simulation/mani_skill/assets/robots/fetch_xlerobot/meshes/Fixed_Jaw_part2.ply
src/simulation/mani_skill/assets/robots/fetch_xlerobot/meshes/Fixed_Jaw_part2.ply.convex.stl
src/simulation/mani_skill/assets/robots/fetch_xlerobot/meshes/Lower_Arm.stl
src/simulation/mani_skill/assets/robots/fetch_xlerobot/meshes/Lower_Arm_Motor.stl
src/simulation/mani_skill/assets/robots/fetch_xlerobot/meshes/Lower_Arm_Motor.stl.convex.stl
src/simulation/mani_skill/assets/robots/fetch_xlerobot/meshes/Moving_Jaw.stl
src/simulation/mani_skill/assets/robots/fetch_xlerobot/meshes/Moving_Jaw_part1.ply.convex.stl
src/simulation/mani_skill/assets/robots/fetch_xlerobot/meshes/Moving_Jaw_part2.ply
src/simulation/mani_skill/assets/robots/fetch_xlerobot/meshes/Moving_Jaw_part2.ply.convex.stl
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
