STHY0425/LeRobot-Anything-U-Arm-main/src/uarm/scripts/Follower_Arm/realman/Version_1/MAPPING_GUIDE.md

# 瑞尔曼机械臂 - 完整操作指南（动态零点校准版）

> **快速开始**：按顺序执行 [软件启动流程](#软件启动流程) 的步骤即可运行。
> 
> **版本说明**：本版本支持**动态零点校准**，启动时自动记录当前舵机位置作为零点。

## 目录
1. [硬件连接](#硬件连接)
2. [软件启动流程](#软件启动流程)
3. [数据映射说明](#数据映射说明)
4. [舵机控制](#舵机控制)
5. [故障排查](#故障排查)

---

## 硬件连接

### 连接示意图

```
┌─────────────────┐      USB      ┌─────────────────┐     网线/WiFi    ┌─────────────────┐
│   电脑/Ubuntu   │  ───────────→  │  舵机主臂控制板  │                │                 │
│   (ROS环境)     │   /dev/ttyUSB0 │  (串口通信)     │                │  瑞尔曼机械臂    │
│                 │                │                 │                │  RM-65          │
│                 │  ───────────────────────────────→│                │  (IP:192.168.   │
│                 │        网线或WiFi连接            │                │      1.18)      │
└─────────────────┘                               └─────────────────┘
```

### 1. 瑞尔曼机械臂连接

#### 1.1 物理连接
1. **电源连接**：将机械臂电源适配器连接到机械臂底座
2. **网络连接**：
   - **有线**：网线连接机械臂和电脑
   - **无线**：机械臂连接WiFi，确保和电脑在同一网络

#### 1.2 网络配置
1. **进入有线连接网络配置**：在IPV4界面点击手动选项
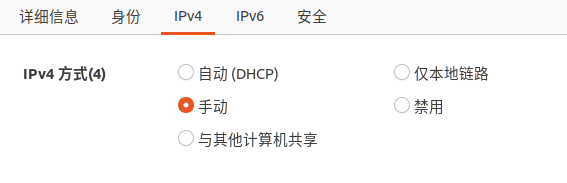
[picture p144: src/uarm/scripts/Follower_Arm/realman/Version_1/image-1.png]

2. **网络地址设置**：
   - **地址**：192.168.1.10
   - **子网掩码**：255.255.255.0
   - **网关**：192.168.1.1
3. **睿尔曼官方示教育器**：打开网址：http://192.168.1.18/#/
```bash
# 检查网络连接
ping 192.168.1.18

#### 1.3 验证机械臂状态
机械臂上电后，听到"滴"声表示启动完成。观察指示灯：
- **绿色常亮**：正常待机
- **红色**：急停状态或错误
- **闪烁**：通信中

### 2. 舵机主臂连接

#### 2.1 串口连接
1. 将舵机控制板通过USB线连接到电脑
2. 检查串口设备：

```bash
# 查看串口设备
ls -la /dev/ttyUSB*

# 输出示例：/dev/ttyUSB0

# 如果没有权限，添加用户到dialout组
sudo usermod -a -G dialout $USER
# 然后重新登录或重启
```

#### 2.2 验证串口
```bash
# 安装串口工具
sudo apt-get install picocom

# 测试连接（按Ctrl+A然后X退出）
picocom -b 115200 /dev/ttyUSB0
```

---

## 软件启动流程

### 完整启动顺序

```
步骤1: 启动roscore
    ↓
步骤2: 启动瑞尔曼官方驱动 (rm_driver)
    ↓
步骤3: 启动遥操节点 (realman_teleop_optimized.py)
    │   └── 自动完成：释放力矩 → 等待调整 → 记录零点
    ↓
步骤4: 使能遥操作
    ↓
步骤5: 移动主臂，从臂跟随
```

> **注意**：本版本**不再需要** `servo_reader.py`，遥操节点直接读取舵机！

### 步骤1: 启动ROS核心

```bash
# 打开终端1
roscore
```

### 步骤2: 启动瑞尔曼官方驱动

```bash
# 打开终端2
# 方法1：使用launch文件（推荐）
需要在catkin_ws目录下运行：
source ./devel/setup.bash
（每一个目录都要source）
roslaunch rm_driver rm_65_driver.launch

```bash
# 打开终端，检查话题
rostopic list | grep rm_driver

# 应该看到以下话题：
# /rm_driver/Arm_Current_State
# /rm_driver/JointPos
# /rm_driver/Gripper_Set
# /rm_driver/Stop

# 检查机械臂状态
rostopic echo /rm_driver/Arm_Current_State
# 按Ctrl+C退出
```

### 步骤3: 启动遥操节点

```bash
# 打开终端3
cd /home/sthy/2026robotic/LeRobot-Anything-U-Arm-main

# 基本启动
rosrun uarm realman_teleop_optimized.py

# 或带参数启动
rosrun uarm realman_teleop_optimized.py \
    _init_qpos:="[0.0, 0.0, 0.0, 0.0, 0.0, 0.0]" \
    _joint_invert:="[1.0, 1.0, 1.0, 1.0, 1.0, 1.0]"
```

**启动流程说明**：
1. 打开串口连接舵机
2. **释放舵机力矩**（可手动调整主臂）
3. **等待3秒**让你调整主臂到期望的零点姿态
4. **自动记录**当前舵机位置作为零点
5. 进入等待使能状态

**启动日志示例**：
```
[RealManOpt] 启动优化遥操节点（动态零点校准版）...
[Servo] 串口已打开: /dev/ttyUSB0 @ 115200
[Servo] 正在初始化舵机零点...
[Servo] 释放力矩，请调整主臂到期望的零点位置...
[Servo] 等待3秒让您调整主臂姿态...
[Servo] 正在记录零点位置...
[Servo] 舵机0: 零点 = 142.5°
[Servo] 舵机1: 零点 = 138.2°
[Servo] 舵机2: 零点 = 135.0°
...
[Servo] ✅ 零点校准完成！
[Servo] 零点角度: ['142.5', '138.2', '135.0', ...]
[RealManOpt] 机械臂型号: RM_65, DOF: 6
[RealManOpt] 瑞尔曼零点姿态: [0.0, 0.0, 0.0, 0.0, 0.0, 0.0]
[RealManOpt] 舵机零点位置: ['142.5', '138.2', '135.0', ...]
[RealManOpt] 等待使能信号...
[RealManOpt] 提示: 发布 Bool(True) 到 /realman_teleop/enable 使能
```

### 步骤4: 使能遥操作

```bash
# 打开终端4

# 使能遥操作（主从臂开始同步）
rostopic pub /realman_teleop/enable std_msgs/Bool "data: true"

# 验证使能成功
rostopic echo /realman_teleop/status
# 应该显示：data: True
```

**此时**：
- 移动主臂，从臂应该跟随移动
- 注意从臂速度限制（默认30°/s）
- 当主臂在零点位置时，从臂保持 `init_qpos` 姿态（默认全0）

---

## 运行时控制

### 常用命令

```bash
# 1. 查看当前状态
rostopic echo /realman_teleop/status

# 2. 查看发送给机械臂的角度
rostopic echo /rm_driver/JointPos

# 3. 查看当前记录的零点（调试用）
rostopic echo /realman_teleop/zero_angles

# 4. 释放舵机力矩（重新调整主臂零点）
rostopic pub /realman_teleop/release_servos std_msgs/Bool "data: true"
# 注意：释放后需要重启节点重新校准零点

# 5. 失能遥操作
rostopic pub /realman_teleop/enable std_msgs/Bool "data: false"

# 6. 触发急停
rostopic pub /realman_teleop/emergency_stop std_msgs/Bool "data: true"
```

### 调整映射参数

如果主从臂方向相反或比例不对：

```bash
# 修改关节方向（例如第3个关节反向）
rosrun uarm realman_teleop_optimized.py _joint_invert:="[1.0, 1.0, -1.0, 1.0, 1.0, 1.0]"

# 修改关节缩放
rosrun uarm realman_teleop_optimized.py _joint_scale:="[1.0, 1.0, 0.8, 1.0, 1.0, 1.0]"
```

---

## 数据映射说明

### 架构图（双线程架构）

```
┌─────────────────────────────────────────────────────────────────────────────────┐
│                         realman_teleop_optimized.py                              │
│                                                                                  │
│  ┌──────────────────┐      命令队列(Queue)      ┌──────────────────┐            │
│  │  舵机读取线程     │  ─────────────────────→  │  命令发布线程     │            │
│  │  ~7Hz (串行读取)  │   只保留最新目标角度      │  30Hz 稳定输出   │            │
│  │                  │                         │                  │            │
│  │ 1. 读取7个舵机   │                         │ 1. 速度限制       │            │
│  │ 2. 计算偏移量    │                         │ 2. 发布给机械臂   │            │
│  │ 3. 平滑滤波       │                         │                  │            │
│  │ 4. 放入队列      │                         │                  │            │
│  └──────────────────┘                         └──────────────────┘            │
│         ↑                                              ↓                       │
│    串口/dev/ttyUSB0                              ROS话题                       │
│         ↑                                              ↓                       │
└─────────┼──────────────────────────────────────────────┼───────────────────────┘
          │                                              │
┌─────────┴─────────┐                            ┌──────┴──────────┐
│   舵机主臂        │                            │   rm_driver     │
│  (任意位置)       │                            │  (官方驱动)     │
└───────────────────┘                            └─────────────────┘
                                                          ↓
                                                 ┌─────────────────┐
                                                 │  瑞尔曼机械臂    │
                                                 └─────────────────┘
```

### 与老版本的区别

| 特性 | 老版本 | 新版本（当前） |
|---|---|---|
| 依赖 | 需要 `servo_reader.py` | ✅ **独立运行**，直接读取舵机 |
| 架构 | 单线程 | ✅ **双线程**：读取线程 + 发布线程 |
| 零点 | 固定135° | ✅ **动态校准**，启动时记录当前位置 |
| 延迟 | 可能有累积 | ✅ **队列只保留最新**，避免延迟 |
| 发布频率 | 与读取频率相同 (~7Hz串行) | ✅ **独立30Hz**，平滑输出 |

### 双线程工作原理

#### 线程1：舵机读取线程（生产者）
```
频率: ~7Hz (串行读取7个舵机，每个约20ms，总计约140ms)
职责:
  1. 通过串口串行读取7个舵机当前角度（非并行，受限于单串口）
  2. 计算相对于 zero_angles 的偏移量
  3. 低通平滑滤波
  4. 将目标角度放入队列 (只保留最新)
```

#### 线程2：命令发布线程（消费者）
```
频率: 30Hz (33ms周期，稳定输出)
职责:
  1. 从队列获取最新目标角度
  2. 应用速度限制 (默认30°/s)
  3. 发布到 /rm_driver/JointPos
  4. 无新数据时保持位置 (速度限制后的角度)
```

#### 队列机制
- **类型**: `Queue(maxsize=1)` - 只保留最新命令
- **作用**: 解耦读取和发布，避免延迟累积
- **清空策略**: 每次放入新数据前清空旧数据

### 零点校准原理

**启动时**：
1. 释放舵机力矩
2. 等待3秒让用户调整主臂到期望的零点姿态
3. 读取当前7个舵机的角度，记录为 `zero_angles`

**运行时**：
```
偏移量 = 当前舵机角度 - zero_angles[i]
瑞尔曼目标角度 = init_qpos_deg[i] + 偏移量 × joint_scale[i] × joint_invert[i]
```

**举例**：
- 零点校准时舵机0在 140°
- 运行时舵机0移动到 150°
- 偏移量 = 150° - 140° = 10°
- 瑞尔曼关节0目标 = 0° + 10° = 10°

### 完整数据流

```
┌──────────────┐     ┌──────────────┐     ┌──────────────┐     ┌──────────────┐
│   舵机主臂    │ ──→ │   读取线程    │ ──→ │   命令队列    │ ──→ │   发布线程    │
│  (当前角度)   │     │  计算偏移量   │     │  目标角度     │     │  速度限制     │
└──────────────┘     └──────────────┘     └──────────────┘     └──────┬───────┘
     ↑                                                                 ↓
     └────────────────────────────────────────────────────────────────┘
                         反馈控制 (机械臂运动后不影响主臂)

数据转换过程:
  1. 原始角度: angles[i] (0-270° PWM舵机角度)
  2. 偏移量: offset = angles[i] - zero_angles[i] (相对零点的度数)
  3. 目标角度: target = init_qpos_deg[i] + offset × scale × invert
  4. 速度限制: safe = velocity_limit(target, last, max_speed=30°/s)
  5. 发布: /rm_driver/JointPos
```

### 映射公式

```
瑞尔曼目标角度 = init_qpos_deg[i] + (当前角度 - zero_angles[i]) × joint_scale[i] × joint_invert[i]
```

### 参数说明

| 参数 | 作用 | 默认值 | 说明 |
|---|---|---|---|
| `init_qpos_deg` | 瑞尔曼零点姿态 | `[0,0,0,0,0,0]` | 当舵机偏移为0时的姿态 |
| `zero_angles` | 舵机零点位置 | **动态读取** | 启动时自动记录 |
| `joint_scale` | 关节缩放 | `[1,1,1,1,1,1]` | 主从关节比例差异 |
| `joint_invert` | 关节方向 | `[1,1,1,1,1,1]` | 关节旋转方向反转 |

### 线程性能参数

| 参数 | 默认值 | 说明 | 可调范围 |
|---|---|---|---|
| `publish_rate` | `30.0` | 发布线程频率 (Hz) | 20-50Hz |
| `max_joint_speed` | `30.0` | 关节速度限制 (°/s) | 10-50°/s |
| `filter_alpha` | `0.3` | 滤波系数 | 0.1-1.0 |

> **注意**：舵机读取频率 (~7Hz) 由**串行读取**决定，**不可调**。
> 代码采用串行方式读取7个舵机，每个约20ms，总计约140ms，理论最大频率约 7Hz。
> 
> 如需提高频率，需要：
> - 使用支持并行读取的舵机控制板
> - 或改用总线协议（如RS485/CAN）批量读取

### 常用配置方案

#### 方案1：直立姿态对应（推荐）

**场景**：主臂直立 = 从臂直立

```bash
rosrun uarm realman_teleop_optimized.py \
    _init_qpos:="[0.0, 0.0, 0.0, 0.0, 0.0, 0.0]" \
    _joint_scale:="[1.0, 1.0, 1.0, 1.0, 1.0, 1.0]" \
    _joint_invert:="[1.0, 1.0, 1.0, 1.0, 1.0, 1.0]"
```

**效果**：
- 主臂在校准零点位置 → 从臂 [0,0,0,0,0,0]（直立）
- 主臂关节0偏移 +10° → 从臂关节0 +10°

#### 方案2：标准初始姿态

**场景**：使用瑞尔曼标准初始姿态

```bash
rosrun uarm realman_teleop_optimized.py \
    _init_qpos:="[0.0, -20.0, -90.0, 0.0, 90.0, 0.0]"
```

**效果**：
- 主臂在校准零点位置 → 从臂 [0,-20,-90,0,90,0]（工作姿态）
- 适合特定工作场景

#### 方案3：带方向反转

**场景**：某个关节需要反向

```bash
rosrun uarm realman_teleop_optimized.py \
    _joint_invert:="[1.0, 1.0, -1.0, 1.0, 1.0, 1.0]"
```

**效果**：
- 关节3（索引2）方向反转
- 主臂 +10° → 从臂关节3 -10°

## 调试方法

### 1. 查看线程性能

启动节点后会自动打印线程频率：
```
[ServoThread] 读取频率: 7.1Hz, 丢包: 0
[PublishThread] 发布频率: 30.0Hz
```

### 2. 查看当前数据

```bash
# 终端1：查看记录的零点
rostopic echo /realman_teleop/zero_angles

# 终端2：查看瑞尔曼目标角度
rostopic echo /rm_driver/JointPos

# 终端3：查看遥操状态
rostopic echo /realman_teleop/status
```

### 2. 零点对齐测试

```bash
# 1. 调整主臂到期望的零点姿态
# 2. 启动节点（会自动记录当前位置为零点）
rosrun uarm realman_teleop_optimized.py _init_qpos:="[0,0,0,0,0,0]"

# 3. 使能并观察从臂姿态
rostopic pub /realman_teleop/enable std_msgs/Bool "data: true"

# 4. 此时从臂应该在 init_qpos 姿态
# 5. 如果从臂不是预期姿态，调整 init_qpos 或 joint_invert
```

### 3. 单关节测试

```bash
# 单独转动主臂的第1个关节，观察从臂
# 如果方向相反，修改 joint_invert[0] 为 -1
# 如果比例不对，调整 joint_scale[0]
```

### 4. 线程监控

```bash
# 查看线程是否正常运行
rostopic echo /realman_teleop/status

# 如果显示 data: False，检查：
# 1. 是否已使能: rostopic pub /realman_teleop/enable std_msgs/Bool "data: true"
# 2. 是否有错误日志
# 3. 舵机读取是否正常
```

## 舵机力矩控制

### 运行时释放力矩

在节点运行过程中，可以释放舵机力矩重新调整：

```bash
# 释放力矩
rostopic pub /realman_teleop/release_servos std_msgs/Bool "data: true"

# 调整主臂姿态后，需要重启节点重新校准零点
```

### 修改串口参数

```bash
rosrun uarm realman_teleop_optimized.py \
    _servo_serial_port:="/dev/ttyUSB1" \
    _servo_baudrate:=115200
```

## 启动流程示例

### 启动阶段

```bash
# 1. 启动瑞尔曼官方驱动
roslaunch rm_driver rm_65.launch

# 2. 启动遥操节点（自动完成零点校准）
rosrun uarm realman_teleop_optimized.py

# 3. 使能遥操作（主从臂开始同步）
rostopic pub /realman_teleop/enable std_msgs/Bool "data: true"
```

### 退出阶段（重要！）

```bash
# 4. 先将主臂调整到安全/直立姿态
#    （从臂会跟随到对应姿态）

# 5. 失能遥操作
rostopic pub /realman_teleop/enable std_msgs/Bool "data: false"

# 6. 等待机械臂稳定后，按 Ctrl+C 退出节点
#    （或关闭终端）

# 7. （可选）使用官方工具将机械臂回到零点
#    或使用示教器控制
```

## 注意事项

1. **单位统一**：舵机角度和瑞尔曼都使用度数
2. **零点定义**：每次启动时动态记录，不是固定的135°
3. **安全限位**：代码中有 [-178, 178] 等关节限位保护
4. **速度限制**：默认30°/s，可通过 `max_joint_speed` 调整
5. **串口独占**：本节点独占舵机串口，不需要 servo_reader.py
6. **双线程架构**：读取 (~7Hz串行) 和发布 (30Hz) 是独立线程，通过队列通信
7. **⚠️ 退出警告**：节点退出时机械臂会**停在当前位置**，不会自动回到零点。务必先调整到安全姿态再退出！

---

## 舵机数据异常处理机制

### 异常检测策略

代码内置多层舵机数据保护机制：

| 检测层级 | 检测内容 | 阈值 | 处理方式 |
|---|---|---|---|
| **PWM范围** | 原始PWM值 | [400, 2600] | 超范围视为无效，返回None |
| **角度范围** | 计算角度 | [0°, 270°] | 超范围视为无效，返回None |
| **跳变检测** | 单帧变化 | ≤30° | 超阈值忽略该帧数据 |
| **连续失败** | 单关节失败次数 | 5次 | 标记关节异常，暂停控制 |
| **整帧失败** | 有效舵机数 | ≥5个 | 不足时丢弃整帧数据 |
| **时间保护** | dt异常 | <0 或 >1s | 使用最小间隔或重置状态 |

### 异常处理流程

```
读取舵机角度
    ↓
PWM范围检查 → 失败 → 失败计数+1
    ↓ 通过
角度范围检查 → 失败 → 失败计数+1
    ↓ 通过
跳变检测 → 失败 → 失败计数+1
    ↓ 通过
更新有效角度 & 重置失败计数
    ↓
检查失败计数 ≥ 5?
    ↓ 是
标记舵机异常 → 使能失败/控制暂停
```

### 舵机状态监控

运行时可通过日志观察舵机状态：

```
# 正常状态
[Servo] 舵机0: 零点 = 142.5°
[ServoThread] 读取频率: 7.1Hz, 丢包: 0

# 单帧跳变警告
[Servo] 舵机2 角度跳变: 142.5°→200.0° (Δ57.5°)，忽略

# PWM异常警告
[Servo] 舵机3 PWM值3200超出范围[400, 2600]

# 连续失败报警
[Servo] 舵机5 连续失败5次，标记为异常
[RealManOpt] ⚠️ 使能失败: 舵机[5]处于异常状态

# 运行时异常检测
[RealManOpt] 舵机[2,4]异常，暂停控制
```

---

## 故障排查

### 瑞尔曼驱动启动问题

#### 问题1：`roslaunch rm_driver rm_65.launch` 失败

**现象**：
```
[ERROR] 无法连接到机械臂
```

**排查步骤**：
```bash
# 1. 检查网络连接
ping 192.168.1.18

# 2. 如果ping不通，检查IP配置
# 查看机械臂实际IP（通常在示教器或配置软件中查看）
# 修改launch文件中的IP参数
roslaunch rm_driver rm_65.launch robot_ip:=192.168.1.XX

# 3. 检查防火墙
sudo ufw disable  # 临时关闭防火墙测试

# 4. 检查网线连接
# 有线连接时，设置电脑为静态IP
sudo ifconfig eth0 192.168.1.100 netmask 255.255.255.0
```

#### 问题2：驱动启动但无话题输出

**排查**：
```bash
# 检查roscore是否运行
rosnode list

# 检查话题
rostopic list | grep rm_driver

# 查看驱动节点日志
roslaunch rm_driver rm_65.launch --screen
```

### 舵机读取问题

#### 问题3：遥操节点无法打开串口

**现象**：
```
[ERROR] [Servo] 无法打开串口 /dev/ttyUSB0
```

**排查步骤**：
```bash
# 1. 检查设备是否存在
ls -la /dev/ttyUSB*

# 2. 如果没有设备，检查USB连接
# 更换USB线或USB口

# 3. 如果有设备但无权限
sudo chmod 666 /dev/ttyUSB0
# 或永久解决
sudo usermod -a -G dialout $USER
# 然后重新登录

# 4. 检查串口被占用（例如 servo_reader.py 在运行）
lsof /dev/ttyUSB0
# 结束占用进程
# 注意：本版本不再需要 servo_reader.py，请关闭它
```

#### 问题4：零点校准失败

**现象**：
```
[Servo] 舵机X: 读取失败，使用默认值 135.0°
```

**可能原因**：
| 原因 | 检查方法 | 解决方案 |
|---|---|---|
| **舵机电源未连接** | 检查舵机控制板电源指示灯 | 连接12V/5V电源（根据舵机规格） |
| **USB线松动/损坏** | 更换USB线，检查连接 | 更换高质量USB线 |
| **串口被占用** | `lsof /dev/ttyUSB0` | 关闭占用进程（如旧版servo_reader.py） |
| **波特率不匹配** | 检查舵机控制板配置 | 确认波特率为115200 |
| **舵机ID配置错误** | 舵机ID应为0-6 | 使用舵机调试工具检查ID配置 |
| **舵机损坏** | 单独测试该舵机 | 更换损坏的舵机 |
| **电磁干扰** | 远离电机等大功率设备 | 使用屏蔽线，缩短USB线长度 |

**排查步骤**：
```bash
# 1. 检查舵机电源是否连接
# 2. 检查串口线是否松动
# 3. 检查波特率是否匹配（默认115200）
# 4. 检查舵机控制板是否正常工作

# 5. 使用串口工具直接测试舵机
picocom -b 115200 /dev/ttyUSB0
# 发送测试命令: #000PRAD! (读取0号舵机)
# 正常应返回类似: #000P1500!

# 6. 如果多个舵机失败，检查总线供电
# 测量舵机控制板供电电压，应在5V/12V±5%范围内
```

#### 问题4a：零点校准多个舵机失败

**现象**：
```
[Servo] ⚠️ 警告: 3个舵机零点读取失败，请检查硬件连接
```

**可能原因**：
1. **舵机控制板供电不足** - 多个舵机同时上电导致电压跌落
2. **串口信号干扰** - USB转串口模块质量问题
3. **舵机总线冲突** - 舵机ID重复或总线拓扑问题

**解决方案**：
```bash
# 检查供电
# 测量舵机控制板Vin和GND之间的电压
# 应在规格范围内（通常5V或12V）

# 检查舵机ID
# 使用舵机配置工具确保ID为0-6且不重复

# 降低读取频率（修改代码）
# 在 _read_servo_angle 中增加time.sleep(0.01)
```

### 遥操作问题

#### 问题5：使能后从臂不动

**现象**：发布使能命令后，`/realman_teleop/status`显示`data: False`

**排查步骤**：
```bash
# 1. 检查遥操状态
rostopic echo /realman_teleop/status

# 2. 检查realman_teleop是否发布控制命令
rostopic echo /rm_driver/JointPos

# 3. 检查瑞尔曼错误码
rostopic echo /rm_driver/Arm_Current_State
# 查看err字段是否有错误

# 4. 检查零点是否正确记录
rostopic echo /realman_teleop/zero_angles

# 5. 检查线程是否正常运行（查看日志是否有线程启动信息）
# 预期输出:
# [RealManOpt] 舵机读取线程已启动
# [RealManOpt] 命令发布线程已启动

# 6. 检查是否有舵机异常（关键！）
# 查看启动日志中是否有：
# [RealManOpt] ⚠️ 使能失败: 舵机[X]处于异常状态
```

**可能原因分析**：

| 现象 | 可能原因 | 解决方案 |
|---|---|---|
| `status: False` + 异常日志 | 舵机连续失败超过阈值 | 检查失败舵机连接，重启节点 |
| `status: False` 无日志 | 使能命令未送达 | 检查ROS网络，重新发布使能 |
| `JointPos` 无输出 | 读取线程异常 | 检查串口连接，查看线程日志 |
| `JointPos` 有输出但机械臂不动 | 瑞尔曼驱动问题 | 检查 `/rm_driver/Arm_Current_State` 错误码 |
| 机械臂报错 `0x1002` | 目标角度超限 | 调整 `init_qpos` 或检查零点校准 |
| 机械臂报错 `0x1003` | 奇异点不可达 | 调整主臂姿态避开奇异点 |
| 机械臂报错 `0x1007/0x1009` | 速度超限 | 降低 `max_joint_speed` |

**舵机异常专项排查**：
```bash
# 如果日志显示舵机异常，先检查硬件
# 1. 关闭节点
# 2. 使用串口工具测试异常舵机
picocom -dev/ttyUSB0 -b 115200
# 发送: #005PRAD! (测试5号舵机)

# 3. 如果无响应，检查：
#    - 舵机电源线是否松动
#    - 舵机信号线是否接触不良
#    - 舵机本身是否损坏

# 4. 修复后重启节点
```

#### 问题6：从臂运动方向相反

**解决**：
```bash
# 停止节点，修改方向参数
rosrun uarm realman_teleop_optimized.py \
    _joint_invert:="[1.0, 1.0, -1.0, 1.0, 1.0, 1.0]"
# 逐一测试，找到反向的关节
```

#### 问题7：运动抖动或延迟大

**可能原因分析**：

| 抖动类型 | 可能原因 | 解决方案 |
|---|---|---|
| **高频抖动** (快速振动) | 滤波系数过大 | 减小 `_filter_alpha:=0.1` |
| **低频抖动** (缓慢摆动) | 速度限制过低 | 增大 `_max_joint_speed:=40.0` |
| **间歇性抖动** | 舵机数据跳变 | 检查舵机供电和信号线 |
| **跟随滞后** | 网络延迟 | 使用有线连接代替WiFi |
| **响应慢半拍** | 队列延迟累积 | 正常现象，双线程设计如此 |
| **突然跳动** | 舵机读取失败恢复 | 检查串口连接稳定性 |

**解决**：
```bash
# 增大滤波系数（更平滑）
_filter_alpha:=0.1

# 或降低速度限制
_max_joint_speed:=20.0

# 检查网络延迟
ping 192.168.1.18
# 如果延迟高，使用有线连接

# 如果怀疑舵机数据问题，查看详细日志
rosrun uarm realman_teleop_optimized.py 2>&1 | tee teleop.log
grep "跳变\|超出范围\|失败" teleop.log
```

### 常见问题速查表

| 现象 | 可能原因 | 解决方案 |
|---|---|---|
| 从臂姿态与主臂相反 | 方向定义不同 | 修改 `joint_invert` 对应关节为 -1 |
| 从臂移动幅度过大 | 比例不匹配 | 减小 `joint_scale` 对应值 |
| 从臂初始姿态不对 | `init_qpos` 不匹配 | 调整 `init_qpos` 参数 |
| 某个关节不响应 | 超出限位 | 检查舵机角度是否在限位范围内 |
| 舵机无法释放力矩 | 串口被占用 | 检查是否有其他程序占用/dev/ttyUSB0 |
| 从臂抖动 | 滤波不够 | 减小 `filter_alpha` |
| 从臂响应慢 | 速度限制 | 增大 `max_joint_speed` |
| 数据丢失 | 网络不稳定 | 使用有线连接，增大`packet_loss_tolerance` |
| 发布频率低于30Hz | 系统负载高 | 关闭其他程序，检查CPU占用 |
| 读取频率低于7Hz | 串口延迟 | 检查USB线连接，尝试更换USB口 |
| **舵机PWM超范围** | 舵机返回异常值 | 检查舵机供电和信号干扰 |
| **舵机角度跳变警告** | 单帧变化过大 | 检查主臂是否被外力撞击 |
| **舵机连续失败** | 通信中断 | 检查舵机ID和总线连接 |
| **使能失败** | 有舵机异常 | 修复异常舵机或重启节点 |
| **时间回拨警告** | 系统时间被修改 | NTP同步导致，已自动保护 |

### 舵机数据异常专项排查表

| 错误日志 | 根本原因 | 紧急程度 | 处理方案 |
|---|---|---|---|
| `PWM值X超出范围[400, 2600]` | 舵机返回异常PWM | 中 | 检查舵机供电电压是否稳定 |
| `角度跳变: A→B (ΔX°)` | 单帧变化超过30° | 中 | 检查主臂是否有外力干扰 |
| `舵机X 连续失败N次` | 该舵机通信中断 | **高** | 立即检查该舵机连接 |
| `舵机[X]处于异常状态` | 连续失败超过阈值 | **高** | 修复前无法使能 |
| `检测到时间回拨` | 系统时间被修改 | 低 | 已自动保护，无需处理 |
| `数据丢失超过容限` | 整帧读取失败 | **高** | 检查串口和舵机总线 |
| `关节X越限` | 目标角度超限 | 中 | 调整init_qpos或零点 |

### 紧急处理

**机械臂失控时**：
```bash
# 方法1：发布急停
rostopic pub /realman_teleop/emergency_stop std_msgs/Bool "data: true"

# 方法2：直接停止驱动
rosnode kill /rm_driver

# 方法3：物理急停按钮
# 按下机械臂上的急停按钮
```

### 获取帮助

查看详细日志：
```bash
# 所有ROS日志
rosconsole echo

# 特定节点日志
rosrun rqt_console rqt_console

# 系统日志
tail -f ~/.ros/log/latest/*.log
```
---

## 附录：快速参考卡

### 启动命令速查

| 步骤 | 终端 | 命令 |
|---|---|---|
| 1 | 终端1 | `roscore` |
| 2 | 终端2 | `roslaunch rm_driver rm_65.launch` |
| 3 | 终端3 | `rosrun uarm realman_teleop_optimized.py` |
| 4 | 终端4 | `rostopic pub /realman_teleop/enable std_msgs/Bool "data: true"` |

> **注意**：不再需要启动 `servo_reader.py`！

### 常用话题速查

| 话题名 | 用途 | 查看命令 |
|---|---|---|
| `/realman_teleop/zero_angles` | 记录的舵机零点 | `rostopic echo /realman_teleop/zero_angles` |
| `/rm_driver/JointPos` | 发送给机械臂的角度 | `rostopic echo /rm_driver/JointPos` |
| `/rm_driver/Arm_Current_State` | 机械臂状态反馈 | `rostopic echo /rm_driver/Arm_Current_State` |
| `/realman_teleop/status` | 遥操作状态 | `rostopic echo /realman_teleop/status` |

### 参数配置速查

| 参数 | 默认值 | 说明 | 示例 |
|---|---|---|---|
| `init_qpos` | `[0,0,0,0,0,0]` | 瑞尔曼零点姿态 | `_init_qpos:="[0,-20,-90,0,90,0]"` |
| `joint_scale` | `[1,1,1,1,1,1]` | 关节缩放 | `_joint_scale:="[1,1,0.8,1,1,1]"` |
| `joint_invert` | `[1,1,1,1,1,1]` | 关节方向 | `_joint_invert:="[1,1,-1,1,1,1]"` |
| `filter_alpha` | `0.3` | 滤波系数 | `_filter_alpha:=0.1` |
| `max_joint_speed` | `30.0` | 速度限制 | `_max_joint_speed:=20.0` |
| `servo_serial_port` | `/dev/ttyUSB0` | 舵机串口 | `_servo_serial_port:="/dev/ttyUSB1"` |

### 节点退出后的状态

**当按下 Ctrl+C 退出遥操节点时**：

| 组件 | 状态 | 说明 |
|---|---|---|
| 遥操节点 | 停止运行 | 不再发布 `/rm_driver/JointPos` 话题 |
| 瑞尔曼机械臂 | **保持最后位置** | 由于不再收到新命令，保持在退出时的姿态 |
| 官方驱动 | 继续运行 | `rm_driver` 节点不受影响 |
| 舵机主臂 | 串口关闭 | 无法再通过本节点控制舵机 |

**⚠️ 注意**：
- 退出时机械臂会**突然停在当前位置**，不会自动回到零点
- 如果需要让机械臂回到安全姿态，**先手动控制回到零点再退出**
- 或先失能遥操作（`enable:=false`），再用其他方式控制机械臂

**安全退出流程**：
```bash
# 1. 先将主臂调整到安全姿态（手动调整）

# 2. 失能遥操作（让机械臂跟随到安全位置）
rostopic pub /realman_teleop/enable std_msgs/Bool "data: false"

# 3. 等待机械臂稳定后，再按 Ctrl+C 退出节点
```

### 控制命令速查

```bash
# 使能遥操作
rostopic pub /realman_teleop/enable std_msgs/Bool "data: true"

# 失能遥操作
rostopic pub /realman_teleop/enable std_msgs/Bool "data: false"

# 释放舵机力矩
rostopic pub /realman_teleop/release_servos std_msgs/Bool "data: true"

# 急停
rostopic pub /realman_teleop/emergency_stop std_msgs/Bool "data: true"

# 复位急停
rostopic pub /realman_teleop/emergency_stop std_msgs/Bool "data: false"
rostopic pub /realman_teleop/enable std_msgs/Bool "data: false"
rostopic pub /realman_teleop/enable std_msgs/Bool "data: true"
```

### 网络配置速查

```bash
# 检查机械臂连接
ping 192.168.1.18

# 有线连接时设置电脑IP
sudo ifconfig eth0 192.168.1.100 netmask 255.255.255.0

# 检查ROS网络配置
echo $ROS_MASTER_URI  # 应该是 http://localhost:11311
echo $ROS_IP          # 应该是本机IP
```

### 串口配置速查

```bash
# 查看串口设备
ls -la /dev/ttyUSB*

# 添加权限
sudo chmod 666 /dev/ttyUSB0

# 永久添加用户到dialout组
sudo usermod -a -G dialout $USER
# 然后重新登录
```
