STHY0425/LeRobot-Anything-U-Arm-main/src/simulation/mani_skill/utils/building/assets/floor_tiles_06_diff_2k_aligned.png

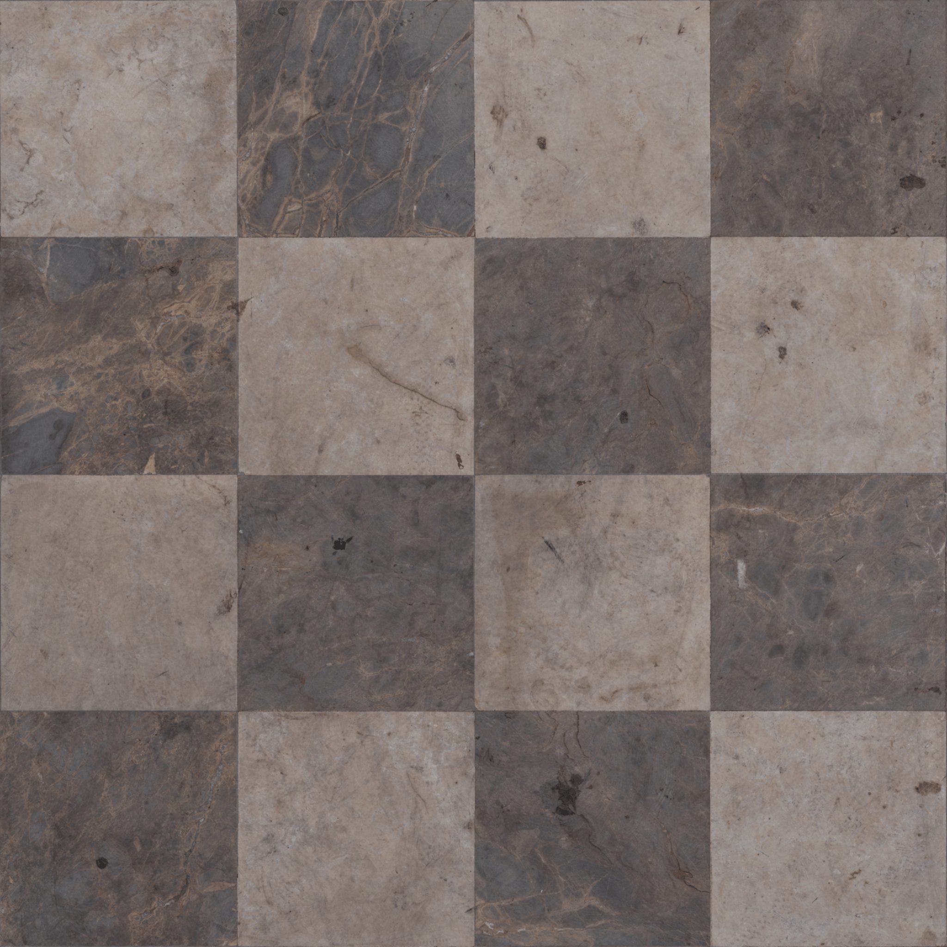
src/simulation/mani_skill/utils/building/assets/floor_tiles_06_diff_2k_aligned.png
