STHY0425/LeRobot-Anything-U-Arm-main/src/simulation/mani_skill/utils/building/assets/grid_texture.png

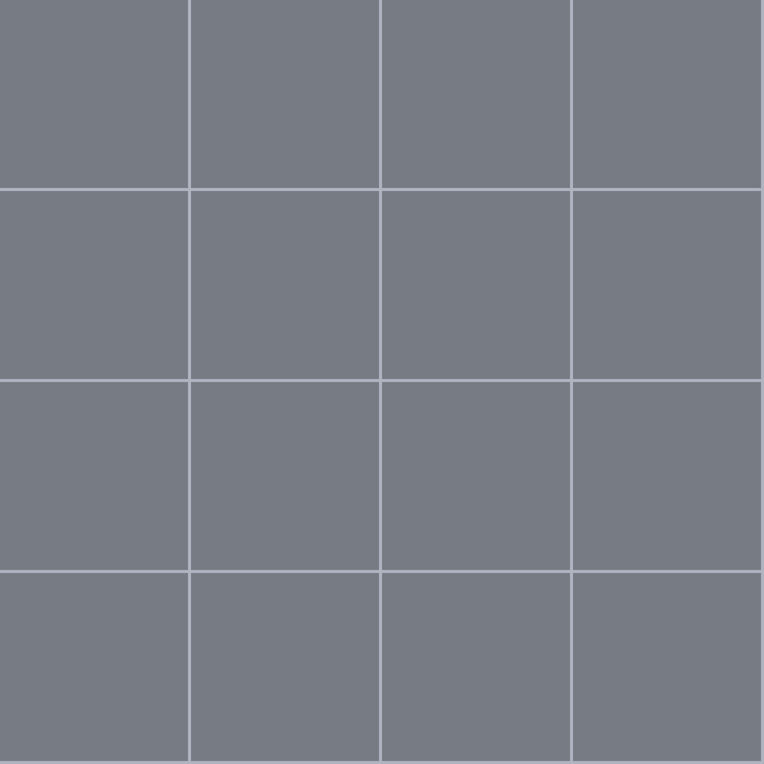
src/simulation/mani_skill/utils/building/assets/grid_texture.png
