STHY0425/LeRobot-Anything-U-Arm-main/src/uarm/scripts/Follower_Arm/realman/config/realman_safe_config.yaml

# RealMan (瑞尔曼)机械臂安全遥操配置文件

# 机械臂型号: RM_65, RM_75, ECO_65
core:
  arm_model: "RM_65"
  arm_ip: "192.168.1.18"
  dof: 6
  
  # 初始关节角度（度）
  init_qpos: [0.0, -20.0, -90.0, 0.0, 90.0, 0.0]

# 安全参数
safety:
  # 速度限制（度/秒）
  max_joint_speed: 30.0
  max_gripper_speed: 200.0
  
  # 发布频率（Hz）
  publish_rate: 30.0
  
  # 安全锁参数
  enable_emergency_stop: true
  error_check_interval: 0.1  # 秒
  comm_timeout: 0.5  # 通信超时（秒）

# 关节映射
mapping:
  # 关节角度缩放
  joint_scale: [1.0, 1.0, 1.0, 1.0, 1.0, 1.0]
  
  # 关节方向反转（1.0或-1.0）
  # 如果运动方向相反，将对应值改为-1.0
  joint_invert: [1.0, 1.0, -1.0, 1.0, 1.0, 1.0]
  
  # 夹爪映射参数
  gripper_min_deg: -10.0
  gripper_max_deg: 30.0
  gripper_range: 1000  # 0-1000

# 关节限位（度）- 根据型号自动加载
joint_limits:
  RM_65:
    min: [-178, -130, -135, -178, -130, -178]
    max: [178, 130, 135, 178, 130, 178]
  
  RM_75:
    min: [-178, -130, -135, -178, -130, -178]
    max: [178, 130, 135, 178, 130, 178]
  
  ECO_65:
    min: [-178, -130, -135, -178, -130, -178]
    max: [178, 130, 135, 178, 130, 178]
