STHY0425/LeRobot-Anything-U-Arm-main/(commit log)

2026-03-09 初始化项目代码
    [BL-M_Table_ASM_big.stl, BL-M_Table_ASM_small.stl, BL_Finger_Holder_SIM.stl, Base.stl, Base.stl.convex.stl, Base_Motor.stl, Base_Motor.stl.convex.stl, Body.stl]
2026-03-11 增加realman控制（version1）
2026-03-31 增加仿真过程中使用舵机6进行锁定的功能，避免因重力塌陷的情况
2026-04-01 优化舵机指令通信，增加实际控制文件和注释
2026-04-01 瑞尔曼控制修改成双线程
2026-04-01 修复仿真文件3号舵机反向问题
2026-04-07 增加安全数据检测和处理
2026-04-07 取消姿态预测
2026-04-09 实机测试成功修改
2026-04-09 修复readme文件，并且修复角度映射参数
2026-04-09 通讯修复尝试
2026-04-10 删除一些无关文件
2026-04-12 测试修改
2026-04-13 降低延迟
2026-04-13 修复文件名称
2026-04-13 舵机读取速率修复尝试
